soulhiler/Dengojui-Ardu/README.md

# Деньгожуй — XIAO ESP32-S3 Sense

Отдельный проект: прошивка камеры/телеметрии, привод TB6612FNG с платы, приложение **Android** (видео / мик / джойстик), скрипты на ПК (прокси, прошивка, OTA).

Воркспейс Cursor «It trane exp»; этот репозиторий — **`denzhogzhuy-ardu`**, не смешивается с веб‑тренажёром [IT](https://github.com/soulhiler/IT).

## Состав

| Путь | Назначение |
|---|---|
| `arduino_motor_test/` | **UNO + TB6612 по USB:** прошивка, веб‑джойстик, Serial — см. **`docs/arduino-motor-uno.md`** |
| `xiao_cam_stream/` | Основной скетч: Wi‑Fi, MJPEG, `/telemetry`, `/control`, `/drive`, PDM TCP :81, TB6612 (см. `drive_config.h`) |
| `xiao_cam_stream/xiao_drive.h`, `drive_config.h` | Моторы + энкодеры; TB6612 или sign‑magnitude |
| `xiao_ble_mic_test/` | Тест BLE и PDM‑микрофона |
| `xiao_cam_viewer.html` | Подсказка по просмотру потока |
| `android/XiaoRobot/` | Android: камера (`/stream`), мик (TCP `:81`), джойстик → `/drive` |
| `brain/` | ИИ‑«мозг» (Python): perceive→decide→act поверх HTTP‑контракта; `docs/brain-api.md`, 9 юнит‑тестов |
| `.github/workflows/build.yml` | CI: тесты `brain/`, сборка прошивки (`arduino-cli` + VL53L7CX), APK |
| `docs/dev-log.md` | Журнал разработки по фазам + отчёты об инцидентах |
| `docs/onboarding.md` | Инструкция новичку «с нуля» |
| `docs/security-history-cleanup.md` | Runbook чистки утёкшего Wi‑Fi пароля из git‑истории |
| `docs/cursor-chat-archives/` | Архив переписок Cursor (`.jsonl` + `.zip`) |
| `docs/hardware/wiring-xiao-motor-tof.md` | **Схема:** XIAO + TB6612 + VL53L7CX (пины, питание, GND, LPn) |
| `docs/hardware/` | **Анализ железа:** распайка, сенсоры/моторы, платы MCU/SBC, ориентация и модель пространства ([индекс](docs/hardware/README.md)) |
| `docs/incident-wifi-pc-router-2026-06-05.md` | Отчёт: сбой Wi‑Fi ПК / роутер Duangdeehouse2 / отладка XIAO (июнь 2026) |
| `tools/fix_pc_wifi_dihouse.ps1` | Восстановление профилей Duangdeehouse2 на ПК (запуск от администратора) |
| `tools/xiao_cam_proxy.py` | Прокси с платы на `localhost` (Cursor/браузер) |
| `tools/xiao_serial_telemetry.py` | Телеметрия: Serial / HTTP / BLE |
| `tools/xiao_flash_and_telemetry.ps1` | Прошивка по USB + авто‑порт USB‑JTAG + повторы upload |
| `tools/start_xiao_cam_proxy.ps1` | Фоновый прокси 8898 + опц. `/control` |
| `tools/bootstrap_arduino_cli.ps1`, `install_esp32_core.ps1` | `arduino-cli` и ядро `esp32:esp32` |
| `tools/upload_xiao_retry.ps1` | Повторная заливка при занятом COM |
| `tools/uno_motor_web.py`, `start_uno_motor_panel.ps1` | Веб‑панель джойстика для UNO (http://127.0.0.1:8765/) |
| `tools/uno_motor_serial.py` | Serial CLI для UNO+TB6612 |
| `docs/arduino-motor-uno.md` | Документация раздела UNO + моторы |
| `tools/build_apk.bat` в `android/XiaoRobot/` | См. `android/XiaoRobot/README.md` (JDK 17 / JBR) |
| `tools/xiao_wifi_ota.ps1` | OTA по Wi‑Fi |

Скопируйте `xiao_cam_stream/secrets.h.example` → `xiao_cam_stream/secrets.h` (файл в `.gitignore`).

## ⚠️ Безопасность питания (читать ПЕРЕД первой пайкой)

**Одну плату XIAO ESP32-S3 уже сожгли петлёй земли** (USB к ПК + батарея 7.4 В одновременно через общий минус → пробой ESD-защиты USB D+/D− → смерть USB-PHY). Полный разбор: [`docs/dev-log.md`](docs/dev-log.md). Чтобы не повторилось:

1. **НИКОГДА не подключай USB к ПК и батарею 7.4 В одновременно.** Прошиваешь по USB — отсоедини батарею. Тестируешь от батареи — отсоедини USB. Нужны оба — ставь USB-isolator (ADuM3160). Если USB-CDC уже мёртв, а Wi-Fi жив — шей по HTTP-OTA (`POST /update`, `tools/xiao_http_ota.py`) или ArduinoOTA `:3232`.
2. **ВСЕГДА измеряй выход DC-DC Buck мультиметром ДО подключения к XIAO 5V** — цель 5.0 В ± 0.1 В без нагрузки. Buck с AliExpress часто приходит выкрученным на 12+ В.
3. **Цвет провода = напряжение:** BAT+ (7.4 В) красный/жёлтый толстый; 5 В оранжевый тонкий; 3V3 оранжевый; GND **только чёрный**.
4. **Желательная защита** (схема цепи в [`docs/hardware/build_wiring.py`](docs/hardware/build_wiring.py)): BMS на батарее, PPTC-предохранитель + AO3401 (обратная полярность) на BAT+, Schottky SS14 на 5V, TVS USBLC6-2SC6 на USB D+/D−, осмотр пайки под лупой.

## Arduino UNO + TB6612 (USB, тест моторов)

Без XIAO/Wi‑Fi: Uno, драйвер TB6612, джойстик в браузере.

```powershell
.\tools\start_uno_motor_panel.ps1 COM3
```

→ http://127.0.0.1:8765/ · прошивка и провода: **`docs/arduino-motor-uno.md`**, каталог **`arduino_motor_test/`**.

## Прошивка XIAO

- FQBN: `esp32:esp32:XIAO_ESP32S3:PSRAM=opi`
- Версия: поля **`fw_version`** / **`fw_build`** в `GET /telemetry`
- Привод: `GET /drive?l=-255..255&r=...`, `GET /drive?stop=1`, `GET /control?...&drive=0|1`

## Android

См. **`android/XiaoRobot/README.md`**. Телефон и XIAO в одной Wi‑Fi.

## Быстрый старт Wi‑Fi

1. Заполните `secrets.h`.
2. Соберите и прошейте `xiao_cam_stream`.

Portable **`tools/arduino-cli/`** в `.gitignore`; можно запустить `tools/bootstrap_arduino_cli.ps1`.

## Телеметрия по USB

```bash
py -3 tools/xiao_serial_telemetry.py --port COM5 --http 8897
```

http://127.0.0.1:8897/

## Прокси к камере по LAN

```bash
py -3 tools/xiao_cam_proxy.py <IP_платы>
```

http://127.0.0.1:8898/ — первая строка `camera_ip.txt` = IP платы.

## Архив переписки Cursor

**`docs/cursor-chat-archives/README.md`** — формат JSONL, имена файлов и ZIP.

## Публикация на GitHub

Имя репозитория, например **`denzhogzhuy-ardu`**.

Веб‑тренажёр — отдельно: https://github.com/soulhiler/IT
