soulhiler/Dengojui-Ardu/docs/hardware/README.md

# Анализ железа

Раздел по железу проекта «Деньгожуй» (XIAO ESP32-S3 Sense): распайка, выбор
сенсоров/моторов, разбор плат-кандидатов, методы ориентации и построения модели
пространства. Часть документов — обзорные исследования (датированы, выбор позже
уточнялся в практике), часть — канон, синхронизированный с прошивкой.

Шаблон оценки новой платы — [`TEMPLATE.md`](TEMPLATE.md).

## Распайка и пины

- [**Распайка XIAO + TB6612 + VL53L7CX (+ MPU6050)**](wiring-xiao-motor-tof.md) — **канон**,
  синхронизирован с `drive_config.h`: пины моторов, I²C-шина D9/D10 (ToF + IMU), LPn, питание,
  чеклист перед включением.
- [**Схема подключения MPU6050 (GY-521)**](wiring-xiao-mpu6050-gy521.svg) — нарисованная схема
  IMU курса на общей I²C-шине (`.pdf`/`.png`/`.svg`, генератор `build_mpu6050_wiring.py`).
- [**Разводка и пины: анализ дефицита**](pinout-wiring-2026.md) — карта всех 11 пэдов XIAO, что
  занято приводом/ToF/IMU, где упрёшься при расширении, пути A (расширители) / B (гибрид).
- `build_wiring.py` — генератор схемы привода (schemdraw).

## Сенсоры и ориентация

- [**ToF VL53L7CX — лучшие практики**](vl53l7cx-best-practices.md) — конфиг, интерпретация
  `target_status`, фильтры качества, проекция зон в 3D + аудит нашего `xiao_tof.h`.
- [**Ориентация и картирование — решения**](orientation-and-mapping-decisions.md) — курс (IMU
  MPU6050/BNO085, без магнитометра), occupancy grid, когда реально нужен LiDAR. Decision-oriented.
- [**Сенсоры для робота (2026)**](sensors-2026.md) — обзорный каталог датчиков по категориям с
  привязкой к этапам автономности. _Обзор июнь-2026; конкретный выбор позже уточнён практикой
  (VL53L7CX вместо VL53L0X, MPU6050 как курс) — см. два документа выше._
- [**Моторы с энкодерами**](motors-2026.md) — выбор мотор-редукторов с AB-энкодерами (TT Encoder
  1:90, 4680 PPR) под `drive_config.h`, сколько брать на 4WD, токи, второй TB6612.

## Модель пространства и позиционирование

- [**Камера + ToF → модель пространства**](camera-tof-spatial-model.md) — конвейер построения и
  накопления 3D-модели помещения (XIAO — источник, сервер — счёт).
- [**Позиционирование по Wi-Fi**](wifi-localization-method.md) — RSSI/FTM/CSI: что реально даёт
  ESP32-S3, метод само-строящегося RSSI-отпечатка как якоря позиции.
- [**Оптимизация позиционирования и карты**](positioning-optimization.md) — разбор автоскана:
  ToF 8×8 + sharpener, релокализация курса (likelihood-field), ZUPT-bias IMU, что осталось.

## Платы: MCU vs SBC

- [**Платы для робота: MCU и SBC (2026)**](research-boards-2026.md) — сравнительный обзор двух
  классов плат, бенчмарки AI/зрения, ROS, камера/видео, питание, рекомендация гибрида MCU + SBC.
  _Обзор июнь-2026._
- [**Кандидат 1: бюджетный Linux-компаньон**](candidate-1-budget-compute.md) — разбор тира
  Pi Zero 2 W / Luckfox Pico Ultra W / Milk-V Duo: что умеют, как встроить к ESP32, грабли.
- [**Линейка Orange Pi (2026)**](orange-pi-lineup-2026.md) — детальный разбор Orange Pi как «мозга»
  Пути B (углубляет research-boards/candidate-1).
- [**Ландшафт лидаров (2026)**](lidar-landscape-2026.md) — 2D/3D-LiDAR, лестница апгрейда над
  forward-ToF, когда оправдан.
- [**Схема гибрида (Путь B)**](wiring-path-b.md) — конкретная разводка XIAO + Pi + сенсоры:
  пины, питание, I²C-адреса, линк ESP32↔Pi. Картинка: [diagrams/pinout-path-b.svg](diagrams/pinout-path-b.svg).

## Рассмотренные платы

| Плата | Класс | Вердикт | Разбор |
|---|---|---|---|
| Wireless-Tag ESP32P4C61-TINY | ESP32-P4 + ESP32-C61 (краудфандинг) | Избыточно/преждевременно — остаться на S3 | [esp32p4c61-tiny.md](esp32p4c61-tiny.md) |

## Текущее железо проекта

XIAO ESP32-S3 Sense — single-chip Arduino-решение: камера OV2640 (DVP, `esp_camera`,
MJPEG), PDM-микрофон, Wi-Fi 4 + BLE 5.0, microSD, зарядка от 3.7 В. На борту сейчас —
мультизонный ToF VL53L7CX и IMU MPU6050 (курс) на общей I²C-шине. Закрывает текущие
задачи робота; зрение/SLAM — перспектива Пути B (SBC). Подробности — в корневом `README.md`.
