soulhiler/Dengojui-Ardu/docs/hardware/power-decoupling.md

# Развязка питания: чтобы моторы не роняли плату/IMU/WiFi

**Проблема (наблюдалась в сессии 2026-06):** при бросках тока моторов плата
проседает — отваливается WiFi, дёргается IMU (MPU6050 → `imu_ok=0`), команды
`/drive` не доходят, watchdog глушит моторы. Это **петля земли + просадка общего
питания**: импульсный ток моторов (амперы) течёт по общим тонким проводам и
«земле» → просадка напряжения и помеха, которую видят чувствительные узлы (ADC
IMU, радио WiFi, MCU). Тот же корень, что в инциденте со «смертью платы» от
USB+батарея.

Лечится тремя вещами: **(1) bulk-конденсаторы** гасят броски у источника,
**(2) развязка-конденсаторы** держат чистым питание чувствительных узлов,
**(3) ЗВЕЗДА по земле** — ток моторов не течёт через землю логики/сенсоров.

---

## Топология (главное — звезда по земле)

```
Батарея(+) ─┬─────────────► TB6612 VM   (моторное питание, толстый провод)
            │
            └─► Buck ──► 5V/3V3 ──► XIAO ──► 3V3 ──► MPU6050, VL53L7CX

Батарея(−) ●  ← ЕДИНАЯ ТОЧКА ЗЕМЛИ (звезда):
            ├── земля моторов / TB6612 GND   (толстый провод, отдельно!)
            ├── земля XIAO
            └── земля сенсоров
   ВСЕ «земли» сходятся ТОЛЬКО здесь, не последовательно через XIAO.
```

**Почему звезда:** если земля моторов идёт «транзитом» через землю XIAO/сенсоров,
импульсный ток моторов создаёт на этом проводе падение напряжения (ground bounce) —
для IMU/радио это шум/просадка. Звезда уводит обратный ток моторов прямо в батарею,
мимо чувствительной земли.

---

## Конденсаторы — что и куда (по приоритету)

| # | Куда | Номинал | Тип | Зачем |
|---|---|---|-----|---|
| 1 | **TB6612 VM ↔ GND**, у самого драйвера | **1000 мкФ** (≥16 В) | электролит low-ESR | Главный bulk: гасит броски тока моторов у источника |
| 2 | **Рейл логики** (выход Buck / 5V XIAO) ↔ GND | **470 мкФ** (≥10 В) + **0.1 мкФ** | электролит + керамика | Держит питание MCU/WiFi при просадке |
| 3 | **MPU6050 VCC ↔ GND**, у модуля | **10 мкФ** + **0.1 мкФ** | керамика | Чистое питание IMU — убирает дёрганье `imu_ok` |
| 4 | TB6612 VCC(лог. 3.3В) ↔ GND | **0.1 мкФ** | керамика | Развязка логики драйвера |
| 5 | На клеммах каждого мотора | **0.1 мкФ** (×1–3) | керамика | Гасит щёточный шум/EMI мотора |

Электролиты — соблюдай **полярность** (минус-полоса к GND). Керамику ставить
**как можно ближе** к выводам узла (короткие ножки = меньше индуктивность).

---

## Провода и батарея

- **Толстые провода** на моторное питание (VM) и его землю — там амперы. Тонкие
  провода = просадка под нагрузкой (часть нашей проблемы).
- **Моторное VM — напрямую от батареи**, НЕ через buck/регулятор логики (моторы
  терпят просадку напряжения, логика — нет; и так buck не перегружается броском).
- **Батарея с запасом по току:** 2S LiPo, ёмкость ≥1000 мА·ч, разряд **≥10C**.
  Слабая/подсевшая батарея проседает под броском → brownout (что и видели — за
  сессию активной езды батарея «садилась» и плата отваливалась под мотором).
- Идеал (если возможно): **отдельная батарея на моторы** и на логику, земли — в
  одну звезду. Полностью разрывает связь «мотор → логика».

---

## Порядок внедрения (от простого к полному)

1. **Звезда по земле** (бесплатно, главный эффект): свести все GND в одну точку у
   батареи, моторную землю — отдельным толстым проводом.
2. **Cap #1 (1000 мкФ на VM)** — самый большой выигрыш от одного конденсатора.
3. **Cap #3 (10µF+0.1µF на MPU6050)** — стабилизирует IMU для heading-hold.
4. **Cap #2 (470µF+0.1µF на рейле логики)** — стабилизирует WiFi/MCU.
5. Caps #4, #5 — добивка по EMI.

После #1–#3 ожидаем: WiFi/IMU держатся под мотором → надёжный heading-hold →
контролируемые проезды → чистые замкнутые петли (B.3) и большие карты комнат.

## Проверка результата
Тест из сессии: `tools/loop_slam.py` (или импульсный спин) — раньше под мотором
шло **0–1 чтение телеметрии**; после развязки должно идти стабильно, `imu_ok`
держаться 1, `wifi_rssi` не проваливаться. ⚠ И НИКОГДА USB+батарея одновременно
(петля земли — отдельный известный инцидент, см. docs/security/power).
