soulhiler/Dengojui-Ardu/docs/hardware/motors-2026.md

# Моторы с энкодерами для «Деньгожуй» (2026)

> Выбор мотор-редукторов с квадратурными энкодерами под текущую прошивку (`drive_config.h`
> рассчитан на AB-энкодеры `DRIVE_ENC_*_A/B`, привод TB6612, дифференциальный 4WD/skid-steer).
> Итог: брать **TT Motor с AB-энкодером (чёрный, 1:90 / 175 об/мин)**, 2 шт. с энкодером на 4WD.

## Зачем именно энкодерные

Прошивка считает **квадратуру A/B** → скорость **и направление**. Поэтому:
- ❌ обычный мотор + щелевой ИК-диск (LM393) = один канал, без направления — не подходит.
- ✅ нужен мотор с **холловским AB-энкодером** (6 проводов: M+, M−, VCC, GND, A, B).

Показанные в магазине обычные TT/JB (JB207/JB209, жёлтый MT048, чёрный 1:48) — **без энкодеров**.

## Сравнение двух энкодерных вариантов

| | Вариант 1 (синий, метал 110rpm) | **Вариант 2 (чёрный TT Encoder)** ✅ |
|---|---|---|
| Энкодер AB | да, **PPR не указан** (обычно низкий) | да, **2 496 PPR (1:45) / 4 680 PPR (1:90)** на оборот колеса |
| Разъём | голые 6 проводов | **JST PH2.0 6-pin + кабель** (plug-and-play) |
| Шестерни | полный металл | полуметалл (металл+пластик) |
| Напряжение мотора | 6–12 В | **3–12 В** |
| Питание Холла | 3.3–5 В | 3.3–5 В |
| Вал | двухвальный (แกนคู่) | одновальный |
| Документация PPR | нет | есть (Yahboom encoder) |
| Цена | ฿208 | ฿279 |

**Выбор: Вариант 2 (чёрный), вариация 1:90 / 175 об/мин / 4 680 PPR** — высокое и документированное
разрешение энкодера (точная одометрия под будущий SLAM) + готовый разъём. 1:45/350 об/мин — только
если нужна скорость в ущерб моменту/точности.

## Спецификация выбранного (чёрный TT Encoder, 1:90)

| Параметр | Значение |
|---|---|
| Передаточное / скорость | 1:90 / 175 об/мин @6 В |
| Момент | ~2.4 kgf·cm |
| Напряжение мотора | 3–12 В (на 7.4 В 2S работает напрямую) |
| Ток | без нагрузки ≤200 мА, **стопор ~1.2 А** |
| Энкодер | магнитный Холл, AB-квадратура, square wave |
| Питание энкодера | 3.3–5 В (→ ESP32 напрямую) |
| Разрешение | **4 680 PPR** на оборот выходного вала |
| Разъём | JST PH2.0 6-pin (кабель в комплекте) |

## Совместимость и распиновка (под `drive_config.h`, без правок прошивки)

- **3–12 В мотор** → VM TB6612 = аккумулятор 7.4 В (отдельный buck на моторы не нужен).
- **Энкодер 3.3–5 В** → прямо в ESP32 (без преобразователя уровней).
- **AB-квадратура** → совпадает с `DRIVE_ENC_*_A/B`.

```
Encoder VCC → 3.3 В (ESP32 3V3)        Encoder GND → GND (общая)
Phase A (жёлтый) → D6/GPIO43 (лев.) , D8/GPIO7  (прав.)
Phase B (синий)  → D7/GPIO44 (лев.) , D9/GPIO8  (прав.)
Motor + (красный) / Motor − (чёрный) → TB6612 AO1/AO2 (лев.) , BO1/BO2 (прав.)
```
Колесо крутится «не туда» → поменять M+/M− (направление) или A/B (знак счёта).

## Сколько брать на 4 мотора (4WD)

Привод **дифференциальный (skid-steer)**: оба колеса борта вращаются синхронно, поэтому одометрии
хватает **одного энкодера на сторону** → **2 энкодерных мотора (1 левый + 1 правый)**, остальные 2 —
обычные. 4 энкодера нужны только при независимом управлении каждым колесом (меканум/полный 4WD), чего
в нашей прошивке нет.

⚠️ **Все 4 мотора на бортах должны быть одинаковые по об/мин** — два мотора одной стороны работают
параллельно на одном канале; разные модели «дерутся» (один тянет, другой тормозит). Идеально — все 4
одной модели (TT 1:90), из них 2 с энкодером + 2 без.

## ⚠️ Ток и драйвер при 4 моторах

2 мотора на канал = ток складывается. TT-мотор стопор ~1.2 А ×2 = ~2.4 А, а **TB6612 держит ~1.2 А
непрерывно на канал** (3.2 А пик) → один TB6612 на 4 мотора **на пределе**.

**Решение без новых пинов:** поставить **второй TB6612**, а его 6 логических входов завести
**параллельно** первому (те же D0–D5). Тогда каждый драйвер крутит по 2 мотора (один на сторону),
ток делится между драйверами, а **GPIO не добавляется** (важно — на XIAO свободных пинов нет, см.
[pinout-wiring-2026.md](pinout-wiring-2026.md)). Альтернатива — более мощный драйвер (напр. сдвоенный).

## Отдельные энкодеры на TT-мотор (ретрофит к имеющимся)

Если не менять текущие 4 мотора, а **докрутить энкодер**. Главное: прошивка считает квадратуру A/B
(направление + скорость), а большинство «отдельных» энкодеров — одноканальные (только скорость).

| Решение | Тип | Канал | Разрешение | Куда ставится | Цена 2026 | Под нашу прошивку |
|---|---|---|---|---|---|---|
| **FC-03 / LM393 + щелевой диск** | оптика | **1 (скорость)** | низкое: 20/об на колесе | диск на валу + модуль на шасси | ~$1–2 | ⚠️ нет направления → правка кода |
| 2× FC-03 со сдвигом 90° | оптика | 2 (квадратура) | низкое | сложно выставить | ~$3 | теоретически да, возни много |
| **AS5600 магнитный** | холл, абс. угол | угол/направление | **высокое (4096/об)** | магнит на торце вала + плата соосно | ~$3–6 | ✅ но I²C-адрес фикс. 0x36 → на 2 колеса нужен TCA9548A/PWM |
| Hall AB кольцо | холл | 2 (квадратура) | высокое | кольцо на **задний вал** | ~$3–5 (найти сложно) | ✅ но это по сути и есть «энкодер-мотор» |

**Что важно:**
- **Нужен задний (двухвальный) вал** — AS5600/Hall-кольцо/диск на быстром валу ставятся на задний
  вал. Одновальный мотор → только внешний диск на колесе (один канал, грубо).
- **Разрешение зависит от места:** щелевой диск на колесе = 20/об; на заднем (быстром) валу =
  20 × передаточное (×90 ≈ 1800/об колеса). У интегрированного энкодера — тысячи/об.
- **Одноканальный = нет направления:** FC-03 даёт только скорость → в прошивке брать направление из
  знака команды (`gDrive.cmd`); не определит проскальзывание/толчок назад.
- **AS5600:** лучший «отдельный» по точности и с направлением, но фикс. адрес 0x36 (мультиплексор/PWM
  на 2 колеса) и соосный монтаж магнита; на XIAO ещё и дефицит пинов (см.
  [pinout-wiring-2026.md](pinout-wiring-2026.md)).
- **EMI:** щётки наводят помехи на оптику → 100 нФ на питание датчика, короткие/экранированные провода.

**Плюс ретрофита:** все 4 мотора остаются одной модели → нет проблемы «моторы на борту дерутся».

**Вердикт по ретрофиту:**
- Двухвальные моторы → AS5600 на задний вал (направление + 4096/об) или щелевой диск (скорость).
- Одновальные → проще купить 2 энкодер-мотора, чем колхозить.
- Истинная квадратура ретрофитом по цене+возне ≈ новый энкодер-мотор ($6–8), но механика хуже.

## Открытые вопросы (уточнить перед покупкой)

- **Модель/обороты текущих 4 моторов** — чтобы решить: докупить 2 энкодерных совпадающих или менять
  весь комплект на одинаковые.
- **Одно- или двухвальные** текущие моторы — от этого зависит, реален ли ретрофит энкодера.
- **Точный PPR/число полюсов** энкодера — для пересчёта тиков на оборот колеса в одометрии.
- Нужен ли **второй TB6612** (по току) — см. выше.

## Источники

- [DFRobot FIT0450 — TT с энкодером](https://wiki.dfrobot.com/fit0450/),
  [Yahboom TT Encoder motor (docs)](http://www.yahboom.net/study/Encoder-TT-motor),
  [Adafruit N20 magnetic encoder (альтернатива)](https://www.adafruit.com/product/4640),
  [квадратурный энкодер + Arduino](https://zbotic.in/motor-encoder-interfacing-quadrature-encoder-with-arduino/)
- Ретрофит-энкодеры — [FC-03/LM393 IR speed sensor](https://www.teachmemicro.com/lm393-ir-module-motor-speed-sensor/),
  [оптика vs магнитный энкодер](https://zbotic.in/motor-speed-sensor-optical-vs-magnetic-encoder-comparison/),
  [AS5600 (Seeed wiki)](https://wiki.seeedstudio.com/Grove-12-bit-Magnetic-Rotary-Position-Sensor-AS5600/)
- TB6612FNG — [Toshiba datasheet](https://toshiba.semicon-storage.com/info/TB6612FNG_datasheet_en_20141001.pdf)
  (1.2 А/канал непрерывно, 3.2 А пик)
