soulhiler/Dengojui-Ardu/docs/hardware/lidar-landscape-2026.md

# Ландшафт лидаров 2026: контекст и лестница апгрейда

> Конспект внешнего обзора (июнь 2026) — что полезно нашему проекту. Наша
> рабочая рекомендация по картам остаётся в `orientation-and-mapping-decisions.md`
> (2D LD06/LD19 ~$70 + 4-ГБ SBC). Этот файл — **тир выше** и индустриальный
> контекст: куда расти, если 2D-среза не хватит.
>
> ⚠ Цены — розничные ориентиры на июнь 2026 с реселлеров, быстро меняются;
> перепроверять перед покупкой. Источник — обзор-сводка, не первичные даташиты.

## Почему это важно знать

Наша SLAM-ветка стартует с дешёвого **2D-лидара** (плоский срез, LD06/LD19).
Его потолок — одна горизонтальная плоскость: видит стены на своей высоте, не
видит низкие/высокие препятствия и геометрию объёма. Когда упрёмся в это —
следующая ступень — **3D-лидар** (облако точек). Ниже — где сидят ступени.

## Лестница моделей (розница, не автомобильные OEM)

| Модель | Цена~ | Тип | Покрытие / дальность | Кому |
|---|---|-----|---|---|
| **LD19 / LD06 / RPLIDAR A1** | **~$70–200** | 2D механика | плоский срез, ~12 м | **наш вход** (2D SLAM) |
| **Unitree 4D L2** | ~$395 | 3D вращающийся | 360°, ~30 м | **дешёвый вход в 3D-облако** |
| **Livox Mid-360** | от ~$899 | гибрид solid-state | **360°×59°, 100 м (40 м @10%)**, мин. 10 см, IP67 | **стандарт мобильной робототехники** |
| RoboSense Airy | от ~$1099 | solid-state | 96 лучей, 360° | плотнее Mid-360 |
| Livox Mid-70 / Avia | ~$1.3k / ~$2.1k | гибрид solid-state | узкий FOV, до 450 м (Avia) | дальность, дроны |
| Ouster OS1 | неск. тыс. | цифровой механич. | 64/128 кан., 90 м @10% | западная поддержка, маппинг |
| Emesent Hovermap STX | десятки тыс. | турнкей-SLAM | 300 м, >1 млн точек/с | enterprise, пещеры под ключ |

**Ключевые ступени для нас:**
- **2D → 3D дёшево:** Unitree L2 (~$395) — учебный вход в облако точек; вертикальный обзор узкий, дальность скромная, но понятно «чего не хватает».
- **Чемпион баланса:** **Livox Mid-360** (~$899) — де-факто стандарт; под него заточена open-source SLAM-экосистема (**FAST-LIO / Point-LIO работают из коробки**). Реселлеры прямо позиционируют как замену Velodyne VLP-16 / Ouster OS1-16: новее, дешевле, вдвое шире вертикаль. Вращается только маленькое зеркало внутри.

> Для нашего класса робота Mid-360 — избыточен (цена ≈ всего остального робота
> ×10 и питание/вес другого порядка). Это «когда вырастем в серьёзный маппинг»,
> а не сейчас. Сейчас потолок здравого смысла — 2D LD06/LD19.

## Технологический ликбез (общее)

- **ToF** (time-of-flight): импульс → время возврата → дистанция. Дёшево, доминирует
  (наш LD06/LD19 и VL53L7CX — оба ToF). Минусы: уязвим к солнцу/чужим лидарам, не
  видит скорость.
- **FMCW** (4D): непрерывный луч с качающейся частотой; на возврате — частота биений
  → сразу дистанция **и доплеровская скорость** каждой точки. Когерентное
  детектирование → не слепнет от солнца и соседних лидаров. Расплата — дорогой
  лазер/фотоника. Растёт быстро, но дорого; для хобби пока не вход.
- **«Solid-state» — грязный термин:** большинство «solid-state» на рынке —
  **полу-твердотельные** (неподвижный корпус, но внутри MEMS-зеркало/призма
  крутятся). True solid-state (flash, OPA) пока упирается в дальность/цену.

## Расклад индустрии (зачем нам — доступность и цены)

- **Цены рухнули, рынок в Китае:** RoboSense/Hesai/Huawei/Seyond держат >99% авто-рынка;
  Hesai режет прайс ~вдвое, RoboSense вывел серию MX дешевле $200. Запад буксует
  (Velodyne+Ouster слились в 2023, Quanergy банкрот). Для нас = дешёвые модули
  доступны и дешевеют.
- **Лидар пивотит из машин в роботов:** часть автопрома (Tesla) ушла в чистое
  зрение, производители агрессивно идут в робототехнику (Hesai XT в роботах Unitree,
  у RoboSense робо-поставки ×27 за год). Восприятие для роботов может стать
  категорией крупнее авто-лидара → больше дешёвого железа под наши задачи в ближайшие годы.

## Что это меняет в наших решениях

Ничего в ближней перспективе: для нашего робота остаётся **2D LD06/LD19 (~$70) +
4-ГБ SBC + slam_toolbox** (см. `orientation-and-mapping-decisions.md`). Этот документ —
карта ступеней над нами: если 2D-срез окажется мал → **Unitree L2 (~$395) для 3D**,
а «взрослый» маппинг (FAST-LIO) — это уже **Livox Mid-360 (~$899)**, другой класс
бюджета/питания. FMCW/Mid-70/Ouster/Hovermap — вне нашего тира, держим как контекст.

---

*Источник: внешний обзор-сводка (рыночные отчёты Mordor/Polaris/SNS/Straits,
Yicai/SCMP, страницы Livox/Ouster/Emesent и реселлеров, eBay по б/у). Цифры и цены —
на дату документа, требуют перепроверки.*
