soulhiler/Dengojui-Ardu/docs/hardware/orange-pi-lineup-2026.md

# Linux-компаньон: вся линейка Orange Pi (обзор 2026)

> Контекст: к роботу на **XIAO ESP32-S3** рассматриваем маленький Linux-компьютер
> для зрения/CV — ESP32 остаётся «спинным мозгом» (моторы, ToF, мик, realtime),
> Linux берёт камеру/детекцию/сеть. Этот файл — разбор всей линейки **Orange Pi**
> как одного из кандидатов. Сравнение с Raspberry Pi и другими — в
> ветке исследования `docs/hardware/research-boards-2026.md` (Путь B).

## Про бренд

Orange Pi (Shenzhen Xunlong) — большое семейство одноплатников на чипах
**Allwinner** и **Rockchip**. Почерк: характеристики/цена лучше Raspberry Pi,
расплата — **софт**. Вместо вылизанного Raspberry Pi OS здесь Armbian /
Orange Pi OS: камеру, драйверы, ISP часто приходится доводить руками, комьюнити
меньше. Для проекта это главный риск (камера/CV — вся суть компаньона).

## 1. Zero-серия — маленькие, дешёвые (наша зона)

| Плата | SoC | RAM | Сеть | Размер | Для робота |
|---|-----|-----|---|---|---|
| Zero / Zero LTS | H2+/H3, 4×A7 | 256–512 МБ | — | мини | ❌ старое |
| **Zero 2** | H616, 4×A53 1.5 ГГц | 512 МБ / 1 ГБ | Gigabit Eth | 53×60 мм | ⚠ крупнее, Ethernet лишний |
| **Zero 2W** | H618, 4×A53 1.5 ГГц | 1 / 1.5 / 2 / **4 ГБ** LPDDR4 | Wi-Fi 5 + BT 5 | **30×65 мм** | ✅ **лучший фит** |
| **Zero 3** | H618, 4×A53 | 1–4 ГБ | Gigabit Eth | 50×55 мм | ⚠ как 2W, но крупнее + Ethernet |

«W» = компактный Pi-Zero-формат без Ethernet. Без W — крупнее, с Ethernet
(мини-сервер, не мобильный робот).

## 2. Мейнстрим — формат Pi 3/4

| Плата | SoC | RAM | Фишка |
|---|-----|-----|---|
| Orange Pi PC / One / Lite | H3 | 0.5–1 ГБ | старые, дёшево |
| Orange Pi 3 LTS | H6, 4×A53 | 2 ГБ + 8 ГБ eMMC | Gigabit, eMMC на борту |
| Orange Pi 4 LTS | RK3399, 2×A72+4×A53 | 4 ГБ | мощнее, прожорлив |
| **Orange Pi 3B** | RK3566, 4×A55 1.8 ГГц | 2 / 4 / 8 ГБ | **NPU 0.8 TOPS**, M.2 NVMe |

## 3. Флагманы — серьёзный AI (RK3588)

| Плата | SoC | RAM | NPU |
|---|-----|-----|-----|
| Orange Pi 5 / 5B | RK3588S, 4×A76+4×A55 | до 16/32 ГБ | **6 TOPS** |
| Orange Pi 5 Plus / 5 Max | RK3588 (полный) | до 32 ГБ | 6 TOPS, 2.5GbE, M.2 |
| Orange Pi 5 Pro / Ultra | RK3588(S) | разные | 6 TOPS |
| Orange Pi CM5 | RK3588S (модуль) | — | 6 TOPS |

«Настоящий мини-ПК»: YOLO в реальном времени, несколько камер, 8K. Но большой,
греется, ест 5–10+ Вт, нужно отдельное питание — для маленького робота избыточно.

## 4. Специальные

- **Orange Pi AI Pro** — Huawei Ascend, **8 или 20 TOPS**, 8–24 ГБ; под edge-инференс, крупный.
- **Orange Pi RV / RV2** — RISC-V (софт ещё сырее).
- **Orange Pi 800** — плата в клавиатуре (как Pi 400).
- **Orange Pi Neo** — игровая «портативка».
- **CM4 / CM5** — compute-модули (RK3566 / RK3588S) под свою плату-носитель.

## Вывод под наш робот

- **Лёгкий компаньон по зрению к XIAO** → **Zero 2W на 4 ГБ** — единственный из
  Orange, что подходит по размеру/весу/питанию; 4 ГБ закрывают узкое место по RAM.
- **Хочешь NPU компактно** → **Orange Pi 3B** (0.8 TOPS, M.2), но это размер Pi 4.
- **Серьёзный AI, размер не важен** → **Orange Pi 5** (6 TOPS), другой класс робота
  с нормальным питанием.

Альтернатива без софт-боли — **Raspberry Pi Zero 2 W** (512 МБ, но «всё работает»):
наша записка `candidate-1-budget-compute.md` (ветка исследования) выбрала именно его
за экосистему/простоту. Решение Orange vs RPi = «больше RAM/дешевле, но возня» против
«слабее железо, но без боли с камерой».
