soulhiler/Dengojui-Ardu/docs/hardware/diagrams/pinout-path-b.png

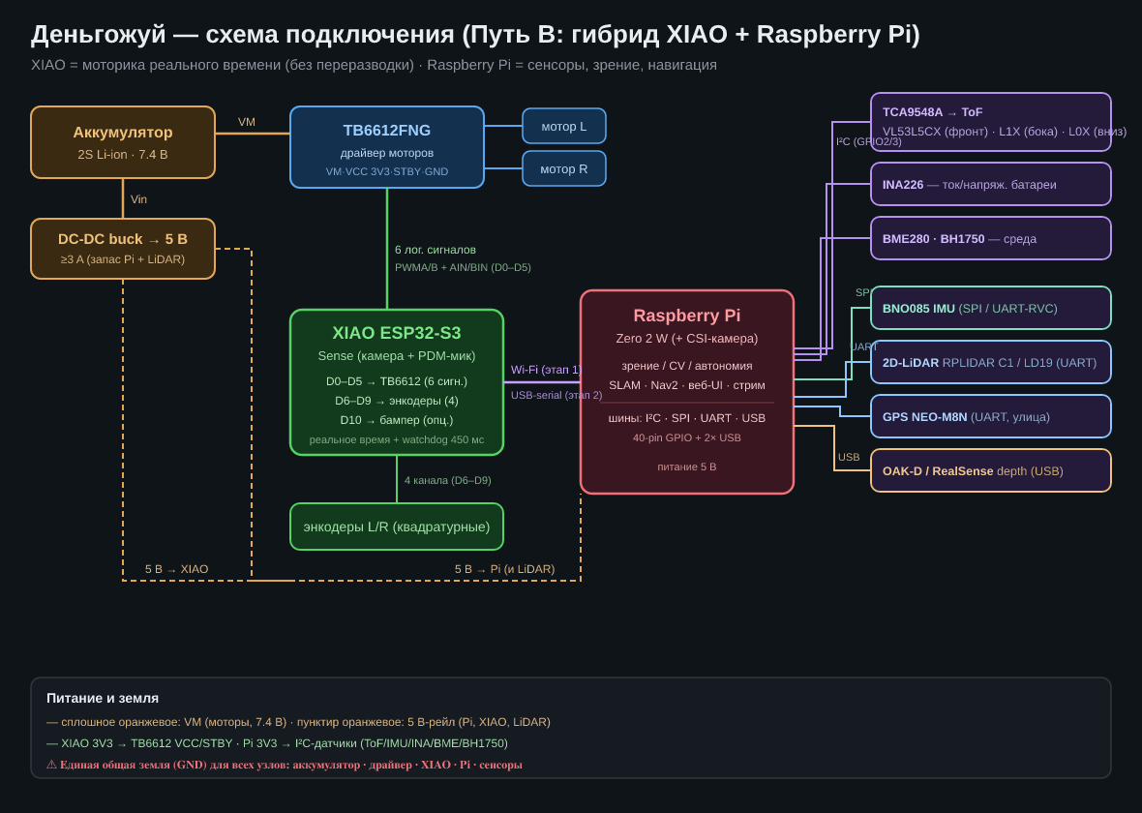
docs/hardware/diagrams/pinout-path-b.png
