soulhiler/Dengojui-Ardu/docs/hardware/wiring-xiao-motor-tof.md

# Распайка: XIAO ESP32-S3 + TB6612 + VL53L7CX

Пины из **`xiao_cam_stream/drive_config.h`** (прошивка build 16+, ToF — **VL53L7CX**, мультизонный 4×4/8×8).

> Работает и **с камерой Sense**, и без: все сигналы ниже идут только на внешние пины D0–D10. Внутренние линии камеры (GPIO 10–18, 38–48), мик (41–42) и LED (21) не трогать.

---

## Общая схема (блоки)

```mermaid
flowchart LR
  subgraph power["Питание"]
    USB["USB 5V → XIAO"]
    BAT["Батарея 6–12 V → VM"]
    GND["Общая GND"]
  end

  subgraph xiao["XIAO ESP32-S3"]
    MCU["Логика 3.3 V"]
  end

  subgraph drv["TB6612FNG"]
    STBY["STBY"]
    VM["VM"]
    VCC["VCC 3.3 V"]
  end

  subgraph mot["Моторы DC"]
    ML["Левый"]
    MR["Правый"]
  end

  subgraph tof["VL53L7CX"]
    I2C["I2C + LPn"]
  end

  USB --> MCU
  MCU --> VCC
  MCU --> STBY
  BAT --> VM
  GND --- MCU
  GND --- drv
  GND --- BAT
  VM --> ML
  VM --> MR
  drv --> ML
  drv --> MR
  MCU -->|"PWM + DIR"| drv
  MCU -->|"SDA/SCL"| I2C
```

---

## Питание и земля

```
                    ┌─────────────────┐
   USB 5V ──────────│ 5V   XIAO   GND │──────────┐
                    │ 3V3          │          │
                    └───────┬──────┘          │
                            │                 │
                     3.3 V ─┼─ VCC TB6612    │
                     3.3 V ─┼─ STBY (или    │
                            │   перемычка)  │
                            │                 │
   Батарея 6–12 V ── VM ───┤ TB6612          │
   (только моторы!)         │                 │
                            └──── GND общая ◄┘
                                   │
                            VL53L7CX GND
```

| Точка | Куда | Примечание |
|---|---|---|
| **GND** | XIAO GND = GND TB6612 = GND VL53L7CX = «−» батареи VM | **Обязательно общая земля** |
| **3V3** XIAO | TB6612 **VCC** (логика), VL53L7CX **VIN** + **LPn** | Только 3.3 V: при питании 5 V подтяжки SDA/SCL уйдут на 5 V — пины ESP32 не 5V-tolerant |
| **5V** XIAO | Не кормить TB6612 VM | 5V — только USB/плата |
| **VM** TB6612 | Батарея 6–12 V (или отдельный БП моторов) | Силовое питание моторов |
| **USB + батарея одновременно** | Избегать | Риск просадки/контуров; одна XIAO уже сгорала при плохой разводке GND |

`DRIVE_STBY_PIN = -1` → **STBY закоротить на 3.3 V** (драйвер всегда включён).

---

## TB6612 ↔ XIAO (моторы)

```mermaid
flowchart TB
  subgraph XIAO["XIAO (подпись на плате)"]
    D0["D0  GPIO1"]
    D1["D1  GPIO2"]
    D2["D2  GPIO3"]
    D3["D3  GPIO4"]
    D4["D4  GPIO5"]
    D5["D5  GPIO6"]
    D8["D8  GPIO7"]
    D6["D6  GPIO43"]
    D7["D7  GPIO44"]
  end

  subgraph TB["TB6612FNG"]
    PWMA["PWMA"]
    AIN1["AIN1"]
    AIN2["AIN2"]
    PWMB["PWMB"]
    BIN1["BIN1"]
    BIN2["BIN2"]
  end

  D5 --> PWMA
  D0 --> AIN1
  D1 --> AIN2
  D4 --> PWMB
  D2 --> BIN1
  D3 --> BIN2

  PWMA --> MA["Мотор A (левый)"]
  AIN1 --> MA
  AIN2 --> MA
  PWMB --> MB["Мотор B (правый)"]
  BIN1 --> MB
  BIN2 --> MB
```

| TB6612 | XIAO (шелк) | GPIO | Роль |
|---|---|---|---|
| **PWMA** | **D5** | 6 | ШИМ левый |
| **AIN1** | **D0** | 1 | Левый, направление |
| **AIN2** | **D1** | 2 | Левый, направление |
| **PWMB** | **D4** | 5 | ШИМ правый |
| **BIN1** | **D2** | 3 | Правый, направление |
| **BIN2** | **D3** | 4 | Правый, направление |
| **STBY** | **3.3 V** | — | HIGH = драйвер активен |
| **VCC** | **3.3 V** | — | Логика |
| **GND** | **GND** | — | |
| **VM** | **6–12 V** | — | Питание моторов |
| **AO1, AO2** | Левый мотор | | |
| **BO1, BO2** | Правый мотор | | |

Полярность моторов: если едет «назад» — поменять местами провода **AO1↔AO2** или **BO1↔BO2**.

---

## MPU6050 (GY-521) ↔ XIAO — IMU курса (на той же I2C-шине)

MPU6050 садится на **ту же** шину I2C, что и ToF — лишних пинов нет.
Адреса не конфликтуют: **MPU6050 = 0x68**, VL53L7CX = 0x29.

Нарисованная схема (стиль KiCad, MPU6050 + ToF на общей шине):
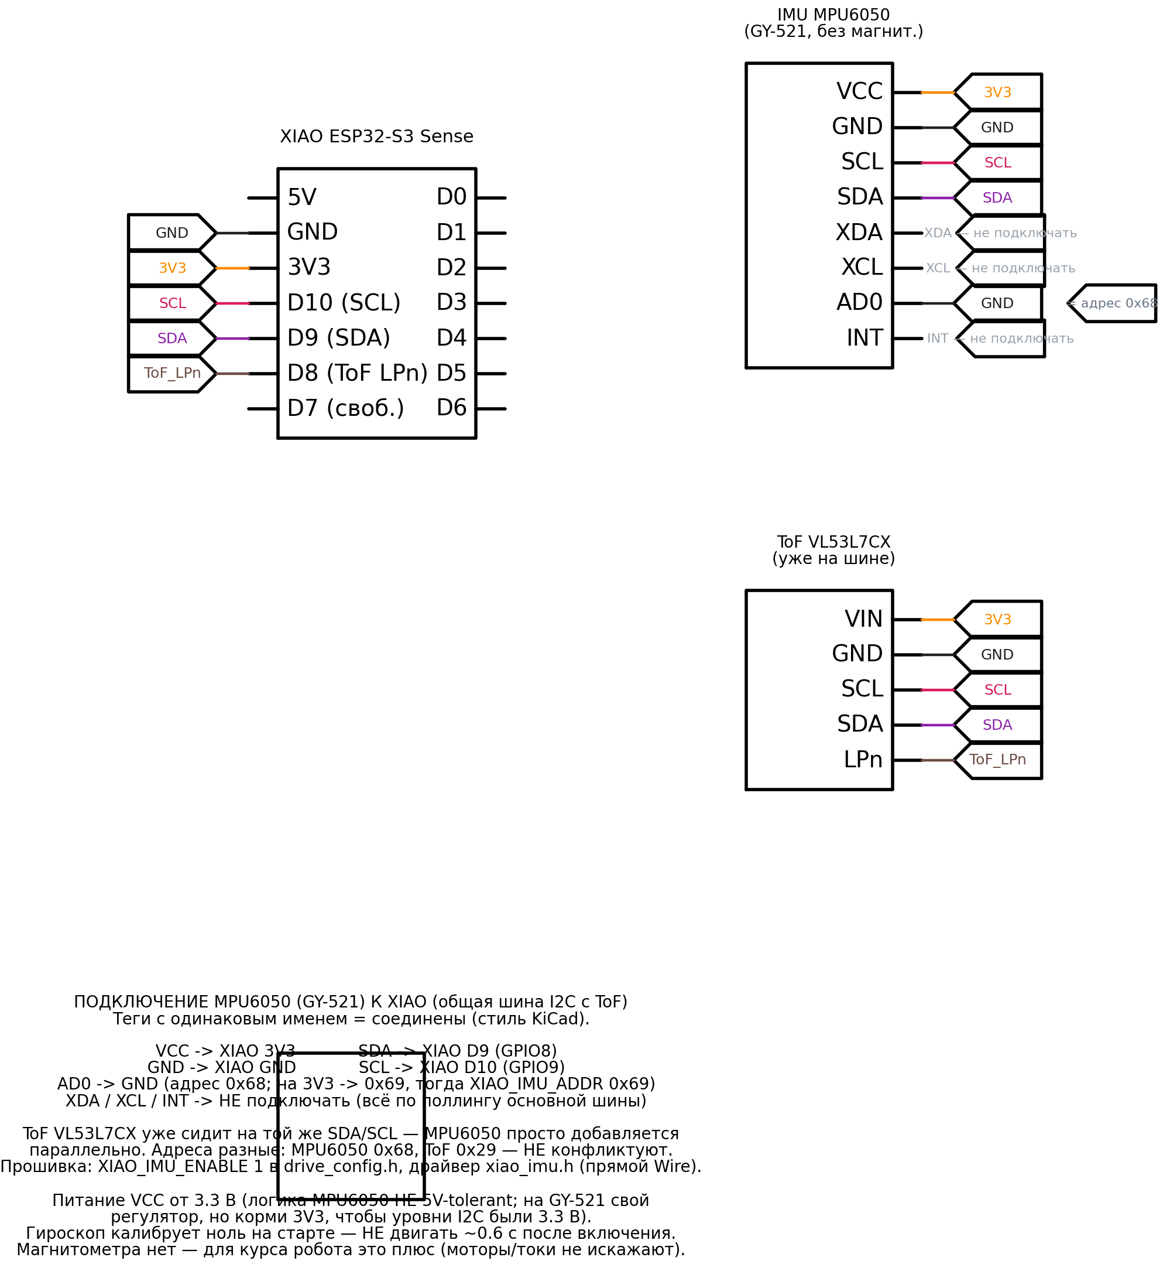
[picture p2: docs/hardware/wiring-xiao-mpu6050-gy521.png]
Схема MPU6050 ↔ XIAO

(исходник генератора — [`build_mpu6050_wiring.py`](build_mpu6050_wiring.py); PDF/SVG рядом)

| MPU6050 | XIAO | Примечание |
|---|---|---|
| **VCC** | **3V3** | логика 3.3 В (на GY-521 свой регулятор, но корми 3V3) |
| **GND** | **GND** | общая земля |
| **SDA** | **D9 / GPIO8** | та же линия, что SDA ToF |
| **SCL** | **D10 / GPIO9** | та же линия, что SCL ToF |
| INT | — | не подключать (поллинг) |
| AD0 | GND/не подключать | адрес 0x68 (AD0=1 → 0x69, тогда `XIAO_IMU_ADDR 0x69`) |

Прошивка: `XIAO_IMU_ENABLE 1` в `drive_config.h`; драйвер `xiao_imu.h` (прямой Wire).
Даёт курс `imu_yaw` в `/telemetry` (калибровка нуля гиро на старте — не двигать ~0.6 с).
⚠ Если на обоих брейкаутах (ToF и GY-521) свои подтяжки SDA/SCL — на 400 кГц обычно
ок; при сбоях I2C снять перемычку подтяжки с одного модуля.

---

## VL53L7CX ↔ XIAO (мультизонный ToF 4×4/8×8)

Подписи на модуле (сверху вниз): **VIN · GND · SCL · SDA · INT · LPn**.

```mermaid
flowchart LR
  subgraph X["XIAO"]
    D9["D9  GPIO8  SDA"]
    D10["D10 GPIO9  SCL"]
    V33["3V3"]
    G["GND"]
  end

  subgraph V["VL53L7CX"]
    VIN["VIN"]
    GND["GND"]
    SCL["SCL"]
    SDA["SDA"]
    INT["INT"]
    LPN["LPn"]
  end

  V33 --- VIN
  G --- GND
  D10 --- SCL
  D9 --- SDA
  V33 --- LPN
```

| VL53L7CX | XIAO | GPIO | Примечание |
|---|---|---|---|
| **VIN** | **3V3** | — | Не 5 V (см. питание выше) |
| **GND** | **GND** | — | |
| **SCL** | **D10** | **9** | |
| **SDA** | **D9** | **8** | |
| **LPn** | **3V3** | — | **Обязательно HIGH**, иначе сенсор молчит на I2C. Либо на GPIO → `XIAO_TOF_LPN_PIN` |
| INT | — | — | Не подключать (прошивка опрашивает по таймеру) |

Старт занимает ~2–3 с: при инициализации в сенсор по I2C грузится ~84 КБ
прошивки ST — это нормально (в Serial будет `tof: VL53L7CX OK`).
Дальность до ~3.5 м, поле зрения 60°; прошивка отдаёт минимум по центральной
полосе зон как `tof_mm` (совместимо со старым VL53L0X) и полную сетку в `GET /tof`.

### Запрещено

| Пины | Почему |
|---|---|
| **GPIO19, GPIO20** (D7/D8 на некоторых шелкографиях — **проверьте свою плату**) | Линии **USB D− / D+** → после `Wire.begin` **пропадает COM** |
| **GPIO39, GPIO40** | Шина **камеры** (SCCB) на Sense |
| **GPIO8 для энкодера R_B** | Занят под **SDA ToF** (`DRIVE_ENC_R_B = 0`) |
| **5 V на VIN/LPn ToF** | Подтяжки модуля уйдут на 5 V — пины ESP32-S3 не 5V-tolerant |

На модуле XIAO **D9 = GPIO8**, **D10 = GPIO9** — подключайте ToF именно туда, **не** к «крайним» USB-пинам 19/20.

---

## Энкодеры (опционально)

| Сигнал | XIAO | GPIO | Статус |
|---|---|---|---|
| Левый A | **D6** | 43 | Включён |
| Левый B | **D7** | 44 | Включён |
| Правый A | **D8** | 7 | Включён |
| Правый B | — | 8 | **Отключён** (конфликт с SDA ToF) |

Энкодер: **3.3 V**, GND, каналы A/B → соответствующие GPIO (внутренняя подтяжка или внешние 10 kΩ к 3.3 V — по вашему модулю).

---

## Вид сверху (логические связи)

```
                    [ VL53L7CX ]
                VIN GND SCL SDA LPn(3V3)
                      │  │   │   │
                      └──┼───┼───┼──────────────┐
                         │   │   │              │
    [ Батарея 6-12V ]────┼───┼───┼── VM          │
           │             │   │   │              │
           └─ GND ────────┴───┴───┴── GND ───────┤
                                                 │
              ┌──────────────────────────────────┴──┐
              │         XIAO ESP32-S3               │
              │  D0-D5 ──────────────► TB6612      │
              │  D9,D10 ─────────────► ToF I2C     │
              │  D6,D7,D8 ───────────► энкодеры    │
              │  USB (прошивка / Serial)           │
              └────────────────────────────────────┘
                         │
              ┌──────────┴──────────┐
              │      TB6612FNG       │
              │  AO1 AO2    BO1 BO2  │
              └───┬───┬──────┬───┬───┘
                  │   │      │   │
               [Левый] [Правый мотор]
```

---

## Чеклист перед включением

1. **GND общая** у XIAO, TB6612, VL53L7CX и источника VM.
2. ToF на **D9/D10 (GPIO8/9)**, не на 19/20; **LPn → 3.3 V**.
3. **VM** не подключать к 5V XIAO.
4. STBY TB6612 = **HIGH** (3.3 V).
5. Первый запуск моторов — **низкая скорость** в `/drive` или джойстике.
6. Прошивка: `XIAO_TOF_ENABLE 1`, `XIAO_DRIVE_ENABLE 1` в `drive_config.h`; библиотека **«STM32duino VL53L7CX»** (`arduino-cli lib install "STM32duino VL53L7CX"`).

---

## Связанные файлы

- `xiao_cam_stream/drive_config.h` — все `#define` пинов
- `xiao_cam_stream/xiao_tof.h` — `#error` при GPIO19/20
- `docs/incident-wifi-pc-router-2026-06-05.md` — инцидент USB/GPIO20
