soulhiler/Dengojui-Ardu/docs/dev-log.md

# Журнал разработки «Деньгожуй»

Краткий лог по фазам роадмапа. Обновляется на каждом рубеже фазы
(commit + push фиче-ветки). Записи —
новые сверху. Инцидент безопасности — `docs/security-history-cleanup.md`.

---

## 2026-06-27 — Фикс авто-видео: по адресу клиента, не по STA (fw 1.5.7, ждёт заливки)

Баг 1.5.6: лёгкий профиль включался по условию `gApOnly || STA не подключён`. Но если робот на
батарее **в зоне дома** — он в apsta (STA подключён!), а телефон на его точке → условие ложно →
камера остаётся в тяжёлом SVGA → по узкой точке **видео не грузится и лагает** (симптом юзера).

Фикс: в `streamTcpTask` решаем по **IP клиента стрима** — `c.remoteIP()` в подсети точки
(`192.168.4.x` = `WiFi.softAPIP()` /24) → QVGA; иначе SVGA. Теперь телефон на точке всегда
получает лёгкий кадр, независимо от STA. Скомпилировано (EXIT=0); ждёт заливки (робот на батарее).

---

## 2026-06-27 — Авто-лёгкое видео на SoftAP (fw 1.5.6, проверено на железе)

Симптом: в прямом режиме тормозит **и приложение, и веб-страница робота**. Значит узкое место —
видео по слабой точке робота, а его веб-страница отдаёт камеру в дефолте (по телеметрии
framesize 11 ≈ HD) — для SoftAP тяжело. Правки приложения (keep-alive/телеметрия) веб не лечат.

Фикс в прошивке: `xiaoCamApplyProfile(lite)` + авто-переключение в `streamTcpTask` — если робот
доступен только через свою точку (`gApOnly || WiFi.status()!=WL_CONNECTED`), камера сама уходит
в **QVGA q15**; на домашнем WiFi — SVGA q12. Так и веб, и приложение получают лёгкий поток без
настроек.

**Проверено на железе** (залито по USB COM7, fw 1.5.6 загрузилась). Замеры потока (порт :82,
домашний WiFi −51 dBm; шумят ±, но тренд чёткий — решает РАЗМЕР кадра):

| Профиль | Кадр | FPS | Полоса |
|---|---|---|---|
| HD/SVGA (fsize 11) | ~32 КБ | 3.7–9 fps | 122–283 КБ/с |
| VGA (fsize 10) | ~23 КБ | ~9 fps | 201 КБ/с |
| **QVGA (fsize 6, на точке)** | **~8 КБ** | **9–13 fps** | **70–109 КБ/с** |

Узкая точка робота не тянет 283 КБ/с → большие кадры дают «слайд-шоу»; QVGA (70 КБ/с) проходит
→ плавно. `/drive`=14/27/41 мс (keep-alive). **WiFi оказался исправен** (connected, −51 dBm,
стабильно 13/13) — «поломка» была раньше, когда робот на батарее/далеко от роутера (роуминг).
Лагало именно видео из-за больших кадров. fw 1.5.6 на роботе (по USB).

---

## 2026-06-27 — Лёгкий видеопоток для прямого режима (fw 1.5.5, app v14)

Видео (MJPEG) — оставшаяся тяжёлая полоса на AP. `/control?vsize=qvga|vga|svga|hd` (+`vq=8..30`)
меняет разрешение/качество камеры на лету (`set_framesize`/`set_quality` под мьютексом камеры,
не пересекаясь со стримом/capture). Приложение: на прямом подключении («AP») запрашивает
**qvga** (лёгкий кадр), по дому — svga. Поток уже троттлится ~15 fps (60 мс) — теперь и кадр
мельче → меньше полосы → плавнее на узком AP.

Прошито **по WiFi (OTA)** через `tools/xiao_http_ota.py` (1.5.4→1.5.5, без USB). Проверка:
`vsize=qvga` → cam_framesize становится меньше, `svga` → больше (маппинг enum сенсора смещён —
отчёт 6/11 вместо 5/9, но направление верное). app versionCode→14.

---

## 2026-06-27 — Оптимизация режима телефон↔робот (лаг управления)

Замер задержек HTTP к плате (по WiFi): **`/drive` ≈ 18/37/134 мс** (min/avg/max — скачки
из-за нового TCP на каждую команду), keep-alive — ровно **21/31/36 мс**; **`/telemetry`
≈ 124/148/244 мс** (тяжёлый ответ ~6 КБ). Сервер на плате **однопоточный** → пока 150 мс
отдаёт телеметрию, `/drive` стоит в очереди → рывки джойстика.

**Фиксы (app v13, без прошивки):**
- `DriveClient` — **keep-alive**: дочитываем тело и НЕ `disconnect()` → TCP переиспользуется
  (ровные ~31 мс вместо рывков до 134; на битом соединении — disconnect).
- `TelemetryPoller` — **не опрашивает во время езды** (`busy` = джойстик активен): тяжёлая
  `/telemetry` больше не блокирует `/drive`. В простое опрос как раньше (2 с).

`/telemetry` 150 мс — это отправка 6 КБ (поля не режем, нужны дашборду; `j.reserve` уже есть).
Видео (MJPEG) — отдельная тяжёлая полоса; если после этого лагает именно видео — следующим
лёгкий профиль потока (меньше разрешение/fps) для прямого режима.

---

## 2026-06-26 — Прошивка по Wi-Fi (HTTP-OTA) проверена в деле

Оказалось, OTA **уже был включён** в `secrets.h` (`XIAO_OTA_ENABLE 1` + пароль) — я ранее
ошибочно сказал «выключен». Прошивка поднимает `POST /update?pwd=…&size=N` (xiao_http_ota.h)
и ArduinoOTA :3232. **Демонстрация на железе:** робот обновлён **1.5.3 → 1.5.4 полностью
по воздуху** (build 30, свежий uptime), USB не трогали.

`arduino-cli upload --upload-field` в нашей версии CLI **не поддерживается** — поэтому
рабочий путь HTTP-OTA. Доведён `tools/xiao_http_ota.py` до одной команды: авто-сборка
(`--output-dir build_out`), авто-поиск робота в подсети, пароль из `secrets.h`, POST .bin,
проверка `fw_version` после рестарта. Робот должен быть на домашнем Wi-Fi (не в AP-only).
Дальнейшие прошивки — `python tools/xiao_http_ota.py` (без USB).

---

## 2026-06-26 — Самообновление приложения по сети (из GitHub-релиза)

Раньше «Обновить» тянул APK только с ПК-дашборда (надо вручную класть файл в `dist/`).
Репозиторий публичный, CI кладёт APK в релиз `apk-latest` (`xiao-robot-vN-debug.apk`,
скачивается без токена). Поэтому `AppUpdater.checkGithubAndInstall`: читает релиз через
GitHub API, парсит версию из имени ассета (`v(\d+)`), сравнивает с установленным
versionCode, качает и отдаёт системному установщику (FileProvider). UA + следование
редиректам (github.com→objects.githubusercontent.com).

Кнопка **«Обновить»** теперь обновляет из GitHub (по сети, без ПК); долгое нажатие —
запасной путь с ПК-дашборда (LAN). Авто-проверка после подключения — тихо из GitHub.
Нужен интернет (на SoftAP без инета молча не сработает — обновляться при наличии сети).
Версия приложения → v11. Бутстрап: v11 поставить разок вручную, дальше «Обновить» сам.

---

## 2026-06-24 — Прямое подключение тормозит: режим «только точка» (AP-only)

Прямой коннект к SoftAP лагал (особенно видео). Причина: ESP32 — **одно радио**, в AP+STA
оно делит эфир между своей точкой (телефон) и домашним WiFi → ~вдвое меньше полосы +
задержка. (Без видео шустрее, но остаточный лаг есть — это и есть дележ радио.)

**Фикс (fw 1.5.3):** `/control?apmode=1` — «только точка»: `WiFi.disconnect()` отпускает STA
(WiFi/точку НЕ выключаем → телефон не отваливается), флаг `gApOnly` не даёт `wifiMaintainSta`
тащить STA обратно. Всё радио — SoftAP. `apmode=0` возвращает AP+STA (домашний WiFi подхватит
автоповтор). Поле `ap_only` в ответе `/control`. Приложение: кнопка **«AP»** теперь шлёт
`apmode=1` (прямое = быстро), обычное подключение — `apmode=0`.

Если после этого видео всё ещё тяжёлое — следующий шаг: лёгкий профиль потока (меньше
разрешение/fps) для прямого режима. Прошивку зашить по USB; APK — из CI (apk-latest).

---

## 2026-06-24 — Звук моторов: тон через аппаратный LEDC (а не бит-бэнг)

«Поют → крутятся». Разбор: тон (`/beep`,`/melody`) и в порту с Arduino, и в первой
правке делался **программным бит-бэнгом PWM-пина в `loop()`**. На голой Arduino цикл
крошечный — работало. На XIAO цикл медленный (камера/WiFi/ToF) — не успевает дёргать
пин на звуковых частотах → чистого тона нет, только постоянная составляющая → мотор
**крутится**. Первая «двунаправленная» правка (PR #64) не помогла (тот же бит-бэнг) и
вдобавок `pinMode/digitalWrite` по PWM-пину **отрывал LEDC** → пропадал звук привода на
джойстике (регрессия).

**Фикс (fw 1.5.2):** тон генерит **аппаратный LEDC** — `analogWriteFrequency(pwmPin,
нота)` + малая `analogWrite`-скважность (`xiaoAudioDuty`, ≈6..40 % из gain). Чисто, без
зависимости от скорости `loop()`; малая скважность держит мотор ниже порога страгивания
→ поёт на месте. PWM-пин **никогда** не трогаем `pinMode/digitalWrite`; после ноты/стопа
возвращаем рабочую частоту `DRIVE_PWM_FREQ_HZ` (20 кГц) — привод/джойстик целы. Удалён
весь программный wave-tick; `xiaoAudioTick` теперь только расписание нот. Компилируется,
прошито по USB. **Проверено на железе (на батарее): моторы поют, стоя на месте** — звук
работает, регрессия звука привода устранена.

---

## 2026-06-24 — Звук моторов: знакопеременный ток (поют, а не крутятся), fw 1.5.1

Симптом: моторы на звуке (`/beep`, `/melody`) не «пели», а вращались даже на минимальной
громкости. Причина — `xiao_motor_audio.h` гнал **однонаправленный** PWM-тон (`IN1=H, IN2=L`
фикс + скважность gAudioPct% в одну сторону) → постоянная составляющая → чистый крутящий
момент → мотор едет.

Фикс: **знакопеременный (4-квадрантный) драйв** — за период тона 4 фазы: вперёд-драйв →
тормоз → назад-драйв → тормоз (симметрично, длительность драйва = gAudioPct% полупериода).
Среднее по току ≈ 0 → мотор вибрирует на частоте тона, но **НЕ вращается**; громкость = доля
драйва (gAudioPct). Компилируется (build 27). На железе проверяет пользователь — звук нужен
**с батареей** (VM моторов), USB при этом отключён (правило USB+батарея).

Старт работ по связи (план в обсуждении: цель 1 — прямая робот↔телефон, цель 2 —
удалённо через интернет). Сделаны фундамент и цель 1 (прошивка `xiao_net.h`, fw 1.5.0):

**Шаг 1 — токен-авторизация API:** эндпоинты управления `/drive /control /scan360 /beep
/melody` теперь требуют токен `XIAO_API_TOKEN` (из `secrets.h`) — как `?token=…` или
заголовок `X-Auth-Token`. Пусто → авторизация выкл (LAN/dev). **Обязательно задать перед
выходом в интернет.** Сравнение почти-постоянного времени. Чтение-эндпоинты пока открыты.

**Цель 1 — прямая связь без роутера (SoftAP):** режим `WIFI_AP_STA` — робот одновременно
держит свою точку доступа **`XIAO-Robot` @ 192.168.4.1** (телефон коннектится напрямую,
без роутера, в поле) и заходит в домашний Wi-Fi. HTTP-сервер теперь поднимается **всегда**
(на AP и/или STA) — раньше при отсутствии домашней сети уходил в ранний return (только BLE).

**Онбординг Wi-Fi:** страница `http://192.168.4.1/wifi` — ввод SSID/пароля домашней сети →
сохранение в NVS (`Preferences`) → перезагрузка и подключение. Больше не нужно хардкодить
сеть в `secrets.h`. Сохранённые креды в приоритете над дефолтными.

**Прошито и проверено на железе** (fw 1.5.0 build 26, по USB, батарея отключена):
- STA не сломался — робот на домашнем WiFi (`192.168.1.112`, rssi −51), `/telemetry` ок.
- **`wifi_mode = apsta`** в телеметрии — режим AP+STA активен, SoftAP поднят (был `sta`).
- `/wifi` онбординг отдаёт форму (659 б), `/drive?stop=1` → `{"ok":1}` (токен пуст → auth off,
  обратная совместимость). 401-путь проверим при включении токена.

(netsh на ПК не показал SSID `XIAO-Robot` — кэш скана Windows, не отказ точки; финальное
подтверждение AP — телефоном на `192.168.4.1`.)

**Приложение (`android/XiaoRobot`) — подключение к SoftAP из приложения:**
- Кнопка **«AP»** в строке подключения → прямой коннект к `192.168.4.1` (телефон в сети
  `XIAO-Robot`), без ввода IP и без браузера.
- Долгое нажатие на «Подключить» → диалог **токена API** (сохраняется в prefs).
- `DriveClient` шлёт токен заголовком `X-Auth-Token` на эндпоинты управления (пусто = не
  шлёт). Готово к включению авторизации (цель 2).
- **Фикс маршрутизации Android (`WifiBinder`):** при подключении приложение привязывает
  трафик к Wi-Fi (`bindProcessToNetwork`). Иначе при «Wi-Fi без интернета» (SoftAP робота)
  Android уводил запросы в мобильные данные → `failed to connect 192.168.4.1 from /10.x.x.x`.
  Проверено на телефоне: с выключенными моб. данными SoftAP работал (видео/телеметрия/
  управление) — привязка убирает необходимость их выключать.
- APK собирается автоматически в **GitHub Actions** (`build.yml`, job `android`, JDK 17
  temurin) и публикуется в rolling-release **`apk-latest`**. Прогон на merge PR #61 —
  `android ✅`; свежий `xiao-robot-v9-debug.apk` (6 МБ). На телефоне кнопка «Обновить»
  тянет его (или скачать из релиза). (Локально на ПК только Java 8 — поэтому не там.)

Дальше — цель 2 (облачный relay, фаза A).

---

## 2026-06-22 — Разбор карты на слои: контур / объекты-мебель / динамика

Цель: карта должна давать (1) контур помещения, (2) объекты внутри (включая мебель),
(3) различать движущиеся. Анализ накопленной карты (`loop_slam_world.json.gz`, 10294
вокселя) показал: ~80% вокселей — тонкий слой на высоте камеры (карта пока 2.5D-срез),
плюс хвост выбросов глубины до ±45 м; поле `n` (наблюдений) от 1 до 915 — есть плотное
статичное ядро и облако «1–2 раза».

**Этап 0 — фундамент модели (`world_model`, PR #52):** добавлен **карвинг свободного
пространства** `integrate_ray(origin, point)` — луч ослабляет проходимые ячейки
(miss++, logodds−=L_MISS<L_HIT) и усиливает попадание. Уехавший объект «забывается»
(сквозь его место виден дальний фон), стены/мебель выживают. Воксель расширен полем
`miss`: пара hits/miss + last_t = временна́я подпись для детекта движения. Гейт выбросов
MAX_RANGE_M + `prune_isolated()` денойз. selftest: объект виден→забыт, стена жива.

**Этап 1 — контур помещения (`scene_analysis.py`):** чистка (гейт+денойз) → проекция
на пол с агрегацией (logodds/hits/miss/цвет/высота) → `room_contour` радиальным обходом
(самая дальняя занятая ячейка в секторе = стена; мебель-окклюзия учтена; пропуски
интерполируются, профиль сглаживается медианой). На реальной карте: 10294→9127 вокселей
(выброшено 1165 дальних), контур **3.5×3.3 м, периметр 15.8 м, покрытие 98%**. selftest
на синтетике (кольцо стен + мебель внутри): span 2.04×2.04 м, контур не липнет к мебели.

**Оптимизация поиска стен (робот не доезжает до стен — снимаем по дальней глубине):**
радиус стены в секторе = **перцентиль (88%) радиусов**, а не абсолютный максимум —
отбрасывает 1–2 дальних выброса глубины, но сохраняет РАЗРЕЖЁННЫЕ дальние стены (плотный
density-фильтр их убивал: покрытие падало 88%→29%). Плюс **спрямление стен RDP** (`room_walls`)
— зубчатый силуэт → прямые сегменты-стены (комната из прямых стен). На большом обходе:
контур стал чище (3.4→3.0 м, убраны выбросы), стены — спрямлённые сегменты.

**Этап 2 — объекты/мебель (`object_clusters`):** внутренние ячейки (не у стены, по
радиусу к контуру) → связные компоненты → объекты со статистикой (центр, габарит,
площадь следа, высота, цвет, hits/miss, класс мебель/мелкий). selftest: кольцо стен +
блок мебели → 1 объект «мебель», не спутан со стеной. На реальной 2.5D-карте объекты
слипаются в один ближний blob (нет плоскости пола, малая зона) — метод верный, но
нужен объезд с 3D-покрытием.

**Этап 3 — статика vs динамика (`diff_maps`, `label_dynamics`):** (a) одно-карточно по
miss-подписи (`dyn_ratio`=miss/(hits+miss) — заработает на новых проездах с карвингом);
(b) надёжный **дифф двух проходов** (релокализованных): занято в A, пусто в B → объект
УШЁЛ; пусто в A, занято в B → ПРИШЁЛ; занято в обоих → статика (стены/мебель). Кластеры
изменившихся ячеек = движущиеся объекты. selftest: стена стабильна, объект (0.5,0)→
(−0.5,0) даёт «ушёл» и «пришёл». CLI: `scene_analysis.py A.gz B.gz` — дифф проходов.

Каркас всех трёх этапов готов и протестирован. Качество на реальных данных упирается
в съёмку: нужен **объезд периметра** (контур) и **3D-покрытие вокруг мебели** (объекты),
а для динамики — **повторные проезды** одной зоны (дифф) либо живой карвинг луча.

**Карвинг вживлён в живые драйверы** (`loop_slam`, `vo_drive`, `dense_fuse`, `spin_scan`):
точки льются через `integrate_frame_rays(origin, pts)` (origin = позиция камеры из позы),
так что следующий же проезд накопит `miss`-подпись → одно-карточная динамика
(`label_dynamics`) и чистка свободного пространства/стен на ходу. Проверено драйвер-
паттерном: частично выкарвленный объект `dyn_ratio=0.57` → «двигался», стена `miss=0`
статична. В `loop_slam` есть `--nocarve` для отката к старому поведению.

**Проверено на железе (проезд с карвингом):** карта `loop_slam_world.json.gz` — `miss>0`
у **43–51%** вокселей (был 0), стена статична (`miss`-ratio объектов 3–6% < порога) —
ложных «движений» на статичной сцене нет. Пайплайн замкнут end-to-end: проезд с
карвингом → карта с `miss` → контур/объекты/динамика.

**Робастность к потере VO (для больших обходов):** `loop_slam` при потере VO больше не
прерывает проезд, а **счисляет шаг по IMU** (поворот из IMU + средний шаг `est_step` в
направлении движения); такие рёбра в графе поз идут с пониженным весом (info×0.3), чтобы
замыкание петли их выправило. Так большой обход не рвётся на бедных текстурой стенах.

---

## 2026-06-22 — Развязка питания: снимаем главный блокер (просадки под мотором)

Живые проезды упирались не в алгоритмы, а в **железо питания**: броски тока моторов
роняют WiFi/IMU/MCU (петля земли + просадка общего питания), команды `/drive` не
доходят, watchdog глушит моторы — чистую замкнутую петлю (B.3) на дальнем rssi так
не снять. Подготовлен документ-схема развязки `docs/hardware/power-decoupling.md`:
- **звезда по земле** — все GND сходятся в одну точку у минуса батареи, моторная
  земля отдельным толстым проводом (главный, бесплатный эффект);
- **bulk/декаплинг-конденсаторы** по приоритету: 1000 мкФ на `TB6612 VM`,
  470 мкФ + 0.1 мкФ на рейле логики, 10 мкФ + 0.1 мкФ у MPU6050, 0.1 мкФ на VCC
  драйвера и клеммах моторов;
- **толстые провода** на VM и его землю, моторное VM **напрямую от батареи**
  (не через buck логики), батарея 2S ≥1000 мА·ч ≥10C.

Порядок внедрения и тест проверки (`loop_slam.py`: `imu_ok` держится 1, `wifi_rssi`
не проваливается под мотором). ⚠ Напоминание: НИКОГДА USB+батарея одновременно.

**Проверено на железе (электролиты впаяны):** под нагрузкой моторов (вращение на
месте) телеметрия ответила **14/14**, `imu_ok=1` без единого сбоя, `wifi_rssi`
−50…−61 без обвала (в покое 6/6). До развязки под мотором проходило **0–1 чтение**
и WiFi/IMU отваливались — **главный блокер живых проездов закрыт.**

**Живые тесты после развязки (всё без единого выпадения платы — раньше невозможно):**
1. **Поворот на месте** (`heading_drive --turn 90`): 86°→174° (цель 176°), ошибка
   ~2°, замкнутый контур курса не рвётся под током.
2. **Проезд + удержание курса**: курс держался ~3° на ходу, корректный ToF-стоп
   (383 мм).
3. **loop-SLAM туда-обратно** (`loop_slam --fwd 3`): полный пайплайн отработал —
   7 кадров, плотная глубина + VO, **замыкание поймано уверенно** (0↔6: 311
   инлайеров, 0↔5: 340, 0↔4: 329), граф оптимизирован, карта сохранена (972
   вокселя / 853 уверенных). Попутно фикс: `loop_slam.py` принудительно пишет
   stdout в utf-8 (Windows-консоль cp1251 падала на `→` уже ПОСЛЕ оптимизации).

Первый прогон (`--fwd 3`) замкнулся **слабо** (возврат 0.28→0.27 м): причина не
питание, а управление — `loop_slam` ехал плечами простыми импульсами без heading-hold,
за прогон курс уплыл до −22°, обратное плечо не повторило путь.

**Heading-hold встроен в loop_slam** — оба плеча держат стартовый курс по IMU
(P-регулятор, дифпривод `l=fwd+s, r=fwd−s`, `ω∝−2s` ⇒ один знак CAL и «туда», и
«обратно»). Прогон `--fwd 5`: **11 кадров, возврат в старт 0.28→0.02 м** (раньше
0.28), курс гулял ±12° вместо ухода на −22°, замыкание 0↔10: **372 инлайера**, карта
**4537 вокселей / 1491 уверенный** (раньше 972/853). Петля **физически замкнулась** —
оптимизатору распределять уже нечего (дрейф 2 см), поэтому вердикт скрипта научили
различать «уже сошлась» (heading-hold удержал) и «слабо» (замыкание противоречит
одометрии), чтобы метка не врала. Чем точнее heading-hold, тем меньше нужна коррекция
петли — для наглядного сброса дрейфа нужен длинный проезд с накоплением VO-ошибки.

**Контурный проезд (`--sides 4`) — наглядный сброс дрейфа.** Робот едет квадрат:
сторона (heading-hold) → поворот на месте на 90° → следующая сторона; после 4 сторон
он у старта курсом в исходную сторону (сильное замыкание). На повороте VO не гоняем —
сдвига нет, относительная поза = чистый поворот из IMU (`t=0`), иначе ORB не сматчит
90°-скачок. По периметру копится VO-дрейф. Прогон на железе (17 кадров): одометрия
уплыла на **0.41 м**, замыкание 0↔16: **202 инлайера**, оптимизация **ошибка
15.62→0.376** (×40), **возврат в старт 0.41→0.12 м** → вердикт **«ЗАМКНУТА — дрейф
распределён»**, карта **10294 вокселя / 3942 уверенных**. Полный цикл B.3 на железе:
проезд → накопление дрейфа → детект возврата → глобально согласованная карта. Остаток
0.12 м (не 0): держат 3 ребра-замыкания, VO-трансляция грубовата (дешёвая камера) —
но дрейф собран в 3.4×. Следующее: больше рёбер-замыканий / точнее VO (камера получше).

---

## 2026-06-17 — Видео несёт геометрию: плотная глубина + движение (Этапы A и B)

Большой скачок: от разрежённого ToF-облака к плотной 3D-карте, которую робот
строит НА ХОДУ. Цепочка: видео → плотная метрическая глубина → 6-DOF поза → карта.
Установлены torch 2.12 (CPU) + transformers 5.12 + opencv 4.13.

### Этап A — плотная геометрия из видео (PR #35/#36)
`depth_fusion.frame_to_dense_world`: моно-сеть **Depth Anything V2** даёт относит.
глубину, 64 ToF-зоны задают МЕТРИКУ (`fit_scale_shift`), цвет из кадра →
**~8000 точек/кадр вместо 64** (×200). Драйвер `dense_fuse.py`. Грабли transformers
5.x: `use_fast=False` + `HF_HUB_OFFLINE=1` (сеть HF флапает). Карта глубины верная
(передний план ближе, мебель дальше).
**Плотная панорама** (`spin_scan.py --dense`): 732→**16552 вокселей** (×22),
248→**8621 уверенных**, ~5 м комнаты с цветами.

### Этап B — движение (visual odometry, PR #38/#39)
У нас уже есть метрическая глубина → RGB-D одометрия без моно-неоднозначности.
- **B.1 `vo.py`:** umeyama 3D-3D + RANSAC; ключевой приём — **IMU даёт КУРС, VO даёт
  только СДВИГ** (фиксируем R=IMU, оцениваем t — устойчиво). На железе 300+ инлайеров;
  проверка трансляции: VO 7 см ≈ факт 7–15 см.
- **B.2 `vo_drive.py`:** робот **едет вперёд** (ToF-стоп перед препятствием), VO+IMU
  ведут 6-DOF позу, плотная глубина вливается на ходу. Проверено: пройдено ~0.24 м
  (трансляция реально растёт — раньше turntable держал x=z=0), карта вдоль траектории.
  Траектория с шумом ~см/шаг (без замыкания петель — это B.3).

Ограничители: камера OV2640 (низкое разрешение, смаз), CPU-инференс ~2-3с/кадр,
нет cliff-защиты при езде. Следующее: B.3 замыкание петель (дрейф длинных проездов).

---

## 2026-06-16 — Уверенность зон ToF: sigma в /tof + взвешенное накопление карты (fw 1.4.2)

Рычаг позиционирования из `docs/hardware/positioning-optimization.md` (был в «что
осталось»): уверенность зоны больше не выбрасывается на плате, а доходит до сервера
и взвешивает накопление карты.

- **Прошивка 1.4.2:** `GET /tof` отдаёт массив **`sigma`** — per-zone
  `range_sigma_mm` валидной зоны (мм; −1 = нет/неизв.). Прошивка уже фильтровала
  зоны по `target_status` (5/9) и sigma-порогу (15 мм) — но сама величина sigma
  на сервер не уходила. Новый буфер `gTofSigma[]` заполняется рядом с `gTofGrid[]`.
- **Сервер:** `WorldModel.integrate_point(..., w)` масштабирует `L_HIT` весом
  наблюдения; `frame_to_world` выдаёт 5-кортеж `(x,y,z,rgb,w)`, вес из sigma
  (`conf_from_sigma`: чистая зона = 1.0, sigma15 ≈ 0.52, пол 0.3). Уверенно занятые
  воксели копятся от хорошей геометрии быстрее, шум не «дорастает» до confident →
  чище карта и устойчивее релокализация. Опц. серверный строгий отсев
  `CloudConfig.sigma_max_mm` (0 = только взвешивание).
- **Совместимость:** старая прошивка без `sigma` → нейтральный вес 1.0;
  `integrate_frame` принимает и 4-, и 5-кортежи; релокализация (`grid_to_points`)
  не затронута.
- **Проверки:** `calibrate_live.py` `--selftest`/`--simtest`/`--reloctest` зелёные;
  отдельные проверки взвешивания (монотонность веса, чистая зона > шумной по
  log-odds, серверный отсев, обратная совместимость) — OK. Прошивка — компиляция в CI.

Файлы: `xiao_cam_stream/xiao_tof.h`, `xiao_cam_stream/xiao_cam_stream.ino` (версия),
`spatial/world_model.py`, `spatial/world_service.py`, `spatial/tof_cloud.py`,
`docs/hardware/positioning-optimization.md`.

---

## 2026-06-16 — IMU MPU6050: курс на железе + калибровка позиционирования/карты

Подключён и откалиброван инерционный датчик — у системы появился реальный курс
для самоориентации модели пространства.

### IMU MPU6050 (GY-521)

- **Прошивка (PR #16, fw 1.4.0):** драйвер `xiao_imu.h` читает MPU6050 прямым
  Wire (без внешней либы — CI собирает), общая I2C-шина с ToF (0x68 vs 0x29),
  режим без магнитометра (моторы/токи искажают курс). Телеметрия
  `imu_ok/imu_yaw/pitch/roll/gz/temp_c`.
- **Развилка датчика:** параллельно делалась альтернатива на BNO085 (PR #19) —
  закрыта, т.к. физически на руках GY-521. Схему нарисовали под реальный датчик
  (PR #20): `docs/hardware/wiring-xiao-mpu6050-gy521.{pdf,png,svg}`.
- **На железе:** плата перешита main-билдом (MPU6050), `imu_ok=1`, курс растёт
  при вращении (0→78°), в покое держится; ToF/камера на общей шине целы.

### Калибровка позиционирования и карты (PR #21)

- **Знак курса:** замер `spatial/calibrate_live.py` — поворот по часовой даёт
  `imu_gz<0` и убывание `imu_yaw`, а `apply_pose` (`world_az = robot_az + yaw`)
  требует по часовой `+yaw`. Знак был инвертирован (карта «складывалась»
  зеркально при поворотах) → введён `IMU_YAW_SIGN=-1`. Проверка `--simtest`:
  неподвижный объект остаётся на `(0, 1.000)` м через весь поворот 0..90°.
- **Доработки:** `PoseEstimator.recenter()` (принять текущий курс за 0° для
  turntable-скана) + кнопка «Курс=0»/эндпоинт `/world/recenter`; `status()`
  снова отдаёт `have_imu`+`heading_deg`; индикатор позы в дашборде различает
  «курс IMU / одометрия / без позы».
- **Инструмент `spatial/calibrate_live.py`:** гоняет реальный конвейер против
  платы (поза→облако→WorldModel→диск) не трогая дашборд; режимы `--simtest`
  (знак), `--selftest` (round-trip хранения), `live`, `--track`.
- **Проверено вживую:** поза течёт из IMU, ToF-точки валидны, модель копится и
  насыщает уверенность, `save`/`load` round-trip OK.

### Релокализация курса по карте (PR #23) — карта используется для ориентации

Накопленная карта теперь де-дрейфит курс гироскопа (MPU6050 без магнитометра
уплывает). Поза ~1-DOF (turntable) → `relocalize_yaw`: перебор поправки курса δ
в окне ±25°, максимизирующий совпадение ToF-скана с картой
(`WorldModel.score_world_points`). Невязка применяется мягко (`reloc_gain=0.25`).
Fail-safe: только при различимой геометрии (`reloc_min_margin=0.35`: плоская стена
рот-неоднозначна → пропуск; угол/мебель → коррекция) и достаточной карте.
Дашборд: кнопка «Релок по карте» (`/world/relocalize`), поправка в строке позы.
Проверка `--reloctest`: внесённый дрейф ±6..12° восстановлен в пределах 1°
(margin 0.94); `--service` против платы — цикл без падений, guard не трогает позу
на бедной карте. Ограничение: это релок **курса**, не полный SLAM (позиция x/z —
нужен SBC + энкодеры).

### Автоскан на железе + оптимизация (анализ + исследование) — PR #25/#26/#27

Робот сам построил карту (`tools/spin_scan.py`: импульсный turntable, IMU ведёт
курс, релокализация по карте): 247 вокс / 45 уверенных, релок сработал (−0.8°),
IMU не виснет от моторов. Разбор сессии + исследование методов →
**`docs/hardware/positioning-optimization.md`**. Узкие места: разрежённость ToF
4×4, лаг HTTP, грубая релокализация, хрупкость IMU.

- **Сервер (PR #26):** релокализация на **likelihood-field + coarse-to-fine +
  параболический пик** (Olson CSM; Thrun likelihood field) — точность дрейфа
  **1° → 0.03°** (margin 0.98–1.00), берёт ±22°. Мягкий порог скоринга → работает
  на более разрежённой карте.
- **Прошивка 1.4.1 (PR #27, ЗАШИТА И ПРОВЕРЕНА на железе):** честный `imu_ok`
  (`imu_temp` теперь живой ~31°, не мёртвый 36.5) + **авто-реинициализация**
  MPU6050 + **ZUPT bias-tracker** (закрывает инцидент «глитч батарейки подвесил
  IMU»); ToF **sharpener 14%** + 8×8 по `/control?tofprofile=accurate` — проверено
  **res=8, 64 зоны, ~2.5× валидных точек** против 4×4 (авто-профиль 8×8 не выбирал).

Инцидент сессии: смена батарейки подвесила MPU6050 (`imu_ok=1` при нулях,
`imu_temp` замер 36.5) — лечилось ручным полным power-down; 1.4.1 само-лечит.

---

## 2026-06-14 — ToF VL53L7CX: 3D-вид + исследование + весь аудит сенсора (fw 1.3.4→1.3.6)

Большой заход по мультизонному ToF — от визуализации до закрытия всех
пунктов аудита. Каждый пункт — отдельный PR в `main`, проверен на железе.

### Исследование (PR #3, ветка sbc-research-and-tof)

4 дока в `docs/hardware/`: **`vl53l7cx-best-practices.md`** (конфиг,
интерпретация target_status, алгоритмы + **аудит нашего `xiao_tof.h`**),
`orientation-and-mapping-decisions.md` (IMU BNO085, occupancy grid, когда
нужен LiDAR), `lidar-landscape-2026.md`, `orange-pi-lineup-2026.md`.
Вывод: forward-ToF = реактивный объезд + cliff + локальная сетка, не
замена 360° LiDAR для полного SLAM.

### 3D-вид глубины (PR #4)

Лучевой радар в дашборде заменён на **живую 3D-картину матрицы**: сетка
зон (`/board/tof`) рендерится как поверхность глубины (ручная canvas-
проекция, без внешних библиотек). Цвет = дистанция, авто-вращение +
орбита мышью. `/stream` :80 → 302 на :82 (стрим в отдельной задаче).

### Аудит сенсора — закрыт целиком

- **1.3.4 (PR #5):** LPn выведен с перемычки 3.3V на **GPIO7 (D8)** —
  аппаратный сброс сенсора тоглом LPn лечит зависание I2C (SDA stuck)
  при ребуте только MCU. Это была главная причина прежних «связь
  поломалась». Плюс `target_order = CLOSEST` (для объезда ближайшая
  цель важнее яркой).
- **1.3.5 (PR #6):** фильтр зон по **range_sigma_mm** (порог 15 мм,
  тюнится) — отсекает «дрожащие» ложные близкие значения; критично, т.к.
  `tof_mm` = минимум по центру (выброс вниз = ложный стоп).
- **1.3.6 (PR #7):** **обнаружение пола/обрыва** по обучаемому эталону.
  `GET /floorcal` снимает дистанции по зонам на ровном полу; дальше зона,
  потерявшая отражение/ушедшая дальше = обрыв, ближе = бугор. В 3D-виде
  обрывы малиновые, бугры оранжевые; флаги `tof_floor_cal/cliff/bump` в
  телеметрии. Опц. авто-стоп `XIAO_TOF_CLIFF_STOP` (дефолт выкл).

### Железо

LPn физически перепаян с 3.3V на D8 (пользователь). Плата на bench:
fw 1.3.6, `tof_ok=1`, камера+ToF+привод+мик+Wi-Fi стабильны. IP
`192.168.1.104`; дашборд переведён на **чистый Wi-Fi** (`--board-ip`,
без `--port`) — больше не сбрасывает плату по USB-DTR, IP не скачет.

### Открыто на будущее

- Включить `XIAO_TOF_CLIFF_STOP` после проверки калибровки на собранном
  шасси; наклонить сенсор вниз ~15–25° для обзора пола.
- IMU BNO085 → честный курс → стек Ferrolho (3D-скан комнаты).
- Старый PR #1 (russian-greeting, раннее исследование железа) — решить:
  смержить/закрыть как устаревший.

---

## 2026-06-13 — Стабильность видео+привод: краш под нагрузкой устранён (fw 1.3.3, app v9)

Доводка связки «камера + джойстик» на телефоне до рабочего состояния.

### 1. Видео блокировало привод (fw 1.3.1)

`handleStream` гнал MJPEG в бесконечном while внутри единственного потока
WebServer — пока телефон смотрел видео, плата не обрабатывала `/drive`
вовсе (моторы «не работали с приложения, в вебе ок»). Вынес MJPEG в
отдельную FreeRTOS-задачу на **порт :82**; `/stream` на :80 теперь
**302-редирект** на :82 (приложение/браузеры следуют сами). loop()
всегда свободен — `/drive` отвечает во время видео.

### 2. Лаги и зависания приложения (app v9)

`MjpegStream.kt`: `acc = acc + buffer.copyOfRange(...)` пересоздавал весь
буфер на каждое чтение (O(n²), GC-шторм); каждый кадр постился в Main-поток
и забивал очередь UI → касания джойстика не успевали. Переписано: компакт
буфера через `System.arraycopy`, «последний кадр побеждает»
(`AtomicBoolean frameInFlight`), `readTimeout` 0→5000. В прошивке — троттл
стрима ~15 fps, чтобы видео не забивало радио под `/drive`.

### 3. КРАШ под нагрузкой стрима (fw 1.3.2 → исправлено в 1.3.3)

После вынесения стрима в задачу плата стала «зависать почти сразу» при
видео с телефона: пинговалась, но :80/:82 и USB-CDC мертвы (хард-хэнг).
Причины: (а) `esp_camera_fb_get()` не реентерабельна — задача стрима и
`/capture` звали её одновременно; (б) стек задачи 8 КБ переполнялся.
Фикс: **мьютекс камеры** (`gCamMutex`, camFbGetLocked/Return) +
**стек 16 КБ**.

**Проверено на железе (1.3.3 b19):** 30 с стресса — стрим открыт +
`/drive` каждые 120 мс (175/175 OK, 0 сбоев) + `/capture` ×3 OK. Плата
ВЫЖИЛА: uptime 46→79 с без ребута, heap стабилен, утечек нет, 283 кадра.
Задержка `/drive` при открытом видео ~74 мс.

### Состояние

Прошивка 1.3.3, приложение v9 (в release `apk-latest`, в `dist/`).
Весь стек живой и стабилен: камера + ToF VL53L7CX + привод + микрофон +
звук-через-моторы + Wi-Fi. Осталось: финальная проверка с телефона →
перевод PR #2 из драфта в `main`.

---

## 2026-06-13 — ВЕХА: весь стек робота живой одновременно (fw 1.3.1)

Первая полная проверка на железе, где **все подсистемы зелёные сразу**
(новая XIAO ESP32-S3 Sense с камерой, COM7, IP 192.168.1.101):

- **Камера** — `cam_ok=1`, `/capture` отдаёт валидный JPEG ~29 КБ.
- **ToF VL53L7CX ОЖИЛ** — `tof_ok=1, tof_valid=1`, реальные замеры
  (центр ~776–810 мм), счётчик растёт, `/tof` отдаёт сетку 4×4
  (−1 = нет цели). Датчик распаян по `wiring-xiao-motor-tof.md`
  (LPn→3.3V). Первые данные с мультизонного ToF в проекте.
- **Привод** — `drive_hw=1`, принимает команды (cmd_l/cmd_r), watchdog
  и рефлекс-safety чисты; **работает во время открытого видео** (фикс
  :82 из 1.3.1 подтверждён на железе: `/drive` отвечает при активном
  `/stream`).
- **Микрофон** — `mic_ok=1`, −27 dBFS, TCP :81 слушает.
- **Wi-Fi** — RSSI −50…−56 дБм (антенна на месте, сеть переехала на
  `192.168.1.x`).
- BLE в этой сборке не включён (`ble_hw=0`) — опционально, на работу
  робота не влияет.

Итог: камера + ToF + привод + микрофон + Wi-Fi + звук-через-моторы — всё
одновременно на одной плате. Осталось: проверить связку с телефоном (v8)
после фикса :82 и перевести PR #2 из драфта.

---

## 2026-06-12 — Обновления «само работает»: v8 + дашборд на 0.0.0.0 + mDNS «xiao-dash»

**Корень проблемы «обновление с телефона не работает»:** дашборд слушал
**только 127.0.0.1** — телефон в принципе не мог скачать APK, даже зная IP.

- Дашборд: бинд на **0.0.0.0**; печатает LAN-URL для проверки;
  **mDNS-анонс «xiao-dash»** (опционально, `pip install zeroconf`) —
  телефон находит ПК сам.
- Приложение v8: **авто-проверка обновления после подключения** — тихо
  ищет «xiao-dash», сравнивает versionCode, если на ПК новее — качает и
  открывает установщик; ПК выключен — молчит. Диалог «Обновить»: пусто =
  автопоиск ПК; вручную достаточно IP (порт :8897 сам).
- BoardDiscovery: фильтр имени сервиса (xiao-cam | xiao-dash) + порт из
  mDNS вместо хардкода.
- Цикл обновлений теперь: CI собрал → скачать xiao-robot-vN-debug.apk в
  dist/ на ПК → телефон при следующем подключении сам предложит установку.
- versionCode **8**.

---

## 2026-06-12 — Приложение v7: джойстик-оверлей на вкладке «Телеметрия»

Моторы «вообще не реагируют» — для диагностики джойстик теперь доступен
поверх телеметрии (полупрозрачный, правый нижний угол): двигаешь и
одновременно смотришь в группе «Привод», меняются ли drive_cmd_l/r,
drive_watchdog, drive_safety. Один обработчик на оба джойстика
(bindJoystick). versionCode **7**.

---

## 2026-06-12 — Приложение v6: тумблер «Привод» врал + диагноз моторов в статусе

**Симптом:** «моторы глючат / не реагируют», тумблер «Привод (моторы)»
всегда показывал ВЫКЛ.

- **Баг v4:** syncSwitches читал из /telemetry ключ `ctrl_drive`, которого
  там нет (он только в ответе /control) — optInt-дефолт 0 рисовал «выкл»,
  хотя привод в прошивке включён по умолчанию. Теперь состояние привода —
  из `drive_enabled`, и каждый тумблер трогается только если его ключ
  реально пришёл.
- В статус-строку «Робота» добавлен диагноз привода: «привод ВЫКЛ» /
  «рефлекс-стоп (бампер/УЗ)» / «watchdog: команды не доходят» — из
  drive_enabled / drive_safety / drive_watchdog.
- Прошивку не меняли: рефлекс-safety это только бампер/УЗ (оба отключены
  в drive_config), ToF на привод не влияет; во время beep/melody моторы
  не крутят намеренно (motor-audio важнее привода).
- versionCode **6**.

---

## 2026-06-12 — Имя APK с версией

`build.gradle.kts`: outputFileName = `xiao-robot-v<N>-debug.apk`
(N из `dist/app-version.txt`) — в dist/ и в release apk-latest видно,
какая сборка. CI-глоб `*.apk` не менялся.

---

## 2026-06-12 — Приложение v5: обновлялка не зависит от прилипшего адреса ПК

**Симптом:** «обновление: ошибка — failed to connect to /192.168.9.18:8897
from /192.168.1.103» — домашняя сеть переехала на 192.168.1.x, телефон и
плата уже там (mDNS нашёл плату, видео идёт), а адрес ПК в prefs остался
из старой подсети 192.168.9.x.

- Диалог «Обновить»: если сохранённый адрес ПК из другой подсети, чем
  текущая плата (last_ip), — подставляется подсеть платы (например
  «192.168.1.»), достаточно дописать хвост IP ПК; порт :8897 добавляется
  сам; в диалоге подсказка, как поднять дашборд и узнать IP (ipconfig).
- versionCode **5**.

---

## 2026-06-11 — Приложение v4: вкладки и вся телеметрия как в веб-дашборде

Запрос: перенести разделы/логику телеметрии из веба, меню вкладками,
базовый экран — камера + джойстик + базовая телеметрия.

- **Три вкладки** (BottomNavigationView, без фрагментов — переключение
  видимости): «Робот» (как раньше: камера, джойстик, статус-строка;
  в строку добавлен ToF из tof_mm), «Телеметрия», «Управление».
- **Телеметрия** — зеркало дашборда: «Сводка — 10 основных показателей»
  (CORE_TELEM_MAIN, те же русские подписи) + полные группы как groupOf():
  Система и MCU / Память / Flash и OTA / Wi-Fi / Управление / BLE / AP /
  Камера / Микрофон / Датчики / Привод / Прочее. TelemetryPoller теперь
  отдаёт весь JSON (раньше только ch/rssi/ssid).
- **Управление** — devBar и регуляторы из веба: тогглы /control
  (wifi/ble/cam/mic/drive, состояние синхронизируется из телеметрии),
  «Мощность» 40–255 (деф. 180, масштабирует джойстик вместо хардкода 220),
  «Пение (скважность)» 10–100 % (gain в /beep и /melody), кнопки
  Beep A / Мелодия 1 / Привет (id=9) / Стоп звук (id=0) — те же URL,
  что в дашборде. Кнопка «Обновить» переехала сюда. Слайдеры в prefs
  (joy_max_spd / audio_gain — имена как localStorage в вебе).
- versionCode **4**.

---

## 2026-06-11 — Приложение v3: mDNS-автопоиск платы + фикс edge-to-edge

**Симптом на телефоне:** `видео: Failed to connect to /192.168.9.17:80` —
дефолтный IP `.17` прилип в prefs, а плата по DHCP на другом адресе.
Плюс поля/кнопки наезжали на статусбар и системную навигацию.

- **mDNS-автопоиск** (порт 6107f1d из `dev`): `BoardDiscovery` (NSD,
  `_http._tcp` → имя с «xiao» → IPv4). Поле пустое / `xiao-cam.local` /
  `auto` → поиск 6 с, фолбэк на последний удачный IP (`last_ip`);
  литеральный IP — прямое подключение. Прилипший `.17` сбрасывается на авто.
  Manifest: +ACCESS_WIFI_STATE, +CHANGE_WIFI_MULTICAST_STATE.
- **Наложения UI**: targetSdk 35 → Android 15 принудительно рисует
  edge-to-edge; добавлен `setOnApplyWindowInsetsListener` на корневой
  layout — отступы = 12 dp + системные бары.
- versionCode **3** (`dist/app-version.txt`); APK собирает CI
  (release `apk-latest`).

---

## 2026-06-11 — Новая XIAO с камерой + VL53L7CX (мультизонный ToF)

Приехало новое железо: XIAO ESP32-S3 **Sense с камерой** и сенсор
**VL53L7CX** (на модуле пины VIN/GND/SCL/SDA/INT/LPn) вместо погибшего
VL53L0X. Прошивка **1.3.0 (build 16)**.

### Прошивка

- `xiao_tof.h` переписан с Pololu VL53L0X на **«STM32duino VL53L7CX»**:
  матрица 4×4 (до 60 Гц) / 8×8 (до 15 Гц), дальность до ~3.5 м, FoV 60°.
  Профили прежние (`fast/bal/acc/long`): fast = 4×4@60, bal = 4×4@30,
  acc = 8×8@15 (используется scan360), long = 4×4@10 + интеграция 80 мс.
- **Контракт не сломан**: `tof_mm` в телеметрии = минимум по центральной
  полосе зон (то, во что въедет корпус; крайние строки видят пол/потолок),
  ключи `tof_*` и `/scan360` как раньше; добавлен `tof_res` (4|8).
- Новый **`GET /tof`** — вся сетка зон в мм (-1 = нет цели), строками
  сверху вниз: для радар-UI и `brain/`.
- Нюанс L7CX: `init_sensor()` грузит в сенсор ~84 КБ прошивки по I2C —
  старт ToF ~2–3 с; **LPn обязан быть HIGH** (на 3.3 V), иначе сенсор
  молчит. В `drive_config.h` добавлены `XIAO_TOF_LPN_PIN` /
  `XIAO_TOF_I2C_RST_PIN` (по умолчанию -1 = не подключены).
- Порт из `dev` (a12c4e7): **стабильный профиль камеры SVGA q12** вместо
  QXGA q2 — на OV3660 q2 давал FB-OVF и нулевые кадры; новая плата с
  камерой получает рабочий поток сразу.

### Инфраструктура

- CI: `arduino-cli lib install "STM32duino VL53L7CX"` вместо Pololu VL53L0X.
- Схема `docs/hardware/wiring-xiao-motor-tof.md` обновлена: VIN→3V3
  (не 5 V — подтяжки уйдут на 5 V, пины ESP32 не 5V-tolerant), SDA→D9
  (GPIO8), SCL→D10 (GPIO9), **LPn→3V3**, INT не подключать.

---

## 2026-06-11 — Большая сессия: плата ожила, джойстики починены, самообновление приложения

### Плата (запасная XIAO, fw 1.2.4)

- Подключена по USB → **COM6**, MAC `1C:DB:D4:76:24:24`. Прошита текущим
  исходником `main` (1.2.4) — до этого на ней стоял старый билд, который
  не печатал JSON-телеметрию в Serial без Wi-Fi.
- Wi-Fi: сначала плата не держала ассоциацию (reasons 3/14/36 — почерк
  инцидента 2026-06-05, роутер), после перезагрузки роутера получила
  `192.168.9.9`. Проверено на железе: `/drive` (вкл. повороты), `/beep`,
  `/telemetry`, ToF живой.
- Примечание: ПК теперь на `192.168.9.18` (IP сменился с .12) —
  `camera_ip.txt` локальный файл, не в репо.

### Дашборд (`tools/xiao_serial_telemetry.py`)

- **КРИТИЧЕСКИЙ ФИКС прокси `/board/*`**: кэш-бастер вырезался срезом
  `split("&r=")` — а `r` это параметр ПРАВОГО колеса `/drive`. Запрос
  обрезался до `l=...`, прошивка дублировала левую команду на оба колеса:
  вперёд/назад «работали» случайно, повороты — нет. Теперь параметры
  парсятся по именам (`parse_qsl`), кэш-бастер переименован `r` → `_ts`.
- Джойстик: диаметр +20 % (168 px), стрелки направлений, живой индикатор
  `L · R`, ход кнопки 48→62 px.
- **Регуляторы как на UNO-стенде**: «Мощность» 40–255 (деф. 180) —
  масштабирует команды джойстика; «Пение (скважность)» 10–100 % (деф. 10) —
  уходит `gain` в `/beep`/`/melody`. Хранятся в localStorage.
- **HTTP-сервер стал многопоточным** (ThreadingMixIn + daemon + timeout 30 с
  на соединение): один зависший хендлер больше не морозит всю панель.
- Новые эндпоинты `/app/version.json` и `/app/apk` — раздача APK телефону.

### Android-приложение (v2)

- **ФИКС «одно нажатие и зависает»**: `onRelease` джойстика вызывал
  `drive.stopSending()` — это cancel() периодического driveJob, который
  запускается один раз в `connectAll()`. После первого касания цикл
  отправки умирал навсегда. Фикс: на отпускании только обнуляем команды,
  живой цикл сам шлёт `stop=1` (и кормит watchdog). Та же правка в кнопке
  «Стоп».
- Убран дублированный импорт CoroutineScope в `MjpegStream.kt`
  (Kotlin 2.0 в CI считает ошибкой).
- **Самообновление по LAN**: кнопка «Обновить» → `AppUpdater` качает
  `/app/version.json` + `/app/apk` с ПК и запускает установщик
  (FileProvider, REQUEST_INSTALL_PACKAGES). Версия = `dist/app-version.txt`
  (единый источник для gradle и дашборда), сейчас versionCode 2.
- **Фиксированный ключ подписи** `android/XiaoRobot/debug.keystore`
  закоммичен: раньше CI подписывал каждый билд случайным ключом и Android
  не ставил обновления поверх. Первая установка v2 — с удалением старого
  приложения (подпись сменилась), дальше — поверх.

### Прошивка

- `/beep` и `/melody` принимают `gain=10..100` → `xiaoAudioSetGain()`.
  Дефолт 10 % уже был в `xiao_motor_audio.h` (как на UNO).
  Скомпилировано (36 % флеша), НА ПЛАТУ ПОКА НЕ ЗАЛИТО — ждёт подключения.

### CI

- Джоба android не работала никогда: (1) `./gradlew` нет в репо (проект
  собирался только на Windows) → запуск wrapper напрямую
  `java -cp gradle/wrapper/gradle-wrapper.jar`; (2) у аккаунта исчерпана
  квота хранилища артефактов → APK публикуется в **rolling-release
  `apk-latest`** (релизы квоту не тратят), артефакт остался запасным
  каналом с continue-on-error.
- Ран #31 зелёный: brain ✓ firmware ✓ android ✓.

### Цикл доставки приложения (теперь)

```
правка кода → push → CI собирает APK → release apk-latest
  → APK скачивается в dist/ на ПК (закоммичен и в репо)
  → дашборд раздаёт /app/apk → телефон: кнопка «Обновить»
```

Файлы: tools/xiao_serial_telemetry.py, android/XiaoRobot/* (updater,
keystore, фиксы), xiao_cam_stream/xiao_cam_stream.ino (gain),
.github/workflows/build.yml, dist/app-version.txt, dist/xiao-robot-debug.apk.

---

## 2026-06-10 — Сведение двух линий разработки (Cursor `main` ← `claude/dev`)

Проект какое-то время развивался ДВУМЯ параллельными линиями от общего
предка `b283eab`:

- **`main` (работа из Cursor)** — плата ЖИВА (на запасной XIAO), прошивка
  доросла до **1.2.4** (build 15): ToF VL53L0X + радар + скан-360°, голос
  через моторы, HTTP-OTA, веб-джойстик для Arduino UNO, инструменты
  восстановления, отдельный сетевой инцидент 2026-06-05 (Wi-Fi ПК/роутер,
  НЕ смерть платы).
- **`claude/dev`** — фазы 1-5, `brain/` (ИИ-мозг), CI, отчёт о петле земли
  + защиты питания, одометрия/рефлекс в `xiao_drive.h`.

**Решение:** `main` — каноническая линия. В неё перенесено ценное из
`claude/dev` (ветка `claude/port-dev-into-main`):
- `brain/` + `docs/brain-api.md`, CI (`.github/workflows/build.yml`,
  firmware-job дополнен установкой VL53L0X), `LICENSE`, `docs/onboarding.md`,
  `.editorconfig`, `docs/security-history-cleanup.md`, этот `docs/dev-log.md`;
- `xiao_drive.h` — слиты одометрия/антидребезг/рефлекс безопасности
  (`claude/dev`) с аудио-хуками motor-audio (`main`);
- доки безопасности питания (этот журнал + раздел README +
  `docs/hardware/build_wiring.py` как референс цепи защиты).

**НЕ перенесено** (и почему): OLED-драйвер по SPI — его пин D10 конфликтует
с ToF SCL (на одном XIAO вместе не живут, ToF приоритетнее); простой
`arduino_motor_test` из `claude/dev` — на `main` расширенный стенд лучше.

**Статус платы:** исходная XIAO мертва (петля земли, см. запись 2026-05-26 —
остаётся как урок по безопасности питания); разработка идёт на ЗАПАСНОЙ
плате. Курс на одном XIAO; гибрид с Raspberry Pi («Путь B», исследование на
ветке `claude/russian-greeting-aN4wi`) — отложен.

Проверка: `brain` 9/9 тестов OK; прошивка `main` компилируется
(`esp32:esp32:XIAO_ESP32S3:PSRAM=opi`, 35% флеша) и до, и после мёрджа
`xiao_drive.h`.

---

## 2026-05-26 — ИНЦИДЕНТ: смерть платы XIAO ESP32-S3 Sense

### Симптомы (что наблюдалось)

После распайки робота по схеме `docs/hardware/build_wiring.py` и первой
подачи питания плата XIAO ESP32-S3 Sense **перестала отвечать**:

- Красный диод (CHG — индикатор зарядки) горит — питание на входе есть.
- **Жёлтый диод (USB activity) не загорается** ни разу — ни при подаче
  питания, ни при нажатии R (RESET), ни при удержании B (BOOT).
- В Windows USB-устройство в статусе `CM_PROB_PHANTOM`
  (`pnputil`: «The device is not connected»). Drivers помнят прошлое COM5,
  но физического подключения нет.
- `arduino-cli upload --port COM5` → `Could not open COM5, the port is
  busy or doesn't exist`.
- Bootloader-режим (B+R) тоже не даёт COM-порт — то есть hardware-bootloader
  не отвечает.
- **WiFi-стек не поднимается** ни от USB-питания, ни от батареи: на сети
  не появляется ни одного устройства с MAC-префиксом Espressif (проверено
  ping-сканом /24 + ARP, до подключения и после, +18 сек ожидания на
  батарее).
- mDNS `xiao-cam.local` молчит.
- Все эндпоинты (`/telemetry`, `/stream`, `/drive`, OTA 3232) — недоступны.

### Контекст (что делали)

- Свежераспаянная сборка: батарея 7.4–8.4 В (2S Li-Ion) → DC-DC Buck → 5 В →
  XIAO 5V pin; TB6612FNG; OLED SSD1306 SPI; 2 мотора.
- В какой-то момент **USB-кабель к ПК и батарея 7.4 В были подключены
  одновременно** через общий минус (это подтверждено пользователем).
- Pin-конфликт в прошивке (D6/D7/D8 у энкодеров vs OLED) был исправлен,
  но новая прошивка **не успела залиться** — на плате осталась прежняя.

### Аудит моей схемы (build_wiring.py)

Топология схемы **корректна**:
- `BAT+` → `TB6612 VM` (питание моторов; TB6612 терпит до 15 В, наша 7.4–8.4 В безопасна).
- `BAT+` → `Buck IN+` (вход понижайки).
- `Buck OUT+` (5 В) → `XIAO 5V` pin (питание логики через VBUS-цепь XIAO).
- `XIAO 3V3` (выход внутреннего LDO) → `TB6612 VCC`, `TB6612 STBY`,
  `OLED VCC`, `OLED RES`.
- Общая земля: `BAT−` + `Buck IN−`/`OUT−` + `TB6612 GND` (3 пина) +
  `XIAO GND` + `OLED GND` — всё в одну шину.
- Моторы: `AO1/AO2`→`Motor L`, `BO1/BO2`→`Motor R`.
- 3.3-вольтовые сигналы: PWMA/AIN1/AIN2/PWMB/BIN1/BIN2 + SCK/MOSI/DC/CS.

**Однако в схеме отсутствовали ключевые защиты:**
1. **Нет предупреждения** о смертельной опасности одновременной подачи
   USB-питания (от ПК) и батарейного питания. Это самая частая причина
   смерти ESP32-плат у любителей, и в схеме это никак не отмечено.
2. **Нет защитного диода** (Schottky или ideal-diode MOSFET) между
   `Buck OUT+` и `XIAO 5V`, который защищал бы XIAO от обратного тока
   при USB-питании, или наоборот — Buck от USB-VBUS.
3. **Нет TVS-диодов** на USB D+/D− линиях для защиты USB-PHY ESP32-S3
   от ESD/перенапряжения через петлю земли.
4. **Нет указания** «измерить выход Buck мультиметром ДО подключения
   к XIAO 5V». Buck-преобразователи на AliExpress часто приходят с
   потенциометром, выкрученным на 12+ В — без проверки можно сжечь
   плату с первой подачи.
5. **Нет предохранителя** (PPTC 1–2 A) на батарейном проводе для защиты
   от КЗ при пайке.

Это конструктивные пробелы моей схемы — записываю как ответственность
автора (меня), не пользователя.

### Гипотезы причины смерти (по убыванию правдоподобия)

#### Гипотеза 1: Петля земли (USB ⇄ батарея одновременно) — вероятность ≈70%

**Механизм.** При одновременном подключении USB к ПК и батареи 7.4 В,
земли USB-хоста и батареи объединяются в точке `XIAO.GND` через провод
общего минуса. Если потенциалы GND отличаются (плохой блок питания ПК
с утечкой на корпус, или ёмкостная разность из-за зарядки/Li-Ion-схемы) —
течёт уравнивающий ток через USB GND. USB D+/D− линии у ESP32-S3
защищены слабыми ESD-диодами; уравнивающий ток >100 мА пробивает их.
Если разряд был сильным — пробивает не только USB-PHY, но и общую
3.3 В шину, через которую запитан весь SoC.

**Соответствие симптомам:**
- ✅ USB-CDC мёртв (USB-PHY повреждён первым).
- ✅ Жёлтый LED (USB activity) не загорается.
- ✅ Bootloader не отвечает (он использует тот же USB-PHY).
- ✅ WiFi не поднимается (SoC мёртв, не только USB-часть).
- ✅ Красный диод горит — он привязан к схеме зарядки на плате XIAO
  (отдельная микросхема, не SoC), и работает пока есть VBUS/батарея.
- ✅ Нет видимых повреждений — типично для электрической смерти через
  ESD-каналы (внутреннее, без дыма).

**Подтверждено в коде:** комментарий в `xiao_cam_stream.ino:13` —
«Красный у зарядки не программируется — смотри только жёлтый у USB».
То есть красный — это charge-IC LED, может гореть на мёртвом чипе.

#### Гипотеза 2: Нахлёст 5 В / 7.4 В — попадание 7.4 В на XIAO 5V pin — вероятность ≈15%

**Механизм.** При пайке провод `BAT+` (7.4–8.4 В) случайно ушёл на
`XIAO 5V` pin (вместо `Buck OUT+`). Внутренний 3.3 В LDO XIAO
(обычно XC6220A331MR) имеет абсолютный максимум на входе ≈6 В,
типовой рабочий — 5.5 В. При подаче 7.4 В:
- LDO моментально перегревается и сгорает.
- 3.3 В шина либо проседает (чип не работает), либо получает 5+ В
  через сгоревший LDO (чип сгорает).

**Соответствие симптомам:**
- ✅ Красный диод горит (charge-IC на плате толерантна до ~15 В).
- ✅ Жёлтый и WiFi не работают (SoC мёртв).
- ⚠️ Однако: на схеме `Buck OUT+` и `BAT+` идут к разным концам платы,
  спутать их физически сложно если паял по схеме внимательно.

**Как проверить теперь:** уже мёртвая плата не даст однозначного ответа.
На будущее — измерить мультиметром: между `XIAO 5V` pad и `GND` с
включённым Buck (без USB), должно быть 5.0 В ± 0.1 В.

#### Гипотеза 3: Buck выдал перенапряжение — вероятность ≈5–10%

**Механизм.** Типичный DC-DC Buck-модуль (MP1584, LM2596) приходит с
потенциометром в случайном положении. Без калибровки может выдавать
12 В или больше. На `XIAO 5V` (max 5.5 В) это смерть, сценарий идентичен
Гипотезе 2.

**Соответствие симптомам:** то же, что и Г.2.

**Профилактика:** **ВСЕГДА** измерять Buck выход мультиметром перед
подключением.

#### Гипотеза 4: Замыкание припоя — вероятность ≈5%

**Механизм.** Капля припоя замкнула: VBUS↔GPIO, или 3V3↔5V, или 5V↔GND.
При подаче питания узел перегрелся и сгорел.

**Как проверить:** визуальный осмотр пайки под лупой — особенно
плотные пины XIAO (шаг 2.54 мм, но дорожки тонкие).

#### Гипотеза 5: Обратная полярность батареи — вероятность ≈3%

**Механизм.** Перепутаны `BAT+` и `BAT−`. Обычно сопровождается
характерным щелчком, запахом, видимым подгоранием корпуса чипа.
Пользователь такого не описывал.

#### Гипотеза 6: ESD при пайке — вероятность ≈2%

**Механизм.** Статический разряд при пайке без браслета. ESD-защита
ESP32-S3 не безгранична.

#### Гипотеза 7: Перенапряжение на GPIO из выходов моторов — вероятность ≈1%

**Механизм.** Если AO1/AO2/BO1/BO2 (выходы H-моста) случайно
закоротились на 3.3-вольтовые GPIO XIAO. Маловероятно при правильной
разводке — выходы моторов идут НА моторы, не на XIAO.

### Окончательный вывод

Наиболее вероятна **Гипотеза 1 (петля земли)** — она объясняет полную
картину симптомов и согласуется с подтверждённым фактом одновременного
подключения USB+батареи.

**Гипотезы 2–3** (перенапряжение на 5 В pin) — вторая по правдоподобию,
но в нашем случае невозможно проверить постфактум на мёртвой плате.
Включаю в правила на будущее.

### Уроки и правила на будущее (PERMANENT)

1. **🛑 НИКОГДА не подключать USB и батарею одновременно.** Перед
   подключением USB к ПК — отсоединить батарею (или хотя бы её плюс).
   Перед подключением батареи — отсоединить USB. Если нужны оба
   источника одновременно (например, для прошивки во время полевых
   испытаний) — ставить **USB-isolator** (ADuM3160 или подобный) либо
   ideal-diode MOSFET-переключатель источников.

2. **📏 ВСЕГДА измерять выход Buck мультиметром ДО первого подключения
   к плате.** Цель: 5.0 В ± 0.1 В без нагрузки. Если выше — крутить
   потенциометр Buck. Если ниже 4.8 В или нестабильно — Buck дефектный
   или перегружен.

3. **🎨 Цветовая маркировка проводов питания, разная для разных
   напряжений:**
   - `BAT+` (7.4 В) — **толстый красный** или **жёлтый**.
   - `Buck OUT+` (5 В) — **тонкий красный** или **оранжевый**.
   - `3V3` — оранжевый (потоньше).
   - `GND` — **чёрный**, всегда и только.
   - Никогда не использовать один цвет для проводов разного напряжения.

4. **🔌 Защитный диод на 5 В входе платы.** Schottky (например, SS14)
   последовательно между `Buck OUT+` и `XIAO 5V`, анод к Buck:
   - Защищает XIAO от обратного тока с USB VBUS.
   - Защищает Buck от обратного тока с USB VBUS.
   - Падение ≈0.3 В — компенсировать настройкой Buck на 5.3 В.

5. **🔒 Предохранитель на батарее.** PPTC 1–2 А или плавкая на
   батарейном `+` проводе. Защищает от КЗ при пайке/коротком провода.

6. **🛡️ TVS-диоды на USB D+/D−** для защиты USB-PHY от ESD/
   перенапряжения через петлю земли. Готовые модули: USBLC6-2SC6,
   PRTR5V0U2X.

7. **👀 Перед первым включением — визуальный осмотр пайки под лупой.**
   Особенно у плотно расположенных пинов и силовых дорожек.

### Решение для проекта

Плата физически мертва, восстановлению не подлежит. Дальнейшие шаги:
- **A.** Заказать новую `Seeed XIAO ESP32-S3 Sense` (≈$10–15
  AliExpress, ≈1 неделя). При получении — собрать с учётом правил
  выше.
- **B.** Временно использовать `AI-Thinker ESP32-CAM` (есть у
  пользователя) с stock-прошивкой `CameraWebServer` для проверки
  «глаза» проекта. Полноценная адаптация нашей прошивки под ESP32-CAM
  не имеет смысла — другой чип, нет микрофона, недостаточно GPIO.

### Изменения в репозитории

- `docs/dev-log.md` — эта запись (полный отчёт о расследовании).
- `docs/hardware/build_wiring.py` — добавлен крупный комментарий-
  предупреждение в шапку файла с правилами 1–3.
- `README.md` — новый раздел «⚠️ Безопасность питания» сразу после
  «Состав».
- Memory: новое правило `feedback_power_safety.md` (USB+батарея
  одновременно = смерть) + регистрация в `MEMORY.md`.

---

## 2026-05-25 — OLED-драйвер в прошивке + фикс конфликта пинов D6/D7/D8

Пользователь собрал железо по схеме, но **OLED не работает и моторы не отвечают**.
Диагностика показала две причины:

**1. OLED-драйвера не было в прошивке вообще.** `grep -i 'oled\|ssd1306\|u8g2'` по
`xiao_cam_stream/` — 0 совпадений. Схема была нарисована корректно, но код
SSD1306 никто не писал. Добавил:
- `#include <U8g2lib.h>`
- Глобал `U8G2_SSD1306_128X64_NONAME_F_4W_SW_SPI gOled(R0, SCK=D8, MOSI=D10, CS=D6, DC=D7, reset=NONE)` —
  Software SPI, чтобы не разруливать ESP32-S3 HW-SPI remap.
- `oledInit()` после `xiaoDriveInit()` в `setup()`.
- `oledTick()` в `loop()` каждые 500 мс: IP/RSSI/channel, cmd_l/cmd_r/WD-флаг,
  счётчики кадров камеры, мкр-уровень в dBFS, temperatureRead°C.

**2. Конфликт пинов D6/D7/D8.** В `drive_config.h` пины энкодеров стояли как
`DRIVE_ENC_L_A=43, _B=44, R_A=7, R_B=8` — а это ровно те же D6/D7/D8, которые
схема отдаёт OLED под CS/DC/SCK. `xiao_drive.cpp` ставил `attachInterrupt` на
D7/D8, и любая SPI-транзакция U8g2 на тех же пинах сразу триггерила ISR
энкодеров → возможные виснущие прерывания, шум, фантомные движения, и
конкретно — OLED никогда не получал чистого clock. ISR-гарды в `xiao_drive.h`
(`#if DRIVE_ENC_L_A > 0`) корректные, поэтому достаточно занулить все четыре:
```
#define DRIVE_ENC_L_A 0
#define DRIVE_ENC_L_B 0
#define DRIVE_ENC_R_A 0
#define DRIVE_ENC_R_B 0
```
Комментарий-предупреждение в шапке зафиксирован: «энкодеры отключены — пины
отданы под OLED». Это решение явное (одна правка в одном месте), не неявное
«забыл подключить».

**Компиляция:** `arduino-cli compile --fqbn esp32:esp32:XIAO_ESP32S3:PSRAM=opi`
прошла, EXIT=0. Скетч 35% флеша (1.19 МБ из 3.34 МБ), глобалы 19% RAM.
Библиотека `U8g2@2.35.30` подтянулась автоматически в `tools/arduino-cli/.../libraries/`.

**Прошивка ОТЛОЖЕНА — USB-проблема:** плата на COM5 в статусе `CM_PROB_PHANTOM`
(`pnputil`: «The device is not connected»). Физическое USB-соединение не
живо — либо кабель power-only, либо плохой контакт Type-C, либо плата
повисла без USB CDC после прошлой прошивки. Решение — действия пользователя:
переподключить кабель / попробовать другой / зажать BOOT при подключении.

Как только USB вернётся — `arduino-cli upload --port COM5` и проверка
на железе (OLED должен показать IP сразу после подключения к WiFi; моторы
должны реагировать на `/drive?l=120&r=120` из Android-приложения).

Файлы: `xiao_cam_stream/xiao_cam_stream.ino`, `xiao_cam_stream/drive_config.h`.

---

## 2026-05-25 — Схема пайки: переход на schemdraw (Python), стиль KiCad

После четырёх итераций с Graphviz (rankdir/splines=ortho/xlabel/rails) —
auto-routing всё равно клал провода через корпуса и метки на пины. Это
**фундаментальное ограничение Graphviz** для wiring-диаграмм, не моя ошибка.

**Решение: `schemdraw`** (`pip install schemdraw matplotlib`) — Python-
библиотека специально для электронных схем (инженерные публикации,
KiCad-style). Ручная XY-разметка, нет auto-routing — полный контроль:
- Каждый компонент `elm.Ic(pins=[elm.IcPin(...)])` с явным side/slot
- Провода `elm.Wire('-|').at(a).to(b)` — L-образные, я выбираю стороны
- Net-теги `elm.Tag().label("3V3", color=...)` — пилюли у пина

**Архитектура схемы (KiCad-style):**
- Прямые провода — **ТОЛЬКО для коротких 2-pin сигналов** (BAT+→VM,
  BUCK 5В→XIAO 5V, AO/BO→моторы)
- Для всех остальных сигналов — **NET-LABELS у каждого пина с обеих
  сторон** (PWMA/AIN1/AIN2/BIN1/BIN2/PWMB/SCK/MOSI/DC/CS/3V3/GND).
  Имена совпадают = сигналы соединены, рисованных проводов нет.
- Цвет провода/тега = функция; легенда внизу.

**Результат:** настоящий принципиальный чертёж — никаких пересечений,
никаких наложений на пины, всё в физическом порядке силкскрина.

Исходник: `docs/hardware/build_wiring.py` (Python ~200 строк, читаемо
и редактируемо). Заменил Graphviz `wiring.gv` на этот скрипт.
Output: PDF/PNG/SVG с одной командой `python build_wiring.py`.

**Memory:** правило `feedback_wiring_diagrams.md` финализировано —
для любых wiring/pinout-диаграмм используем schemdraw, не Graphviz.

---

## 2026-05-25 — Схема пайки: убраны xlabels, цвет = функция (финал)

Подписи `xlabel="D0→AIN1"` и т.п. на сигнальных проводах с
`splines=ortho` Graphviz кладёт поверх пинов соседних компонентов
(в данном случае на пинах XIAO). Это и было то самое «провода
накладываются на пины», что заметил пользователь.

**Решение по конвенции принципиальных схем:** функцию провода несёт
**цвет**, не текст. Пины на обоих концах уже подписаны (D5, PWMA);
текстовая подпись на самом проводе избыточна и в нашем случае только
мешает. Убрал `xlabel` со всех сигнальных рёбер, оставил только `color`.
Добавил **развёрнутую цветовую легенду** в углу схемы:

- Красный = VM / 5 В питание
- Зелёный = PWM
- Синий = IN1/IN2 направление
- Серый = выходы моторов AO/BO
- Фиолетовый = SPI данные (SCK/MOSI)
- Розовый = SPI управление (CS/DC)

**Memory rule расширен:** «На принципиальных схемах функцию сигнала
несёт ЦВЕТ; xlabels на проводах с ortho-routing накладываются на пины —
не использовать. Цветовая легенда обязательна».

Финальный вид — чистый инженерный чертёж: net-теги питания, цветные
безтекстовые сигнальные провода, легенда. Применяется автоматически.

---

## 2026-05-25 — Схема пайки: net-labels (как в KiCad/Altium), без шин

Версия с rail-узлами (3V3/GND как горизонтальные полосы) дала пересечения
и наложения проводов в центре схемы — из-за конвергенции всех отводов
в один узел-шину. Это не соответствует инженерным стандартам.

**Финал — net-labels (стандарт KiCad/Altium/EAGLE):**
- Никаких bus-узлов и длинных шин не рисуем.
- У КАЖДОГО пина-потребителя 3V3 или GND стоит **отдельный маленький
  тег-пилюля** с именем сети (`3V3` оранжевый, `GND` чёрный) сразу
  рядом с пином, через короткий отвод.
- Пины с одинаковой меткой считаются электрически соединёнными
  (читатель домыслит — это стандартная конвенция, явно описана в
  легенде вверху схемы).
- `rank=same` для каждой группы (XIAO+теги, TB6612+теги, OLED+теги
  и т.д.) — теги стоят рядом со своим компонентом, не уплывают.
- Сигнальные провода 2-pin (D5→PWMA, AO→Motor) — остаются прямыми
  подписанными рёбрами.

**Memory:** правило `feedback_wiring_diagrams.md` дополнено: «при 3+
потребителях общей сети — НЕ рисовать bus-узел с отводами; использовать
net-labels у каждого пина (отдельный тег с именем сети, без edges
между ними)».

Результат — компактная схема без пересечений и наложений; визуально
читается как настоящий принципиальный чертёж.

---

## 2026-05-25 — Схема пайки: переход на инженерные стандарты (rails + ortho)

После двух итераций провода всё ещё пересекали корпуса. Применил полные
конвенции принципиальных схем (KiCad / Fritzing / IEEE 315):

1. **Power/GND rails** вместо fan-out: добавлены два узла-«шины» —
   `3V3 — питание логики` (оранжевая полоса) и `GND — общая земля`
   (чёрная полоса). XIAO 3V3 «питает» 3V3-шину, остальные потребители
   (TB6612 VCC/STBY, OLED VCC/RES) короткими отводами от шины. Все 6
   GND-пинов сводятся в GND-шину одиночными отводами. Это убрало 8
   длинных fan-out проводов, которые до этого пересекали полстраницы.
2. **Orthogonal routing** (`splines=ortho`) — все провода под 90°.
3. **`xlabel=` вместо `label=`** для рёбер: ortho в Graphviz не
   поддерживает обычные label на edges (warning при рендере); xlabel
   («external label») с этим режимом работает.
4. **Compass на ВСЕХ концах рёбер** указывает на внешнюю грань ячейки
   (правило сохранено в памяти: `feedback_wiring_diagrams.md`).
5. **Сигнальные провода 2-pin** (D5→PWMA, AO1→Motor L, ...) — остаются
   прямыми подписанными рёбрами; в шины не загоняем.

Результат: провода больше **не проходят сквозь корпуса**, шины
питания/земли видны как горизонтальные рельсы, метки на местах.
Источник `wiring.gv` ~190 строк, PDF ~67 КБ, PNG ~167 КБ.

**Memory:** правило wire-diagram-rules расширено секцией о rails,
ortho, 2-pin direct wires. Применяется автоматически в будущих
задачах wiring/pinout.

---

## 2026-05-25 — Схема пайки: физическая раскладка пинов + DC-DC Buck 5В

По фидбэку:

1. **Пины компонентов теперь в том же порядке, что на плате (силкскрин):**
   - **TB6612** — горизонтальный 8 × 2 ряда (раскладка SparkFun-корпуса):
     верх — `VM | VCC | GND | AO1 | AO2 | BO2 | BO1 | GND` (мотор-сторона),
     низ — `PWMA | AIN2 | AIN1 | STBY | BIN1 | BIN2 | PWMB | GND` (логика).
   - **OLED** — 1 ряд × 7 пинов: `GND | VCC | D0/SCK | D1/MOSI | RES | DC | CS`.
   - XIAO уже совпадал с физикой (2 колонки × 7, USB-C сверху).

2. **Добавлен DC-DC Buck 5В** между батареей и XIAO:
   - Батарея 7.4 В → TB6612 **VM** (питание моторов, прямо).
   - Батарея 7.4 В → Buck **IN+/IN−** → XIAO **5V/GND**
     (логика питается стабилизированными 5 В, не 7-8 В).
   - На схеме помечено `MP1584 / LM2596` — оба распространены и работают.

**Раскладка** — `rankdir=TB` (сверху вниз): верх — батарея/Buck/моторы,
центр — TB6612 горизонтально, ниже — XIAO, в самом низу — OLED.
Моторные провода идут с моторов сверху прямо вниз в AO/BO TB6612 — без
обходов корпуса.

Файлы (`docs/hardware/`): `wiring.gv` (источник), `wiring.png` (превью
для GitHub), `wiring-xiao-tb6612.pdf` (печать; ~372×354 мм, «fit to A4»).

---

## 2026-05-25 — Схема пайки: переход на Graphviz `dot` (HTML-таблицы + порты)

Ручная векторная отрисовка через reportlab.canvas давала наложения проводов
и кривое размещение. Поискал инструменты в сети, попробовал два:

- **WireViz** (`pip install wireviz`) — специализирован под harness-кабели,
  отлично рендерит «бандлы», но в нашем случае каждый кабель выводился
  отдельным боксом с таблицей (от→до), а это **дублирование** информации
  и визуальный шум.
- **Чистый Graphviz `dot`** — выиграл: каждый компонент — HTML-таблица
  с пинами-портами, каждый провод — обычное ребро `node:port → node:port`
  с цветом и подписью. Auto-routing без cable-боксов.

В итоге:
- Исходник `docs/hardware/wiring.gv` (~140 строк, читаемо).
- Рендер `dot -Tpdf wiring.gv -o wiring-xiao-tb6612.pdf` (~62 КБ, 1 страница,
  ~314×338 мм — печатается «fit to A4» нормально, остаётся читаемым).
- PNG-превью `wiring.png` рядом — отрисовывается в GitHub blob.
- Тулчейн: portable Graphviz 15.0.0 в `tools/graphviz/` (gitignored,
  скачка по аналогии с `arduino-cli`).

**Ключевая правка раскладки** (по фидбэку — «моторные провода путались»):
в таблице TB6612 левая колонка — VM/VCC/GND/STBY/PWM/IN (мордой к XIAO и
батарее), правая — AO1/AO2/BO1/BO2 (мордой к моторам). Компас-стороны
`:e/:w` на проводах форсируют выход с нужного бока — dot больше не водит
провода в обход корпуса.

---

## 2026-05-25 — Схема пайки: визуальный вектор вместо ASCII

PDF полностью переделан. Было: таблицы + ASCII-блок-схема. Стало:

- **Стр. 1 (A4 landscape):** настоящая векторная схема — все 6 компонентов
  как боксы с подписанными пинами (TB6612 слева, XIAO в центре, OLED справа,
  батарея + 2 мотора по краям). Каждый провод — отдельная цветная линия
  с подписью на ней (`D5 → PWMA`, `D8 → SCK` и т.д.). Цветовая легенда:
  красный = VM, оранжевый = 3.3 В, чёрный = GND, зелёный = PWM,
  синий = направление, фиолетовый = SPI, сиреневый = CS/DC, тёмно-серый = моторы.
  3V3 и GND нарисованы как горизонтальные «шины» с отводами к компонентам —
  одно решение, никаких звёзд по проводам.
- **Стр. 2 (A4 landscape):** табличный «список проводов» — каждая строка =
  отдельный провод (цвет-чип, откуда, куда, сигнал, GPIO, примечание).
  Всего 22 провода. Плюс 8-пунктный чек-лист перед подачей питания.

Источник пинов — `xiao_cam_stream/drive_config.h` (моторы) и принятое
размещение OLED на D6–D10 (3V3 для VCC и RES). Файл — тот же
`docs/hardware/wiring-xiao-tb6612.pdf` (98 КБ, 2 стр.); ссылка в README
не меняется.

---

## 2026-05-25 — Схема пайки расширена: + OLED SSD1306 (SPI)

К существующей схеме плата→TB6612→моторы добавлен раздел подключения
**OLED 0.96″ SSD1306 7-pin SPI** (вариант с резисторами 4SPI: R3, R4 — на физическом
модуле уже распаян именно так).

**Распиновка (XIAO → OLED):**
- VCC, RES → 3V3 (RES «всегда HIGH» — драйвер SSD1306 сам инициализируется)
- GND → GND (общая земля)
- CS  → D6 (GPIO 43), DC → D7 (GPIO 44)
- SCK → D8 (GPIO 7), MOSI → D10 (GPIO 9)

**Обоснование:** на гребне XIAO свободны только D6–D10 (D0–D5 заняты драйвером моторов).
Аппаратный SPI ESP32-S3 = D8/D10 → берём их. CS и DC — на D6, D7.
**RES сажаем на 3V3**, экономим 1 GPIO (для SSD1306 это штатно).

**Цена:** пины энкодеров (D6–D9) теперь у OLED — но энкодеров на телеге физически нет.
В прошивке надо отключить ISR-ы:
`DRIVE_ENC_L_A 0, DRIVE_ENC_L_B 0, DRIVE_ENC_R_A 0, DRIVE_ENC_R_B 0` в `drive_config.h`.

**Прошивка OLED пока не использует** — нужно подключить `U8g2` (или Adafruit_SSD1306):
`U8G2_SSD1306_128X64_NONAME_F_4W_HW_SPI(rotation, CS=D6, DC=D7, RST=U8X8_PIN_NONE)`.
Это отдельный шаг, по запросу.

Файл `docs/hardware/wiring-xiao-tb6612.pdf` перезаписан (2 страницы, ~125 КБ);
ссылка в README обновлена (теперь «плата → драйвер → моторы → экран»).

---

## 2026-05-20 — PDF-схема пайки (плата → TB6612 → моторы)

Добавлен печатный PDF с распиновкой для пайки. Источник пинов —
`xiao_cam_stream/drive_config.h` (без догадок): левый канал
D5/D0/D1 → PWMA/AIN1/AIN2 (GPIO 6/1/2), правый — D4/D2/D3 →
PWMB/BIN1/BIN2 (GPIO 5/3/4). Силовая часть TB6612: VM на батарею
4.5–13.5 В, VCC на 3V3 XIAO, общая земля обязательно, STBY = 3V3
(DRIVE_STBY_PIN = −1). Энкодеры и HC-SR04 — опционально, с
предостережением про конфликт D8/D9 с SD-картой и обязательным
делителем 5→3.3 В на ECHO. Резервные пины (камера/мик/LED) явно
перечислены.

- Файл: **`docs/hardware/wiring-xiao-tb6612.pdf`** (A4, 2 стр., ~120 КБ).
- Кириллица: Arial/Consolas из Windows подключены через
  `pdfmetrics.registerFont(TTFont(...))` в reportlab 4.5.
- Содержит таблицы XIAO↔TB6612, ASCII-блок-схему подключений, чек-лист
  перед подачей питания. Ссылка добавлена в `README.md`.

---

## 2026-05-19 — Полноэкранный UI + оверлеи + панель телеметрии

Жалоба: поля в приложении перекрывались.

- **Причина:** layout был вертикальной цепочкой ConstraintLayout
  (поля → видео 0dp → статус → джойстик); на устройстве цепочка
  схлопывалась и элементы налезали друг на друга.
- **Перестроено в полноэкранный режим:** видео `ImageView` =
  `match_parent` (фон), элементы — оверлеи поверх:
  верхняя панель (IP/токен/Подключить, скрывается после подключения),
  телеметрия слева, статус справа, джойстик снизу-слева,
  кнопки (звук/стоп) снизу-справа. Immersive: системные бары скрыты
  (свайп — показать), `onWindowFocusChanged` держит режим.
- **Поля больше не перекрываются:** оверлеи привязаны к углам/панели,
  а не в схлопывающейся цепочке; после подключения поля ввода прячутся
  (`showInputs`), видео на весь экран.
- **Телеметрия в приложении:** `TelemetryPoller` теперь отдаёт компактный
  многострочный блок (fw/темп, WiFi/RSSI/ch, IP, heap/мик dBFS,
  cam fail/кадры, привод L/R/enc/v, УЗ/safety/бампер) — оверлей
  слева, обновление каждые 2 с, устойчиво к отсутствующим полям.
- Файлы: `activity_main.xml` (переписан), `TelemetryPoller.kt`
  (переписан, один колбэк), `MainActivity.kt` (immersive, оверлей-
  телеметрия, скрытие полей). APK BUILD SUCCESSFUL, `dist/` обновлён.

---

## 2026-05-18 — APK положен в репо (скачивание на телефон)

Чтобы ставить APK без USB/проводов: собранный отладочный APK добавлен в
репозиторий — **`dist/xiao-robot-debug.apk`** (~7.2 МБ, сборка с mDNS).
Прямая ссылка для телефона добавлена в `README.md` (raw на ветке
`claude/dev`). Файл перезаписывается при пересборке (стабильное имя →
стабильная ссылка). Сборочные `android/**/build/` остаются в `.gitignore`;
в `dist/` кладём осознанно. Секретов в APK нет (`secrets.h` — только прошивка).

---

## 2026-05-18 — mDNS-автопоиск платы в приложении (IP больше не нужен)

По запросу: приложение само находит плату, IP вводить не надо.

- **Прошивка без изменений** — уже рекламирует `MDNS.begin("xiao-cam")` +
  `addService("http","tcp",80)` → сервис `_http._tcp` инстанс `xiao-cam`.
- **`BoardDiscovery.kt`** (новый): Android NSD — `discoverServices
  ("_http._tcp.")`, фильтр имени по «xiao», `resolveService` → текущий
  IPv4 платы. MulticastLock на время поиска; single-resolve guard
  (ограничение NsdManager до API 34); таймаут; всё в main-поток, один раз.
- **`MainActivity`**: поле пустое / `xiao-cam.local` / `auto` → mDNS-поиск
  (6 с); найдено → старт каналов на найденном IP; не найдено → пробуем
  `last_ip`, иначе просим ввести IP вручную. Литеральный IP → прямой путь
  (ручной фолбэк). `disconnect`/`onDestroy` останавливают поиск.
  Дефолт поля → `xiao-cam.local`; устаревший `.17` мигрирует на авто.
- **Manifest**: +`ACCESS_WIFI_STATE`, +`CHANGE_WIFI_MULTICAST_STATE`.
- Файлы: `BoardDiscovery.kt` (new), `MainActivity.kt`,
  `AndroidManifest.xml`, `strings.xml`, `activity_main.xml`.

**Сборка:** PowerShell-инструмент в сессии завис; APK собран
`java -cp gradle/wrapper/gradle-wrapper.jar
org.gradle.wrapper.GradleWrapperMain assembleDebug` → BUILD SUCCESSFUL,
Kotlin/NSD скомпилировались чисто (7.2 МБ). Поведение NSD на самом
телефоне — подтвердить на устройстве.

**Для пользователя:** поставить новый APK → просто «Подключить»
(IP не вводить; поле можно оставить `xiao-cam.local`).

---

## 2026-05-18 — Приложение слало на .17; дефолтный IP исправлен

**Симптом:** на экране статус `видео: Failed to connect to /192.168.9.17:80`;
поле IP не редактировалось (работали только кнопки). Браузер телефона по
`http://192.168.9.18/capture` — фото ОК (сеть и камера исправны).

**Причина:** дефолтный IP в приложении был захардкожен `192.168.9.17`
(и мог «прилипнуть» в SharedPreferences после прошлого Connect), а плата
по DHCP получила `192.168.9.18`. Приложение стучалось не туда. Трудность
с правкой поля усугубляла.

**Фикс (приложение):** дефолт хоста → `192.168.9.18`; авто-миграция
сохранённого устаревшего `.17` → `.18` (`MainActivity.onCreate`);
`activity_main.xml` дефолт-текст → `.18`. APK пересобран.

**Сборочное:** инструмент PowerShell в сессии завис (любые команды exit 1
без вывода), `gradlew.bat` через cmd не отрабатывал. APK собран
shell-агностично: `java -cp gradle/wrapper/gradle-wrapper.jar
org.gradle.wrapper.GradleWrapperMain assembleDebug` → BUILD SUCCESSFUL.

**Durable-рекомендация:** DHCP-резервация на роутере
(MAC `E8:F6:0A:8B:C3:84` → `192.168.9.18`) — тогда IP постоянный и поле
вообще не трогать. Опционально на будущее: Android NSD/mDNS
(`xiao-cam.local`), чтобы IP стал неважен.

**Установка:** удалить старое приложение → поставить новый APK → открыть →
«Подключить» (вводить ничего не нужно).

---

## 2026-05-18 — «Камера не подключается»: OV3660 QXGA→FB-OVF, исправлено

**Симптом:** плата в WiFi, но в приложении нет видео; `/capture` → HTTP 500.

**Диагноз на железе:** сенсор OV3660 (`cam_pid=0x3660`) был сконфигурирован на
**QXGA + jpeg_quality=2** (почти максимум). На непрерывном MJPEG это
переполняет буфер кадров → бесконечный `cam_hal: FB-OVF` →
`esp_camera_fb_get()` стабильно `NULL`. Телеметрия: `cam_fail`растёт,
`cam_frames_stream=0`, `/capture` отдаёт 500 «capture failed» (14 Б).
Т.е. ранняя пометка «FB-OVF безвреден» оказалась неверной под нагрузкой —
это и есть причина отсутствия видео (Фаза 2, всплыло только на железе).

**Фикс** (`xiao_cam_stream/initCamera`): стабильный потоковый профиль —
`config`: `FRAMESIZE_SVGA` + `jpeg_quality=12` (fb_count=2, GRAB_LATEST);
пост-init для OV3660/OV2640: `set_framesize(SVGA)` + `set_quality(12)`
(было QXGA/UXGA @ q2). Разрешение можно поднять позже, если поток стабилен.

**Проверка на железе (после reflash):** `FB-OVF=0`, `cam_fail=0`,
`/capture` → 200, **JPEG ~21 КБ** (3/3); `/stream` → ~1 МБ/4 с,
`cam_frames_stream=48` → **≈12 fps**. Плата `192.168.9.18`,
`Duangdeehouse2  2.4GHz`, RSSI −46. Камера и поток стабильны.

**Для приложения:** IP = `192.168.9.18`, телефон в той же 2.4 ГГц сети.

---

## 2026-05-18 — Видео/аудио в приложении не стартовали → плата выведена в WiFi

**Симптом:** на смартфоне приложение открылось, но видео и звук не идут.

**Диагноз (по serial, не догадки):** приложение ни при чём — **плата не в
WiFi**. Сначала была прошита с плейсхолдер-`secrets.h` (`YOUR_WIFI_PASSWORD`),
затем — с неверным написанием SSID. `wifi_status=disconnected`, `ip=0.0.0.0`.

**Решение:** временным скетчем-сканером считал эфир радио платы →
**точный SSID = `Duangdeehouse2  2.4GHz`** (ДВА пробела перед «2.4GHz»;
RSSI −41, WPA2). Прописал точный SSID + пароль в `xiao_cam_stream/secrets.h`
(gitignored, в репо не идёт; pre-commit хук тоже блокирует), перепрошил.

**Результат:** `wifi_status=connected`, **IP `192.168.9.18`**, RSSI −43.
Сквозная проверка по WiFi с ПК: `GET /telemetry` → 200,
`GET /capture` → 200, **JPEG 370 КБ**. `cam_fail=0` — простойный
`cam_hal: FB-OVF` подтверждённо безвреден (полный кадр отдаётся).

**Для приложения:** ввести IP **`192.168.9.18`** (дефолт в приложении
`192.168.9.17` — мимо на единицу), телефон в сети `Duangdeehouse2  2.4GHz`.
Альтернатива на будущее: mDNS `xiao-cam.local` или DHCP-резервация
(чтобы IP не «плавал»). Креды в git не попали (только этот dev-log).

---

## 2026-05-17 — Прошивка на железе + APK собран

Плата подключена по USB — прошили и собрали APK здесь.

- **Прошивка залита на плату** (COM5, FQBN `esp32:esp32:XIAO_ESP32S3:PSRAM=opi`):
  bootloader/partitions/app записаны, **hash verified**, hard-reset.
- **Boot подтверждён по USB serial**: телеметрия идёт, видны новые поля
  Фаз 2/3 — `cam_fail`, `spd_l`/`spd_r`, `drive_safety` (=0: сенсоры
  инертны/не разведены), микрофон активен (`mic_dbfs≈-27`), `chip_temp≈59°C`.
  Правки Фаз 1–3 работают на реальном железе (компиляция + базовый рантайм).
- **Known-issue:** на idle (без stream-клиента) спам `cam_hal: FB-OVF`
  (переполнение буфера кадров). **Не регрессия** — наш диф не трогал
  `grab_mode`/`fb_count`; типовое поведение esp32-camera без потребителя
  кадров. Проверить, что уходит при активном MJPEG/WiFi; кандидат на
  DMA-стриминг (вывод из веб-анализа esp32-cam-fpv).
- **Android APK собран:** поставлены JDK 17 (Temurin 17.0.19) + Android SDK
  (cmdline-tools, `platform-35`, `build-tools;35.0.0`, `platform-tools`;
  лицензии через hash-файлы; `local.properties` — gitignored).
  `gradlew assembleDebug` → **BUILD SUCCESSFUL**, `app-debug.apk` 6.0 МБ.
  Подтверждает Android-правки Фаз 1–3 (поле токена, reconnect/ошибки,
  индикаторы сенсоров).
- Снимает оговорку «прошивку/APK тут собрать нельзя» из ранних записей.
  Тулчейн (`arduino-cli`/JDK/SDK) и `secrets.h` — вне git (gitignored).

### Дальше (требует пользователя/железа)
Runtime-проверки в WiFi: MJPEG/латентность (и `FB-OVF` под нагрузкой),
cross-core I2S при `mic=0`, рефлекс «стоп», одометрия с моторами;
разводка УЗ/бамперов; user-gated чистка git-истории (пароль).

---

## 2026-05-17 — Верификация прошивки локально (arduino-cli)

На машине нашлись Arduino IDE-ядро и Python — прошивку удалось собрать здесь.

- `arduino-cli` 1.5.0 (portable в `tools/`, gitignored); переиспользовано уже
  установленное ядро `esp32:esp32` **3.3.8** из `Arduino15` через
  `ARDUINO_DIRECTORIES_DATA` — без повторной закачки ядра.
- `arduino-cli compile --fqbn esp32:esp32:XIAO_ESP32S3:PSRAM=opi xiao_cam_stream`
  → **успех, 0 ошибок, 0 предупреждений** в наших источниках.
- Размер: 1 181 569 Б флэш (**35 %**), глобальные 62 476 Б (**19 %**).
- `secrets.h` создан из example (gitignored, не коммитится).

### Что это даёт
Прошивочные правки **Фаз 1–3 подтверждены на уровне компиляции**: токен/
`apiAuthOk`, `initCamera` retry + `cam_fail`, `telemetryMicApplyState`
(I2S-release), антидребезг энкодеров + рефлекс безопасности + `spd_*`/
`drive_safety` в `/telemetry`. Это снимает прежнюю оговорку «в этой среде
собрать нельзя» для прошивки. Runtime/HW (cross-core I2S, рефлекс,
одометрия, реальные FPS) — по-прежнему требует платы.

---

## 2026-05-17 — Фаза 5 (гигиена и релиз) — роадмап завершён

- `LICENSE` — **MIT** (выбор владельца; правообладатель `soulhiler` —
  при необходимости поправить имя).
- CI `.github/workflows/build.yml`: 3 джобы — тесты `brain/`
  (unittest), сборка прошивки (`arduino-cli`, FQBN
  `esp32:esp32:XIAO_ESP32S3:PSRAM=opi`, secrets.h из example),
  сборка APK (`gradlew assembleDebug`, артефакт).
- `.editorconfig` — utf-8, отступы по типам, LF для `.githooks/*` и `*.sh`.
- `docs/onboarding.md` — инструкция новичку «с нуля» (Git/Python/Cursor,
  безопасность, прошивка, APK, мозг, git-workflow). Закрывает запрос из
  ранней Cursor-сессии.
- README: добавлены `brain/`, `onboarding.md`, `dev-log.md`, CI,
  security-runbook в «Состав».

### Статус верификации
`brain/`-тесты зелёные локально (9/9). Джобы прошивки/APK — стандартные
рецепты, реальный прогон — на CI/железе (в этой среде нет ESP32-core/SDK).

### Итог роадмапа
Фазы 1–5 выполнены автономно. Открыто (требует пользователя):
ротация Wi-Fi пароля + рерайт git-истории (`docs/security-history-cleanup.md`),
on-hardware верификация прошивки/APK, разводка УЗ/бамперов.

---

## 2026-05-17 — Фаза 4 (ИИ-«мозг»)

Новый компонент `brain/` (Python, stdlib; Pillow опц.). **Прошивка не
менялась** — переиспользован существующий HTTP-контракт + токен Фазы 1.
Транспортно-нейтрален (ПК-сервер или порт на телефон).

- `robot.py` — клиент платы (`/telemetry`, `/capture`, `/drive`, `?t=`).
- `perception.py` — `Recognizer` + `Dummy` (без зависимостей) + `Brightness`
  (Pillow опц., graceful fallback). Модель добавляется новой реализацией —
  архитектура от модели не зависит.
- `safety.py` — `SafetyGovernor` (чистая функция `decide`): рефлекс прошивки
  приоритетен, УЗ-стоп (`us_cm==0`≠препятствие), таймаут перцепции,
  неуверенность → стоп; темп команд `min(0.25, watchdog/2)` < 450 мс.
- `brain.py` — CLI + цикл perceive→decide→govern→act; аварийный `stop()`
  при потере связи и в `finally`; `--dry-run/--once` для офлайн-проверки.
- `test_safety.py` — 9 юнит-тестов governor.
- `docs/brain-api.md` — контракт и модель безопасности; `brain/README.md`;
  обновлён корневой README.

### Статус верификации
**Проверено здесь:** `python -m unittest discover -s brain` → 9/9 OK;
`brain.py --dry-run --once` проходит весь контур офлайн (корректный tank-mix).
На железе с платой — шаг пользователя.

### Дальше
Фаза 5 — гигиена/релиз: LICENSE, CI (arduino-cli + gradle + brain-тесты),
инструкция для новичка (Cursor/Python/Git), `.editorconfig`, релиз APK.

---

## 2026-05-17 — Фаза 3 (сенсоры и базовая автономность)

Код сделан корректным и устойчивым, **по умолчанию инертен** (УЗ/бамперы
выключены пинами `0`). Физическая разводка, выбор GPIO и проверка на плате —
шаг пользователя (см. `drive_config.h.example`); собрать/протестировать в этой
среде нельзя.

- `drive_config.h(.example)`: добавлены `DRIVE_ENC_DEBOUNCE_US` (антидребезг
  энкодера, по умолч. 150 мкс) и `DRIVE_US_STOP_CM` (порог рефлекса по УЗ);
  в `xiao_drive.h` — защитные `#ifndef` дефолты.
- Энкодеры: антидребезг в ISR по `micros()` (отбрасывает слишком близкие
  фронты); добавлен расчёт скорости `spd_l/spd_r` (тики/с).
- Рефлекс безопасности: единый латч (бампер | близкое УЗ), перекрывает
  команды клиента через гейт в `driveApplyMotors` (рефлекс важнее клиента),
  авто-сброс при пропадании препятствия. `us_cm==0` (нет эха/вне диапазона)
  НЕ считается препятствием — нет ложного стопа.
- УЗ читается до оценки безопасности; `pulseIn` троттлится ~120 мс.
- `/telemetry`: добавлены `spd_l`, `spd_r`, `drive_safety`.
- Android `TelemetryPoller`+`MainActivity`: компактная сводка сенсоров
  (СТОП-рефлекс/бампер/УЗ см/enc/v) в строке статуса.

### Дальше
Фаза 4 — ИИ-«мозг»: компонент `brain/` (Python, транспортно-нейтральный —
сервер или телефон), контракт API (`docs/brain-api.md`), safety-governor
(темп команд ≤ watchdog, аварийный стоп при потере связи), заглушка-распознавание.

---

## 2026-05-17 — Фазы 1–2

### Фаза 1 — Безопасность (автономная часть готова)
- Утёкший Wi-Fi пароль вырезан из архива Cursor
  (`chat-67f50fc7…jsonl`, 8 вхождений → `***REDACTED***`), zip пересобран;
  рабочее дерево и zip чисты.
- `.githooks/pre-commit` — блокировка секретов; раздел «Безопасность» в README.
- Опциональный `XIAO_API_TOKEN`: `apiAuthOk()` на `/drive` и `/control`
  (пустой = выключено, обратная совместимость с прокси/tooling);
  проброшен в Android (поле «Токен», SharedPrefs, `?t=`).
- **User-gated, НЕ выполнено:** ротация пароля роутера + рерайт git-истории +
  force-push (`docs/security-history-cleanup.md`). Пароль остаётся в истории
  коммита `b283eab` до ручной чистки владельцем репозитория.

### Фаза 2 — Надёжность ядра (готово)
- Android `MicPlayer`: bounded connect, авто-reconnect с backoff 0.8→4 с,
  корректный `stop()`, статус отражает реальное состояние.
- Android `MjpegStream`: конечный `readTimeout` 6 с (не виснет, реконнект);
  при переполнении буфера сохраняем хвост от последнего SOI; убран дубль-импорт.
- Android `DriveClient`: ошибки сети/HTTP-код выводятся в статус по смене
  состояния (видно «нет связи» / 403 неверный токен), без спама на 120 мс.
  `TelemetryPoller` намеренно тихий (его сбой виден как устаревший Wi-Fi).
- Поворот экрана: уже покрыт манифестом (`portrait` + `configChanges`) —
  кода не требуется.
- Прошивка: `initCamera()` — 3 попытки + `esp_camera_deinit` + восстановление
  статус-LED на провале; счётчик `cam_fail` в `/telemetry`.
- Прошивка: освобождение I2S при `/control?mic=0` (`telemetryMicApplyState`,
  безопасно к Core 1 `micTcpTask` через гейты `gCtrlMicEnabled`/`gMicOk`).

### Статус верификации
Прошивку (`arduino-cli`) и APK (Android SDK/JDK 17) в текущей среде собрать
нельзя и без платы не протестировать — компиляция/прогон вынесены в шаг
верификации на железе (`tools/xiao_flash_and_telemetry.ps1`;
`gradlew assembleDebug`). Код выверен по месту, по существующим паттернам.

### Дальше
Фаза 3 — сенсоры и базовая автономность: УЗ HC-SR04 + бамперы, debounce
энкодеров + одометрия в `/telemetry`, аппаратный рефлекс «стоп при
препятствии», индикаторы сенсоров в Android.
