soulhiler/Dengojui-Ardu/xiao_cam_stream/drive_config.h

#pragma once
/**
 * TB6612FNG (BOM #2). На корпусе часто: «TB717A3» + «6612FNG» (или TB67… — та же микросхема).
 * Камера Sense: GPIO 10–18, 38–48; мик 41–42; LED 21 — не использовать.
 *
 * TB6612: STBY → 3.3 V (или DRIVE_STBY_PIN). VM — питание моторов, VCC — 3.3 V, общая GND.
 *
 * VL53L7CX: отдельная шина I2C — не камера SCCB (39/40).
 * НЕ использовать GPIO19/20 — это USB D−/D+ (после Wire.begin(20) пропадает COM, Wi‑Fi жив).
 * По умолчанию SDA=GPIO8 (D9), SCL=GPIO9 (D10). Провод SDA с «левого» пина — на D9, не на 20.
 * LPn модуля обязан быть HIGH (на 3.3 V или XIAO_TOF_LPN_PIN), иначе сенсор молчит на I2C.
 */

#define XIAO_DRIVE_ENABLE 1
#define XIAO_DRIVE_DRIVER_TB6612 1

/** -1 = STBY закорочен на 3.3 V на модуле */
#define DRIVE_STBY_PIN -1

/* PWMA/AIN1/AIN2 — левый мотор; PWMB/BIN1/BIN2 — правый */
#define DRIVE_L_PWM 6   /* D5  → PWMA */
#define DRIVE_L_IN1 1   /* D0  → AIN1 */
#define DRIVE_L_IN2 2   /* D1  → AIN2 */
#define DRIVE_R_PWM 5   /* D4  → PWMB */
#define DRIVE_R_IN1 3   /* D2  → BIN1 */
#define DRIVE_R_IN2 4   /* D3  → BIN2 */

#define DRIVE_L_DIR 1
#define DRIVE_R_DIR 3

/** Энкодеры не установлены — все 0 (не вешать pull-up на пустые пины). */
#define DRIVE_ENC_L_A 0
#define DRIVE_ENC_L_B 0
#define DRIVE_ENC_R_A 0
#define DRIVE_ENC_R_B 0

#define DRIVE_US_TRIG 0
#define DRIVE_US_ECHO 0
#define DRIVE_US_ENABLE 0

#define DRIVE_BUMPER_PIN_1 0
#define DRIVE_BUMPER_PIN_2 0

#define DRIVE_PWM_FREQ_HZ 20000
#define DRIVE_PWM_BITS 8
#define DRIVE_WATCHDOG_MS 450

/** VL53L7CX (мультизонный 4×4/8×8). 0 — отключить ToF/радар/scan360 в прошивке. */
#define XIAO_TOF_ENABLE 1
#define XIAO_TOF_SDA 8
#define XIAO_TOF_SCL 9
/** LPn модуля: -1 = перемычка на 3.3 V; иначе номер GPIO (например 7 = D8).
 *  7 = D8 (GPIO7) — управляемый LPn: аппаратный сброс сенсора и recovery
 *  зависшей шины I2C тоглом LOW→HIGH (см. xiao_tof.h). Перемычку LPn–3V3 снять. */
#define XIAO_TOF_LPN_PIN 7
/** I2C_RST (есть не на всех breakout): -1 = не подключён. */
#define XIAO_TOF_I2C_RST_PIN -1
/** Порог шума зоны: range_sigma_mm выше — зона отбрасывается (мм). 0 — выкл
 *  фильтр. Меньше = строже (меньше ложных близких), больше = терпимее к
 *  дальним/тёмным целям. 15 — разумный старт. */
#define XIAO_TOF_SIGMA_MAX_MM 15

/** Звук через обмотки TB6612 (как uno_motor_test). */
#define XIAO_AUDIO_ENABLE 1


/** MPU6050 (GY-521) — 6-осевой IMU для курса. Делит I2C-шину с ToF (адрес 0x68).
 *  0 — выключить. SDA/SCL берутся из XIAO_TOF_SDA/SCL (та же шина). */
#define XIAO_IMU_ENABLE 1
