soulhiler/Dengojui-Ardu/android/XiaoRobot/app/src/main/java/com/denzhogzhuy/xiaorobot/MainActivity.kt

package com.denzhogzhuy.xiaorobot

import android.graphics.Bitmap
import android.graphics.Typeface
import android.os.Bundle
import android.widget.SeekBar
import android.widget.TextView
import android.widget.Toast
import androidx.appcompat.app.AppCompatActivity
import androidx.core.view.ViewCompat
import androidx.core.view.WindowInsetsCompat
import androidx.lifecycle.lifecycleScope
import com.denzhogzhuy.xiaorobot.databinding.ActivityMainBinding
import org.json.JSONObject
import kotlin.math.roundToInt

class MainActivity : AppCompatActivity() {

    private lateinit var binding: ActivityMainBinding
    private val mjpeg = MjpegStream(lifecycleScope, ::showFrame, ::setStatusPart)
    private val mic = MicPlayer(lifecycleScope, ::setStatusPart)
    private val drive = DriveClient(lifecycleScope)
    private val updater = AppUpdater(this, ::setStatusPart)
    private val telemetry = TelemetryPoller(
        lifecycleScope,
        onInfo = { ch, rssi, ssid ->
            wifiInfo = "Wi‑Fi ch$ch · ${rssi} dBm · $ssid"
            updateStatusLine()
        },
        onJson = ::onTelemetryJson,
        busy = { drive.cmdL != 0 || drive.cmdR != 0 },   // едем → не дёргаем тяжёлую /telemetry
    )

    private val discovery by lazy { BoardDiscovery(this, ::setStatusPart) }

    private var connected = false
    private var wifiInfo = ""
    private var tofInfo = ""
    private var driveInfo = ""
    private var micOn = false
    private var host: String = ""
    /** true, пока подключены к SoftAP робота в режиме «только точка» (apmode=1). */
    private var apOnlyActive = false

    /** Мощность джойстика 40..255 и скважность «пения» 10..100 % — как слайдеры в веб-дашборде. */
    private var joyPower = 180
    private var audioGain = 10

    private val prefs by lazy {
        getSharedPreferences("xiao_robot", MODE_PRIVATE)
    }

    override fun onCreate(savedInstanceState: Bundle?) {
        super.onCreate(savedInstanceState)
        binding = ActivityMainBinding.inflate(layoutInflater)
        setContentView(binding.root)

        // targetSdk 35: edge-to-edge принудительный — без отступов контент
        // уезжает под статусбар и системную навигацию (поля/кнопки накладываются).
        val basePad = (12 * resources.displayMetrics.density).toInt()
        ViewCompat.setOnApplyWindowInsetsListener(binding.root) { v, insets ->
            val bars = insets.getInsets(WindowInsetsCompat.Type.systemBars())
            v.setPadding(basePad + bars.left, basePad + bars.top, basePad + bars.right, basePad + bars.bottom)
            insets
        }

        // По умолчанию — авто-поиск по mDNS (xiao-cam.local), IP знать не нужно.
        // Устаревший «прилипший» .17 сбрасываем на авто.
        val savedHost = prefs.getString("host", "xiao-cam.local") ?: "xiao-cam.local"
        binding.editIp.setText(if (savedHost == "192.168.9.17") "xiao-cam.local" else savedHost)

        binding.btnConnect.setOnClickListener {
            if (connected) disconnectAll() else connectAll()
        }
        // Долгое нажатие «Подключить» — задать токен API (для интернета/защиты управления).
        binding.btnConnect.setOnLongClickListener { askApiToken(); true }
        // Прямое подключение к собственной точке робота (SoftAP, 192.168.4.1) — без роутера.
        binding.btnSoftAp.setOnClickListener { connectSoftAp() }
        binding.btnStop.setOnClickListener { sendStop() }
        binding.btnMic.setOnClickListener { toggleMic() }
        // «Обновить» — из GitHub-релиза apk-latest (по сети, без ПК). Долгое нажатие —
        // запасной путь: обновление с ПК-дашборда в LAN (askUpdateHost).
        binding.btnUpdate.setOnClickListener { updater.checkGithubAndInstall(lifecycleScope) }
        binding.btnUpdate.setOnLongClickListener { askUpdateHost(); true }

        bindJoystick(binding.joystick)
        bindJoystick(binding.joystickOverlay)

        setupTabs()
        setupControls()
    }

    private var motorInfo = ""

    /** Один обработчик на оба джойстика (главный экран и оверлей на телеметрии). */
    private fun bindJoystick(j: JoystickView) {
        j.onMove = { nx, ny ->
            val l = tankMix(nx, ny, left = true)
            val r = tankMix(nx, ny, left = false)
            drive.cmdL = l
            drive.cmdR = r
            motorInfo = "L=$l R=$r"
            updateStatusLine()
        }
        j.onRelease = {
            // НЕ останавливаем цикл отправки (drive.stopSending убивал driveJob,
            // и после первого касания джойстик переставал работать). Обнуляем
            // команды — живой цикл сам шлёт /drive?stop=1, пока джойстик отпущен.
            drive.cmdL = 0
            drive.cmdR = 0
            motorInfo = ""
            updateStatusLine()
        }
    }

    // --- Вкладки ---

    private fun setupTabs() {
        binding.bottomNav.setOnItemSelectedListener { item ->
            binding.pageRobot.visibility = if (item.itemId == R.id.tabRobot) android.view.View.VISIBLE else android.view.View.GONE
            binding.pageTelemetry.visibility = if (item.itemId == R.id.tabTelemetry) android.view.View.VISIBLE else android.view.View.GONE
            binding.pageControls.visibility = if (item.itemId == R.id.tabControls) android.view.View.VISIBLE else android.view.View.GONE
            // Джойстик-оверлей на телеметрии: рулить и смотреть drive_cmd_l/r одновременно.
            binding.joystickOverlay.visibility =
                if (item.itemId == R.id.tabTelemetry) android.view.View.VISIBLE else android.view.View.GONE
            if (item.itemId == R.id.tabTelemetry) {
                lastJson?.let { renderTelemetry(it) }
            }
            true
        }
        binding.bottomNav.selectedItemId = R.id.tabRobot
    }

    // --- Вкладка «Управление» ---

    /** true, пока выставляем тогглы из телеметрии — чтобы не слать /control обратно. */
    private var updatingSwitches = false

    private fun setupControls() {
        joyPower = prefs.getInt("joy_max_spd", 180).coerceIn(40, 255)
        audioGain = prefs.getInt("audio_gain", 10).coerceIn(10, 100)
        binding.seekPower.progress = joyPower
        binding.seekGain.progress = audioGain
        refreshSliderLabels()

        binding.seekPower.setOnSeekBarChangeListener(object : SeekBar.OnSeekBarChangeListener {
            override fun onProgressChanged(sb: SeekBar?, value: Int, fromUser: Boolean) {
                joyPower = value.coerceIn(40, 255)
                refreshSliderLabels()
            }
            override fun onStartTrackingTouch(sb: SeekBar?) {}
            override fun onStopTrackingTouch(sb: SeekBar?) {
                prefs.edit().putInt("joy_max_spd", joyPower).apply()
            }
        })
        binding.seekGain.setOnSeekBarChangeListener(object : SeekBar.OnSeekBarChangeListener {
            override fun onProgressChanged(sb: SeekBar?, value: Int, fromUser: Boolean) {
                audioGain = value.coerceIn(10, 100)
                refreshSliderLabels()
            }
            override fun onStartTrackingTouch(sb: SeekBar?) {}
            override fun onStopTrackingTouch(sb: SeekBar?) {
                prefs.edit().putInt("audio_gain", audioGain).apply()
            }
        })

        val switches = mapOf(
            binding.swWifi to "wifi",
            binding.swBle to "ble",
            binding.swCam to "cam",
            binding.swMic to "mic",
            binding.swDrive to "drive",
        )
        switches.forEach { (sw, key) ->
            sw.setOnCheckedChangeListener { _, isChecked ->
                if (updatingSwitches) return@setOnCheckedChangeListener
                if (!requireConnected()) return@setOnCheckedChangeListener
                drive.control(host, key, isChecked)
            }
        }

        binding.btnBeep.setOnClickListener { if (requireConnected()) drive.beep(host, audioGain) }
        binding.btnMelody1.setOnClickListener { if (requireConnected()) drive.melody(host, 1, audioGain) }
        binding.btnSayHi.setOnClickListener { if (requireConnected()) drive.melody(host, 9, audioGain) }
        binding.btnSoundStop.setOnClickListener { if (requireConnected()) drive.melody(host, 0, audioGain) }
    }

    private fun refreshSliderLabels() {
        binding.lblPower.text = "Мощность джойстика: $joyPower/255"
        binding.lblGain.text = "Пение (скважность): $audioGain%"
    }

    private fun requireConnected(): Boolean {
        if (!connected || host.isEmpty()) {
            Toast.makeText(this, "Сначала подключитесь", Toast.LENGTH_SHORT).show()
            return false
        }
        return true
    }

    // --- Вкладка «Телеметрия» (зеркало веб-дашборда) ---

    private var lastJson: JSONObject? = null

    /** Сводка — 10 основных показателей, как CORE_TELEM_MAIN в tools/xiao_serial_telemetry.py. */
    private val coreFields = listOf(
        "uptime_ms" to "Время с перезагрузки",
        "fw_version" to "Версия прошивки",
        "wifi_status" to "Wi‑Fi: статус",
        "wifi_ssid" to "Имя сети (SSID)",
        "wifi_ip" to "IP в сети",
        "wifi_rssi" to "Сигнал Wi‑Fi (RSSI)",
        "heap_free" to "Свободная куча (SRAM)",
        "psram_free_esp" to "Свободная PSRAM",
        "cam_frames_stream" to "Кадров MJPEG всего",
        "mic_dbfs" to "Уровень микрофона (dBFS)",
    )

    private val groupOrder = listOf(
        "Система и MCU", "Память", "Flash и OTA", "Wi-Fi", "Управление",
        "Bluetooth LE", "Точка доступа (AP)", "Камера", "Микрофон", "Датчики",
        "Привод", "Прочее",
    )

    /** Группа ключа — как groupOf() в веб-дашборде (без ПК-шных групп Прокси/USB). */
    private fun groupOf(k: String): String = when {
        k.startsWith("ctrl_") -> "Управление"
        k == "chip_temp_c" -> "Датчики"
        k.startsWith("ble_") -> "Bluetooth LE"
        k.startsWith("mic_") -> "Микрофон"
        k.startsWith("cam_") -> "Камера"
        k.startsWith("ap_") -> "Точка доступа (AP)"
        k.startsWith("tof_") -> "Датчики"
        k.startsWith("drive_") || k == "enc_l" || k == "enc_r" -> "Привод"
        k.startsWith("wifi_") -> "Wi-Fi"
        k.startsWith("part_") || k.startsWith("sketch_") || k.startsWith("flash_") -> "Flash и OTA"
        k.startsWith("heap_") || k.startsWith("psram_") || k == "stack_watermark" || k == "rtos_task_count" -> "Память"
        k.startsWith("uptime") || k.startsWith("micros") || k.startsWith("reset") || k.startsWith("led_") ||
            k.startsWith("fw_") || k.startsWith("chip_") || k.startsWith("cpu_") || k == "sdk" ||
            k.startsWith("core_") || k.startsWith("arduino") || k.startsWith("efuse") -> "Система и MCU"
        else -> "Прочее"
    }

    private fun onTelemetryJson(j: JSONObject) {
        lastJson = j
        // Базовая телеметрия на главном экране: ToF в статус-строку.
        tofInfo = if (j.optInt("tof_ok", 0) == 1) {
            val mm = j.optInt("tof_mm", 0)
            if (j.optInt("tof_valid", 0) == 1 && mm > 0) "ToF $mm мм" else "ToF —"
        } else ""
        // Почему моторы могут молчать — сразу в статус, не копаясь в телеметрии.
        driveInfo = when {
            j.optInt("drive_hw", 0) == 0 -> ""
            j.optInt("drive_enabled", 1) == 0 -> "⚠ привод ВЫКЛ (вкладка Управление)"
            j.optInt("drive_safety", 0) != 0 -> "⚠ рефлекс-стоп (бампер/УЗ)"
            j.optInt("drive_watchdog", 0) == 1 -> "⚠ watchdog: команды не доходят"
            else -> ""
        }
        updateStatusLine()
        syncSwitches(j)
        if (binding.pageTelemetry.visibility == android.view.View.VISIBLE) {
            renderTelemetry(j)
        }
    }

    private fun syncSwitches(j: JSONObject) {
        // Трогаем тумблер только если ключ реально пришёл — иначе optInt-дефолт
        // «сбрасывал» состояние (привод всегда выглядел выключенным).
        updatingSwitches = true
        if (j.has("ctrl_wifi")) binding.swWifi.isChecked = j.optInt("ctrl_wifi", 1) == 1
        if (j.has("ctrl_ble")) binding.swBle.isChecked = j.optInt("ctrl_ble", 0) == 1
        if (j.has("ctrl_cam")) binding.swCam.isChecked = j.optInt("ctrl_cam", 0) == 1
        if (j.has("ctrl_mic")) binding.swMic.isChecked = j.optInt("ctrl_mic", 0) == 1
        // Привод: в /telemetry состояние называется drive_enabled (ctrl_drive — только в ответе /control).
        if (j.has("drive_enabled")) binding.swDrive.isChecked = j.optInt("drive_enabled", 1) == 1
        updatingSwitches = false
    }

    private fun addTelemetryText(text: String, header: Boolean) {
        val tv = TextView(this)
        tv.text = text
        if (header) {
            tv.setTextColor(0xFF58A6FF.toInt())
            tv.textSize = 15f
            tv.setTypeface(null, Typeface.BOLD)
            tv.setPadding(0, dp(14), 0, dp(4))
        } else {
            tv.setTextColor(0xFFC9D1D9.toInt())
            tv.textSize = 12f
            tv.typeface = Typeface.MONOSPACE
            tv.setPadding(0, 0, 0, dp(2))
        }
        binding.telemetryList.addView(tv)
    }

    private fun dp(v: Int): Int = (v * resources.displayMetrics.density).toInt()

    private fun renderTelemetry(j: JSONObject) {
        binding.telemetryList.removeAllViews()

        addTelemetryText("Сводка — 10 основных показателей", header = true)
        coreFields.forEach { (key, label) ->
            if (j.has(key)) {
                addTelemetryText("$label: ${j.opt(key)}", header = false)
            }
        }

        val buckets = LinkedHashMap<String, MutableList<String>>()
        groupOrder.forEach { buckets[it] = mutableListOf() }
        val keys = j.keys().asSequence().toList().sorted()
        keys.forEach { k ->
            val g = groupOf(k)
            buckets.getOrPut(g) { mutableListOf() }.add("$k = ${j.opt(k)}")
        }
        buckets.forEach { (g, rows) ->
            if (rows.isEmpty()) return@forEach
            addTelemetryText(g, header = true)
            rows.forEach { addTelemetryText(it, header = false) }
        }
    }

    // --- Подключение ---

    private fun connectAll() {
        val field = binding.editIp.text?.toString()?.trim()
            ?.removePrefix("http://")?.removeSuffix("/") ?: ""
        prefs.edit().putString("host", if (field.isEmpty()) "xiao-cam.local" else field).apply()
        connected = true
        binding.btnConnect.text = getString(R.string.disconnect_session)
        // Маршрутизировать запросы через Wi-Fi (робот в LAN/без интернета — не через моб. данные).
        WifiBinder.bindToWifi(this)

        val auto = field.isEmpty() ||
            field.equals("xiao-cam.local", ignoreCase = true) ||
            field.equals("auto", ignoreCase = true)
        if (auto) {
            setStatusPart("поиск платы по mDNS…")
            discovery.find(
                timeoutMs = 6000L,
                onFound = { ip, _ ->
                    setStatusPart("плата найдена: $ip")
                    startSessions(ip)
                },
                onFail = {
                    val last = prefs.getString("last_ip", "") ?: ""
                    if (last.isNotEmpty()) {
                        setStatusPart("mDNS не нашёл — пробую $last")
                        startSessions(last)
                    } else {
                        connected = false
                        binding.btnConnect.text = getString(R.string.connect)
                        setStatusPart("плата не найдена. Включи плату или впиши IP")
                    }
                },
            )
        } else {
            startSessions(field)
        }
    }

    /** Прямое подключение к собственной точке робота (SoftAP). Телефон должен быть в сети XIAO-Robot. */
    private fun connectSoftAp() {
        if (connected) disconnectAll()
        // Привязка к Wi-Fi: сеть робота без интернета, иначе Android уведёт запрос в моб. данные.
        val bound = WifiBinder.bindToWifi(this)
        binding.editIp.setText("192.168.4.1")
        prefs.edit().putString("host", "192.168.4.1").apply()
        connected = true
        binding.btnConnect.text = getString(R.string.disconnect_session)
        setStatusPart(
            if (bound) "SoftAP: трафик через Wi-Fi → 192.168.4.1…"
            else "нет Wi-Fi — подключись к сети XIAO-Robot",
        )
        startSessions("192.168.4.1")
    }

    /** Ввод токена API (заголовок X-Auth-Token для эндпоинтов управления; нужен при выходе в интернет). */
    private fun askApiToken() {
        val input = android.widget.EditText(this).apply {
            setText(prefs.getString("api_token", "") ?: "")
            hint = "пусто = без токена"
        }
        androidx.appcompat.app.AlertDialog.Builder(this)
            .setTitle(getString(R.string.api_token_title))
            .setView(input)
            .setPositiveButton(android.R.string.ok) { _, _ ->
                val t = input.text.toString().trim()
                prefs.edit().putString("api_token", t).apply()
                drive.token = t
                setStatusPart(if (t.isEmpty()) "токен очищен" else "токен задан")
            }
            .setNegativeButton(android.R.string.cancel, null)
            .show()
    }

    /** Запуск всех каналов на известном хосте/IP. */
    private fun startSessions(h: String) {
        host = h
        prefs.edit().putString("last_ip", h).apply()
        drive.token = prefs.getString("api_token", "") ?: ""
        drive.enableBoard(h)
        // Прямое к SoftAP (192.168.4.1) → «только точка» (всё радио телефону, меньше лага);
        // обычное подключение → AP+STA (робот на домашнем WiFi).
        apOnlyActive = h == "192.168.4.1"
        drive.control(h, "apmode", apOnlyActive)
        // На прямой точке (узкая полоса) — лёгкий видеопоток QVGA; по дому — SVGA.
        drive.control(h, "vsize", if (apOnlyActive) "qvga" else "svga")
        mjpeg.start(h)
        drive.startSending(h)
        telemetry.start(h)
        setStatusPart("подключено к $h")
        autoCheckUpdate()
    }

    /**
     * Авто-обновление: после подключения тихо ищем дашборд ПК (mDNS «xiao-dash»)
     * и сравниваем версии. Есть новее — качаем и зовём установщик; нет ПК — молчим.
     */
    private fun autoCheckUpdate() {
        // Тихая авто-проверка из GitHub-релиза (если есть интернет). На SoftAP без инета
        // молча не сработает — это нормально.
        binding.root.postDelayed({
            if (!connected) return@postDelayed
            updater.checkGithubAndInstall(lifecycleScope, quiet = true)
        }, 2500L)
    }

    private fun disconnectAll() {
        // Возврат робота в AP+STA (домашний WiFi) — пока ещё на его точке и привязка к Wi-Fi жива.
        if (apOnlyActive && host.isNotEmpty()) {
            drive.control(host, "apmode", false)
            apOnlyActive = false
        }
        discovery.stop()
        WifiBinder.unbind(this)          // вернуть обычную маршрутизацию
        connected = false
        micOn = false
        binding.btnMic.text = getString(R.string.mic_on)
        binding.btnConnect.text = getString(R.string.connect)
        mjpeg.stop()
        mic.stop()
        telemetry.stop()
        wifiInfo = ""
        tofInfo = ""
        motorInfo = ""
        if (host.isNotEmpty()) drive.stopSending(host)
        setStatusPart("отключено")
    }

    private fun toggleMic() {
        if (!connected) {
            Toast.makeText(this, "Сначала подключитесь", Toast.LENGTH_SHORT).show()
            return
        }
        micOn = !micOn
        if (micOn) {
            mic.start(host)
            binding.btnMic.text = getString(R.string.mic_off)
        } else {
            mic.stop()
            binding.btnMic.text = getString(R.string.mic_on)
        }
    }

    /** Обновление приложения с ПК (дашборд раздаёт APK по LAN). */
    private fun askUpdateHost() {
        // ПК обязан быть в той же подсети, что плата/телефон. Прилипший адрес из
        // другой подсети (например 192.168.9.18 после переезда сети на 192.168.1.x)
        // бесполезен — подставляем текущую подсеть платы, пользователь дописывает хвост.
        val lastIp = prefs.getString("last_ip", "") ?: ""
        val subnet = lastIp.substringBeforeLast('.', "").let { if (it.isEmpty()) "" else "$it." }
        var preset = prefs.getString("upd_host", "") ?: ""
        if (preset.isEmpty() || (subnet.isNotEmpty() && !preset.startsWith(subnet))) {
            preset = subnet
        }
        val input = android.widget.EditText(this).apply {
            setText(preset)
            hint = "пусто = найти ПК автоматически"
            setSelection(text.length)
        }
        androidx.appcompat.app.AlertDialog.Builder(this)
            .setTitle(getString(R.string.update_host_title))
            .setMessage("Пусто = автопоиск ПК (mDNS). На ПК запусти дашборд:\npy -3 tools\\xiao_serial_telemetry.py\nСвежий APK кладётся в dist\\. Вручную: IP ПК (порт :8897 сам).")
            .setView(input)
            .setPositiveButton(getString(R.string.app_update)) { _, _ ->
                var h = input.text.toString().trim().removePrefix("http://").removeSuffix("/")
                if (h.isEmpty() || h.endsWith(".")) {
                    // Пусто/только подсеть — ищем ПК сами (дашборд анонсирует «xiao-dash»).
                    setStatusPart("ищу ПК с дашбордом (mDNS xiao-dash)…")
                    discovery.find(
                        timeoutMs = 6000L,
                        onFound = { ip, port ->
                            val hh = "$ip:${if (port > 0) port else 8897}"
                            prefs.edit().putString("upd_host", hh).apply()
                            updater.checkAndInstall(hh, lifecycleScope)
                        },
                        onFail = {
                            setStatusPart("ПК не найден: запусти дашборд (нужен pip install zeroconf) или впиши IP")
                        },
                        nameFilter = "xiao-dash",
                    )
                } else {
                    if (!h.contains(':')) h += ":8897"
                    prefs.edit().putString("upd_host", h).apply()
                    updater.checkAndInstall(h, lifecycleScope)
                }
            }
            .setNegativeButton(android.R.string.cancel, null)
            .show()
    }

    private fun sendStop() {
        // Кнопка «Стоп» обнуляет команды; цикл отправки остаётся жить
        // (шлёт stop=1 каждые 120 мс) — джойстик продолжает работать.
        drive.cmdL = 0
        drive.cmdR = 0
    }

    private fun showFrame(bmp: Bitmap) {
        binding.videoView.setImageBitmap(bmp)
    }

    private var statusLine = ""
    private fun setStatusPart(part: String) {
        statusLine = part
        updateStatusLine()
    }

    private fun updateStatusLine() {
        val parts = listOfNotNull(
            statusLine.takeIf { it.isNotEmpty() },
            wifiInfo.takeIf { it.isNotEmpty() },
            tofInfo.takeIf { it.isNotEmpty() },
            driveInfo.takeIf { it.isNotEmpty() },
            motorInfo.takeIf { it.isNotEmpty() },
        )
        runOnUiThread {
            binding.statusText.text = parts.joinToString(" · ")
        }
    }

    /** Дифференциальный привод: вперёд/назад + поворот; масштаб — слайдер «Мощность». */
    private fun tankMix(nx: Float, ny: Float, left: Boolean): Int {
        val max = joyPower
        val forward = (ny * max).roundToInt()
        val turn = (nx * max).roundToInt()
        val v = if (left) forward + turn else forward - turn
        return v.coerceIn(-255, 255)
    }

    override fun onDestroy() {
        disconnectAll()
        super.onDestroy()
    }
}
