soulhiler/Dengojui-Ardu/(commit log)

2026-05-15 Initial commit: XIAO Деньгожуй (cam stream, tools)
2026-05-16 Add drive stack, Android remote, tooling, and Cursor chat archive.
    Document TB6612/XIAO wiring in firmware; ship JSONL+ZIP transcripts from the It trane exp workspace for reproducibility.
2026-05-27 Add Arduino UNO motor test stack with web joystick panel.
2026-06-01 Add VL53L0X ToF, radar UI, and 360 motor-scan occupancy grid.
2026-06-10 Add XIAO 1.2.4 stack: ToF on GPIO8, OTA tools, wiring and Wi-Fi incident docs.
    Disable encoders in drive_config when not wired; HTTP OTA and recovery scripts read secrets from env/files instead of hardcoded passwords.
2026-06-10 port(dev->main): brain/ + CI + LICENSE + onboarding + safety docs
    Перенос ценного из ветки claude/dev в каноническую линию main (1.2.4).
    Чистые добавления — на main этих файлов не было:
    - brain/ (ИИ-мозг: robot/perception/safety/brain + 9 юнит-тестов) + docs/brain-api.md
    - .github/workflows/build.yml (CI: brain-тесты + сборка прошивки + APK);
    firmware-job дополнен установкой библиотеки VL53L0X (нужна для xiao_tof.h в 1.2.x)
    - LICENSE (MIT), docs/onboarding.md, .editorconfig
    - docs/security-history-cleanup.md (runbook чистки утёкшег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
2026-06-10 port(dev->main): merge xiao_drive.h — одометрия/рефлекс + аудио-хуки
    Слил две дивергентные эволюции одного файла:
    - из claude/dev: spd_l/spd_r (тики/с), антидребезг энкодеров
    (DRIVE_ENC_DEBOUNCE_US), рефлекс безопасности (бампер + УЗ-стоп,
    safety-битмаска перекрывает команды клиента), drive_safety/spd_* в
    телеметрии;
    - из main: аудио-хуки motor-audio (xiaoAudioIsActive() в driveApplyMotors,
    xiaoAudioStop() в xiaoDriveSetLr).
    Добавлены #ifndef-дефолты DRIVE_ENC_DEBOUNCE_US / DRIVE_US_STOP_CM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
2026-06-10 port(dev->main): доки безопасности питания + сведение линий в dev-log
    - README: раздел «Безопасность питания» (правила против петли земли,
    HTTP-OTA когда USB мёртв) + строки про перенесённые brain/, CI, dev-log,
    onboarding, security-history.
    - docs/dev-log.md: верхняя запись 2026-06-10 — сведение двух линий
    (Cursor main ← claude/dev), что перенесено и что нет, статус платы
    (исходная мертва = урок, работа на запасной), курс на одном XIAO.
    - docs/hardware/build_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
2026-06-11 fix(dashboard): джойстик крупнее со стрелками + прокси не режет параметр r
    1) Прокси /board/* вырезал кэш-бастер срезом split("&r=") — что совпадает
    с именем параметра ПРАВОГО колеса /drive?l=&r=. Запрос обрезался до
    l=..., прошивка дублировала команду левого колеса на оба — повороты
    не работали (вперёд/назад работали случайно, т.к. там l=r).
    Теперь параметры парсятся по именам (parse_qsl), вырезаются только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
    [xiao_serial_telemetry.py]
2026-06-11 fix(app): джойстик переставал работать после первого касания
    onRelease вызывал drive.stopSending() — это cancel() периодического
    driveJob, который запускается ОДИН раз в connectAll(). Итог: первое
    касание джойстика работало, после отпускания цикл отправки /drive
    умирал навсегда — «одно нажатие, потом зависает».
    Фикс: при отпускании только обнуляем cmdL/cmdR — живой цикл сам шлёт
    /drive?stop=1 каждые 120 мс (заодно правильно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
    [MainActivity.kt]
2026-06-11 feat(app+dashboard): самообновление приложения по LAN с ПК
    Приложение (Android):
    - Кнопка «Обновить» → диалог с адресом ПК (ip:порт, по умолчанию
    192.168.9.18:8897, хранится в prefs) → AppUpdater качает
    /app/version.json, сравнивает versionCode с установленным,
    скачивает /app/apk в кэш и запускает системный установщик
    (FileProvider + ACTION_VIEW).
    - REQUEST_INSTALL_PACKAGES + FileProvider (res/xml/file_paths.xml).
    - ФИКСИРОВАННАЯ ПОДПИСЬ: debug.keystore закоммичен в репо, debug и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
2026-06-11 ci(android): запуск gradle-wrapper через java -cp (gradlew нет в репо)
    Джоба android падала с exit 127: Unix-скрипт ./gradlew не закоммичен
    (проект всегда собирался на Windows через gradlew.bat). Вместо
    добавления скрипта зовём wrapper напрямую:
    java -cp gradle/wrapper/gradle-wrapper.jar org.gradle.wrapper.GradleWrapperMain
    — jar в репо есть, Gradle 8.9 скачается сам по wrapper.properties.
    Тот же приём использовался для локальной сборки APK в мае.
    if-no-files-found: warn -> error: отсутствие APK в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
2026-06-11 fix(app): убран дублированный импорт CoroutineScope в MjpegStream
    Kotlin 2.0.21 в CI падает с "Conflicting import: imported name
    CoroutineScope is ambiguous" (строки 5 и 10). Старый огрех, который
    никогда не проходил через CI-сборку.
2026-06-11 feat(dashboard+fw): регуляторы мощности и скважности пения + APK через release
    Как на UNO-стенде (uno_motor_web.py):
    - Панель: слайдер «Мощность» 40..255 (по умолчанию 180) — джойстик
    масштабирует команды L/R на это значение вместо жёстких 255;
    слайдер «Пение (скважность)» 10..100% (по умолчанию 10) — уходит
    параметром gain в /beep и /melody. Оба запоминаются в localStorage.
    - Прошивка: handleBeep/handleMelody принимают gain=10..100 и зовут
    xiaoAudioSetGa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
2026-06-11 docs+dist: dev-log за 2026-06-11 + готовый APK v2 в репо
    - docs/dev-log.md: полная запись сессии — оживление платы (COM6,
    Wi-Fi после ребута роутера, прошивка 1.2.4), критический фикс прокси
    /board/* (срез &r= резал параметр правого колеса — повороты не
    работали), фикс зависания джойстика в приложении (stopSending убивал
    driveJob), самообновление APK по LAN, фиксированный keystore,
    починка CI (gradlew → java -cp; квота артефактов → release
    apk-l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
2026-06-11 feat(tof): VL53L7CX вместо VL53L0X + порт фикса камеры SVGA q12 (fw 1.3.0)
    Новое железо: XIAO Sense с камерой + мультизонный VL53L7CX.
    - xiao_tof.h: библиотека ST (STM32duino VL53L7CX), 4x4/8x8, профили
    fast/bal/acc/long сохранены; tof_mm = минимум центральной полосы зон,
    телеметрия и /scan360 совместимы; новый GET /tof — полная сетка.
    - drive_config: XIAO_TOF_LPN_PIN / XIAO_TOF_I2C_RST_PIN (LPn держать HIGH).
    - Камера: SVGA q12 вместо QXGA q2 (порт a12c4e7 из dev — FB-OVF без кадров).
    - CI: lib install "STM32d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
2026-06-11 fix(fw): USB-CDC терял хвосты длинных строк телеметрии (txTimeout 0 -> 20 мс)
    Serial.setTxTimeoutMs(0) молча отбрасывал то, что не влезло в 256-байтный
    буфер CDC: строка телеметрии ~2 КБ приходила хосту рваной (склейки вида
    "fw_vership_cores"), дашборд не мог распарсить НИ ОДНОЙ JSON-строки
    (usb_lines_json=0 при 36 КБ принятых байт). С таймаутом 20 мс запись
    дожидается слива буфера; без подключённого хоста HWCDC по-прежнему
    отбрасывает с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
    [xiao_cam_stream.ino]
2026-06-11 fix(app): mDNS-автопоиск платы вместо прилипшего IP + инсеты edge-to-edge (v3)
    - BoardDiscovery (порт из dev): пусто/xiao-cam.local/auto -> NSD-поиск,
    фолбэк last_ip; видео не зависит от смены DHCP-адреса платы.
    - targetSdk 35 рисует под статусбаром/навигацией: insets-паддинг корня —
    поля и кнопки больше не накладываются.
    - versionCode 3; APK соберёт CI (release apk-latest).
    https://claude.ai/code/session_017ReVU3RfV6NPijQXLjHqVE
    [MainActivity.kt]
2026-06-12 feat(app): вкладки Робот/Телеметрия/Управление — телеметрия и контролы как в веб-дашборде (v4)
    - Телеметрия: сводка из 10 показателей + группы groupOf() из дашборда,
    полный JSON с платы (TelemetryPoller отдаёт весь объект).
    - Управление: тогглы /control (wifi/ble/cam/mic/drive) с синхронизацией
    из телеметрии, слайдеры мощности джойстика (40-255) и скважности
    пения (10-100%), звук Beep/Мелодия 1/Привет/Стоп — URL как в вебе.
    - Базо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
2026-06-12 fix(app): диалог обновления подставляет текущую подсеть вместо прилипшего адреса ПК (v5)
    Сеть переехала 192.168.9.x -> 192.168.1.x: плата находится по mDNS, а
    upd_host в prefs остался старый. Теперь при несовпадении подсети с last_ip
    платы диалог предзаполняется её подсетью, порт :8897 добавляется сам,
    в диалоге подсказка про дашборд и ipconfig.
    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
    [MainActivity.kt]
2026-06-12 build(app): имя APK с версией — xiao-robot-v<N>-debug.apk
    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
2026-06-12 fix(app): тумблер привода читает drive_enabled + диагноз моторов в статус-строке (v6)
    ctrl_drive в /telemetry не существует — optInt-дефолт показывал «выкл»
    всегда. Тумблеры обновляются только по реально пришедшим ключам; в статус
    выводится причина молчания моторов (выкл/рефлекс/watchdog).
    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
    [MainActivity.kt]
2026-06-12 feat(app): джойстик-оверлей поверх вкладки Телеметрия (v7)
    Для диагностики моторов: рулить и смотреть drive_cmd_l/r в группе
    «Привод» одновременно. Общий bindJoystick на оба джойстика.
    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
2026-06-12 feat(update): автообновление телефона — дашборд на 0.0.0.0 + mDNS xiao-dash + автопроверка в приложении (v8)
    Дашборд слушал только 127.0.0.1 — телефон не мог скачать APK вовсе.
    Теперь: бинд 0.0.0.0, mDNS-анонс xiao-dash (pip install zeroconf,
    опционально); приложение после подключения тихо ищет ПК и при новой
    версии в dist/ само предлагает установку; в диалоге пусто = автопоиск.
    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
2026-06-12 docs: хэндофф для Claude Code на ПК — обновления телефона и диагностика моторов
    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
2026-06-12 fix(fw): MJPEG в отдельную задачу на :82 — стрим больше не блокирует /drive (1.3.1)
    Корень «с приложения моторы не работают, в вебе ок»: handleStream гнал
    кадры в бесконечном while ВНУТРИ единственного потока WebServer. Пока
    телефон смотрел видео (приложение открывает /stream при подключении),
    плата не обрабатывала НИ ОДНОГО другого запроса: /drive, /beep, /telemetry
    молчали, watchdog привода не тикал. Веб-дашборд работал, пото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
    [xiao_cam_stream.ino]
2026-06-13 docs: веха 2026-06-13 — весь стек робота живой (камера+ToF+привод+мик+WiFi)
    Первая проверка на железе со всеми зелёными подсистемами: ToF VL53L7CX
    ожил (tof_ok=1, замеры ~776-810мм, сетка 4x4), камера /capture JPEG,
    привод работает во время видео (фикс :82 подтверждён), мик/WiFi OK.
2026-06-13 perf(app+fw): убрать лаги и зависания камеры+джойстика (fw 1.3.2, app v9)
    Симптом: «камера с джойстиком тормозят и зависают». Две причины.
    Приложение (MjpegStream.kt) — главная:
    - acc = acc + buffer.copyOfRange(...) пересоздавал весь буфер на КАЖДОЕ
    чтение (O(n²), GC-шторм) → подвисания. Заменено на компакт буфера
    на месте через System.arraycopy.
    - каждый декодированный кадр постился в Main-поток; при потоке быстрее
    отрисовки оч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
2026-06-13 fix(fw): краш под нагрузкой стрима — мьютекс камеры + стек задачи 16КБ (1.3.3)
    Симптом: при подключении телефона с видео плата «зависала почти сразу» —
    пинговалась (радио живо), но :80/:82 и USB-CDC мертвы (хард-хэнг).
    Причина (две, обе устранены):
    1. esp_camera_fb_get() не реентерабельна: задача стрима :82 и handleCapture
    (/capture) звали её одновременно → краш. Добавлен мьютекс gCamMutex
    (camFbGetLocked/camFbReturnLocked) — доступ к кам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
    [xiao_cam_stream.ino]
2026-06-13 docs+dist: dev-log стабильности видео+привод + APK v9 в репо
    - dev-log: разбор связки камера+джойстик на телефоне (3 части) —
    видео блокировало /drive (вынос в задачу :82 + 302), лаги/зависания
    приложения (переписан MjpegStream, троттл стрима), и краш под
    нагрузкой (мьютекс камеры + стек 16КБ, проверено стрессом на железе:
    175/175 /drive, uptime растёт, утечек нет). Итог: весь стек стабилен.
    - dist: устаревшие APK (v2/v8) заменены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
2026-06-13 docs(hardware): обзор линейки Orange Pi 2026 как Linux-компаньона
    Zero/мейнстрим/флагманы RK3588/спец-платы; вывод под наш робот —
    Zero 2W 4ГБ или Pi Zero 2 W (софт vs RAM).
    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
2026-06-13 docs(tof): глубокое исследование лучших практик VL53L7CX + аудит нашего кода
    5 граней (конфиг/I2C/данные/алгоритмы/драйверы), сверено с ST UM3038,
    исходниками stm32duino и реализациями сообщества. Ключевое для нас:
    target_order=CLOSEST для робота, I2C 1МГц срезает init вдвое, фильтр по
    sigma, геометрический отсев пола. Цитаты приложены.
    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
2026-06-13 docs(tof): раздел реального опыта (EN/CN/JP/KR) + усиление аудита
    Азиатские источники (CSDN/Qiita/корейские) + форумы: таблица времени init,
    фриз I2C на ребуте ESP32-S3 (→ LPn на GPIO как топ-приоритет), мина
    esp32-camera driver_ng, реальная дальность на свету ~30см-1.7м, stm32duino
    vs SparkFun на ESP32. Подтверждения нашему коду (медиана, status-гейт, кэпы частот).
    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
2026-06-13 docs(robot): конечные решения по ориентации и построению пространства
    Ориентация: BNO085 (фьюжн на чипе, без магнитометра) + энкодеры; на дифф-
    приводе доминирует ошибка курса. Пространство: forward-ToF → только
    локальный log-odds grid; для карты комнаты нужен 360° LiDAR (~$70 LD06/LD19)
    + 4ГБ SBC (Pi Zero 2W 512МБ не тянет slam_toolbox). Реальные сборки —
    наш стек уже есть (Ferrolho ESP32+VL53L5CX+BNO085, 3D-скан). Роадмап в 4 шага.
    https://claude.ai/code/ses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
2026-06-13 docs(robot): паттерн linorobot2 (эталон ESP32+SBC) + честный пробел по ToF-картам
    ESP32-S3 = micro-ROS узел (odom/imu/motors/lidar-passthrough), SBC = EKF+
    slam_toolbox+Nav2. Двойник железа — ESP32-S3+Orange Pi 5B. Мультизонный ToF
    для навигационной карты в готовых сборках не доказан — нужен 360° LiDAR
    (вход ~$15 Xiaomi LDS02RR).
    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
2026-06-14 docs(hardware): ландшафт лидаров 2026 — лестница апгрейда над 2D + ToF/FMCW контекст
    Конспект внешнего обзора: ступени над нашим LD06/LD19 (Unitree L2 3D ~$395,
    Livox Mid-360 ~$899 = стандарт робототехники, FAST-LIO из коробки),
    ликбез ToF vs FMCW, расклад индустрии. Связано с orientation-and-mapping.
    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
2026-06-14 feat(dashboard): 3D-вид глубины VL53L7CX вместо лучевого радара
    Радар показывал один tof_mm как луч. Теперь — живая 3D-картина того,
    что видит матрица сенсора: сетка зон (/board/tof) рендерится как
    поверхность глубины в 3D (ручная canvas-проекция, без внешних
    библиотек — офлайн).
    - каждая зона = точка по (азимут, угол места, дистанция) в FoV ~64°/ось;
    - меш-квадраты между зонами + точки, цвет = дистанция (ближе красны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
2026-06-14 fix(tof): LPn на GPIO7 (D8) + аппаратный recovery I2C + target_order CLOSEST (1.3.4)
    По аудиту vl53l7cx-best-practices.md (ветка sbc-research-and-tof):
    - XIAO_TOF_LPN_PIN -1 -> 7 (D8). LPn выведен с перемычки 3.3V на GPIO —
    теперь возможен аппаратный сброс сенсора.
    - xiaoTofInit: пульс LPn LOW->HIGH перед begin() — лечит зависание I2C
    (SDA stuck) при ребуте только MCU без обесточивания сенсора. Это
    главный фикс «связь поломалась» из аудита; питание/прошивка сенсора
    в RAM сохр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
    [drive_config.h, xiao_cam_stream.ino, xiao_tof.h]
2026-06-14 feat(tof): фильтр зон по range_sigma_mm — убирает ложные близкие (1.3.5)
    По аудиту: брали только target_status, теперь добавлен порог шума.
    range_sigma_mm (ULD делит на 128 → мм): высокая sigma = ненадёжный/
    дрожащий замер. Зона с sigma > XIAO_TOF_SIGMA_MAX_MM (дефолт 15 мм)
    отбрасывается (grid=-1, не участвует в tof_mm). Критично, т.к.
    tof_mm = минимум по центру → одиночный шумный выброс вниз давал
    ложный стоп. Порог тюнится в drive_config.h; 0 = фильтр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
2026-06-14 feat(tof): обнаружение пола/обрыва по обучаемому эталону + 3D-подсветка (1.3.6)
    Последний пункт аудита. Калибровка на ровном полу (GET /floorcal) снимает
    эталон дистанций по зонам; дальше зона, потерявшая отражение или ушедшая
    намного дальше эталона = обрыв (cls=1), намного ближе = бугор (cls=2).
    Подход без знания высоты/угла монтажа — практично для несобранного робота:
    зоны, не видевшие пол при калибров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
2026-06-14 docs(dev-log): вехи ToF за 2026-06-14 (3D-вид + исследование + аудит 1.3.4-1.3.6)
    Сведены в журнал: исследование VL53L7CX (4 дока, PR #3), 3D-вид глубины
    вместо радара (PR #4), и весь аудит сенсора — LPn/recovery+CLOSEST (1.3.4,
    PR #5), sigma-фильтр (1.3.5, PR #6), cliff/floor detection (1.3.6, PR #7).
    Плюс состояние железа (LPn на D8, дашборд на чистом Wi-Fi) и что открыто.
2026-06-14 docs(robot): камера+ToF → модель пространства, хранение на сервере, переиспользование (#9)
    Конвейер по уровням: моно-глубина(Depth Anything)+ToF-масштаб(аффинный МНК) →
    цветное облако(Open3D) → RTAB-Map (.db SQLite, localization mode, мульти-сессия)
    на сервере → робот переоткрывает. Профильный paper под наш сетап (VL53L5CX+
    Depth Anything, AbsRel~0.14). TSDF: voxblox(CPU)/nvblox(Jetson). Честно: модель
    = SBC/сервер, XIAO — источник; готового DIY ToF-навиг-робота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
2026-06-14 feat(spatial): MVP-этап 1 — камера+ToF → цветное облако точек (PLY) (#10)
    XIAO = источник (/capture + /tof), сервер = строит модель. 8x8 ToF-зоны →
    3D с покраской пикселем камеры, накопление с воксель-прорежением, запись PLY.
    Живой/офлайн/synth режимы; turntable-поза (yaw-step). Без ML — фундамент под
    этап 2 (моно-глубина Depth Anything + ToF-масштаб) и этап 3 (RTAB-Map .db).
    Проверено synth end-to-end (64 точки/кадр, цвет из камеры, офлайн-пересборка).
    https:/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
2026-06-14 fix(spatial): убрать символ -> из консольного вывода (краш на cp1251 Windows)
    build_model.py падал с UnicodeEncodeError в финальном print и argparse
    description: символ U+2192 (стрелка) не кодируется в cp1251-консоли Windows.
    Облако строилось и PLY писался корректно, но скрипт возвращал exit 1 и
    выглядел сломанным. Заменил стрелку на ASCII "->".
    Проверено: synth-тест (--synth --frames 4) теперь exit=0, PLY 256 точек.
2026-06-14 feat(dashboard): 3D-визуализатор накопленного облака точек (камера+ToF)
    В телеметрию добавлена карточка «Облако точек» — строит и показывает
    3D-модель из кадров камеры+ToF (этап 1, переиспользует модуль spatial/).
    Сервер (xiao_serial_telemetry.py):
    - импорт spatial/ (tof_cloud, build_model.add_frame, xiao_client.fetch_frame),
    накопитель PointCloud (воксель 3см) под локом;
    - эндпоинты /cloud/capture?yaw= (забор /capture+/tof с платы → цветные
    3D-точки → накоплени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
2026-06-14 feat(spatial): автономная персистентная модель пространства (сама строит/копит/хранит)
    По уточнённой задаче: система сама строит, сохраняет и переиспользует модель
    пространства из камеры+ToF+телеметрии. Всё пришедшее копится, уточняется,
    сохраняется и доступно для ориентации.
    Новое:
    - spatial/world_model.py — WorldModel: воксель-карта (занятость log-odds +
    цвет бегущим средним + счётчик), уверенность растё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
2026-06-14 feat(dashboard): доработка представления модели — уверенность, пол, робот, вид сверху
    Модель пространства в телеметрии стала читаемой и пригодной для ориентации:
    - 3D: сетка пола (опорная плоскость) + маркер робота с направлением в начале
    координат — пространство читается как сцена; точки затенены по уверенности
    (log-odds): увереннее = ярче и крупнее, неуверенные — бледные.
    - Новый вид сверху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
2026-06-15 feat(imu): MPU6050 курс для ориентации (fw 1.4.0) (#16)
    * feat(imu): MPU6050 (GY-521) — курс для ориентации (fw 1.4.0)
    xiao_imu.h: чтение MPU6050 прямым Wire (без внешней либы — CI собирает),
    комплементарный фильтр на плате → imu_yaw/pitch/roll + imu_gz/temp в /telemetry;
    авто-калибровка нуля гиро на старте; /control?imuzero=1 сброс курса. Делит I2C
    с ToF (0x68 vs 0x29), 0 новых пинов. PoseEstimator: курс из imu_yaw приоритетно,
    энкодеры — дистанция (и курс-fallback без IMU). Схема по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
2026-06-15 feat(spatial): этап 2 (плотная глубина) + этап 3 (Wi-Fi-якорь) (#17)
    энкодеры — дистанция (и курс-fallback бе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
2026-06-15 docs: метод ориентации/локализации по Wi-Fi (RSSI/FTM/CSI) (#15)
    * docs(wifi): метод ориентации/локализации по Wi-Fi для робота
    Исследование RSSI/FTM/CSI на ESP32-S3. Главное: Wi-Fi даёт позицию, не курс
    (одна антенна → AoA невозможна). Предложен метод без покупок: само-строящийся
    RSSI-отпечаток в координатах world_model → сброс дрейфа одометрии/IMU. Курс —
    IMU+энкодеры. Апгрейд — ESP32-S3 FTM-маяки (~2 м). CSI-AoA — тупик на 1 антенне.
    https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
2026-06-16 docs(hardware): нарисованная схема подключения IMU MPU6050 (GY-521)
    По запросу «дай схему подключения инерционника». На main IMU уже на MPU6050
    (GY-521, PR #16), но схема была только таблицей — добавил нормальный рендер.
    - build_mpu6050_wiring.py (schemdraw, стиль KiCad) + wiring-xiao-mpu6050-gy521.{pdf,png,svg}:
    MPU6050 на ОБЩЕЙ шине I2C с ToF VL53L7CX (SDA=D9/GPIO8, SCL=D10/GPIO9).
    VCC→3V3, GND→GND, AD0→GND (адрес 0x68), XDA/XCL/INT — не подключать.
    Адреса 0x68 (IMU) и 0x29 (ToF) не конфликтуют.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
2026-06-16 feat(spatial): калибровка позиционирования + инструмент проверки конвейера
    Проверил/откалибровал/доработал систему позиционирования и построения карты.
    КАЛИБРОВКА ЗНАКА КУРСА (главное):
    - Замер calibrate_live.py показал: поворот ПО ЧАСОВОЙ даёт imu_gz<0 и убывание
    imu_yaw, а apply_pose (world_az = robot_az + yaw) требует по часовой +yaw.
    Знак был инвертирован — при повороте карта «складывалась» зеркально.
    - Введён IMU_Y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
2026-06-16 docs(dev-log): веха 2026-06-16 — IMU MPU6050 на железе + калибровка позиционирования
    Запись о подключении/калибровке инерционника: прошивка MPU6050 (PR #16),
    развилка BNO085→GY-521 (PR #19 закрыт, схема PR #20), калибровка знака курса
    и доработки позы/карты (PR #21), инструмент spatial/calibrate_live.py.
2026-06-16 feat(spatial): релокализация курса по карте — карта используется для ориентации
    Следующий шаг цели «модель пространства используется для ориентации»: накопленная
    карта теперь де-дрейфит курс гироскопа (MPU6050 6-осевой без магнитометра дрейфует).
    Механизм (relocalize_yaw, world_service.py):
    - Поза робота ~1-DOF (turntable: только курс) -> релокализация = перебор поправки
    курса δ в окне ±25°, максимизирующий совпа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
2026-06-16 docs(dev-log): релокализация курса по карте (PR #23)
    Подраздел в вехе 2026-06-16: карта используется для ориентации — де-дрейф курса
    гироскопа сопоставлением ToF-скана с накопленной картой (relocalize_yaw).
2026-06-16 feat(tools): spin_scan.py — автономный turntable-скан (робот строит панораму)
    Робот сам крутится на месте импульсами (энкодеров нет → только вращение, IMU
    ведёт курс; поступательно не едем — карта бы поехала), копит ToF-панораму и
    релокализует курс по карте. Проверено на железе: 247 вокселей / 45 уверенных,
    релокализация сработала (поправка курса −0.8°). IMU не виснет от моторов.
    - импульсный turntable (повернул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
2026-06-16 feat(spatial): релокализация — likelihood-field + coarse-to-fine (точность 1°→0.03°)
    По исследованию методов scan matching (Olson 2009 correlative scan matching;
    Thrun, Probabilistic Robotics — likelihood field). Старый матч был грубый
    (жёсткий ±1 воксель, шаг 1°) — давал размытый пик на плоских стенах и точность ~1°.
    - WorldModel.likelihood_score: гладкое поле occ_logodds·exp(-d²/2σ²) вместо
    «попал/не попал» — шире бассейн сходимости, суб-вокс. точность, учитывает ВСЕ
    на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
2026-06-16 fw(1.4.1): надёжность IMU (авто-реинит + ZUPT-bias) + ToF 8×8 для карты (sharpener)
    По исследованию оптимизации позиционирования/карты. СКОМПИЛИРОВАНО (arduino-cli,
    39% флэша), но ЕЩЁ НЕ зашито/не проверено на железе (плата на батарее, USB+батарея
    нельзя) — флешить и проверить следующим заходом на USB.
    IMU (xiao_imu.h) — устраняет инцидент прошлой сессии (глитч батарейки подвесил
    MPU6050, imu_ok оставался 1 при мёртвых нулях,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
2026-06-16 docs: глубокий анализ сессии + исследование оптимизации позиционирования/карты
    docs/hardware/positioning-optimization.md — разбор автономного скана (данные двух
    прогонов, узкие места), исследование методов (VL53L7CX 8×8/sharpener; correlative
    scan matching Olson + likelihood field Thrun; MPU6050 ZUPT) с источниками, что
    сделано (PR #25/#26/#27) и следующие рычаги. Веха в dev-log.
2026-06-16 docs: прошивка 1.4.1 зашита и проверена на железе (8×8, честный imu_ok)
    Обновил статус 1.4.1 с «hardware-тест ⏳» на «проверено»: flashed на COM7, imu_ok
    честный (imu_temp живой 31°), 8×8 через /control?tofprofile=accurate работает
    (res=8, 64 зоны, ~2.5× валидных точек против 4×4).
2026-06-16 chore(gitignore): игнорировать временные дампы карты spatial/_*.json
    _map_dump.json и подобные временные выгрузки модели (для виджетов/отладки) —
    регенерируются, в репо не нужны.
2026-06-16 chore: дефолтная модель сессий — Opus 4.8 (#18)
    Закрепляет модель для сессий Claude Code на вебе через .claude/settings.json
    (читается на старте сессии). Раньше дефолт был Fable 5; при его недоступности
    приходилось вручную переключать модель каждое сообщение — выбор в пикере не
    держался на resume. Теперь новые сессии стартуют на Opus 4.8.
    .gitignore: разрешён общий .claude/settings.json, личный settings.local.json
    по-прежнему игнорируетс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
2026-06-16 docs(hardware): ревизия раздела анализа железа из PR #1 (#31)
    Перенос исследований раздела «Анализ железа» в main с приведением к актуальному
    состоянию проекта (а не дословным мёрджем устаревшего PR #1):
    - pinout-wiring-2026.md ПЕРЕПИСАН под реальную раскладку: I²C на D9/D10 (не
    дефолтные D4/D5 — у ESP32-S3 GPIO-матрица), ToF (0x29) + MPU6050 (0x68) на
    общей шине, LPn на D8, энкодеры не установлены (D6/D7 свободны). Прежний вывод
    «свобо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
2026-06-16 feat(positioning): уверенность зон ToF (sigma) → взвешенное накопление карты (fw 1.4.2) (#32)
    Рычаг из docs/hardware/positioning-optimization.md: per-zone sigma больше не
    выбрасывается на плате, а доходит до сервера и взвешивает накопление карты.
    Прошивка (fw 1.4.2, build 25):
    - GET /tof отдаёт массив sigma — per-zone range_sigma_mm валидной зоны (мм,
    -1 = нет/неизв.). Прошивка уже фильтровала зоны по target_status (5/9) и
    sigma-порогу (15 мм); теперь сама величина sigma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
2026-06-17 feat(scan): серверный ZUPT + дашборд --world-paused; 8x8 на батарее (732 вокс)
    Проверка 8x8-скана с ездой на батарее. Результат vs 4x4: 247->732 вокселей,
    45->248 уверенных, релокализаций 1->9 (сошлась). Курс чистый, полный оборот.
    Вскрылись и закрыты две проблемы:
    - ДРЕЙФ нуля гиро ~8 deg/s после авто-реинита (глитч USB/батарея дёргает MPU6050;
    1.4.1 поднимает сенсор, но не пере-калибрует bias, ZUPT-трекер окном 0.8 слишком
    узкий). Ф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
2026-06-17 feat(spatial): Этап A — плотная геометрия из ВИДЕО (моно-глубина x ToF)
    Видео начинает нести ГЕОМЕТРИЮ, а не только цвет: каждый кадр -> тысячи цветных
    метрических МИРОВЫХ точек вместо 64 ToF-зон.
    - depth_fusion.py: intrinsics_from_fov (камера из FoV, OV2640 ~65) +
    frame_to_dense_world (RGB+ToF+поза -> плотные (x,y,z,rgb,w) в мире): моно-сеть
    даёт относит. глубину, 64 ToF-зоны задают метрику (fit_scale_shift), цвет из
    кадра, поза переносит в мир; вес w<1 (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
2026-06-17 fix(spatial): реальная Depth Anything V2 заработала (transformers 5.x)
    Запустил настоящую моно-глубину на живых кадрах: sparse ~41 -> dense ~8000
    точек/кадр (x190), форма глубины настоящая (передний план ближе, мебель дальше).
    - DepthAnythingBackend: use_fast=False (у модели нет fast image-processor в
    transformers 5.x -> иначе OSError на preprocessor) + HF_HUB_DISABLE_XET=1
    (xet-загрузка ломала fetch конфигов).
    - README: заметка про HF_HUB_OFFLINE=1 при флапающей сети (прогреть кэш -> грузи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
2026-06-17 feat(scan): --dense — плотная панорама из видео (Depth Anything на каждом шаге)
    spin_scan.py --dense: на каждом шаге turntable вместо 64 ToF-точек вливаем
    ~8000 плотных (Depth Anything V2 x ToF-масштаб). Курс/ZUPT/релокализация — как есть.
    Проверено на железе (49 шагов, 150с): вокселей 732 -> 16552 (x22), уверенных
    248 -> 8621 (x35), карта ~5x5 м комнаты с реальными цветами. CPU-инференс
    ~2-3с/шаг (робот стоит во время счёта). Без флага — обычный разрежённы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
2026-06-19 feat(spatial): Этап B.1 — RGB-D визуальная одометрия (ядро относительной позы)
    Поза кадр->кадр для будущего движения по комнате. У нас уже есть метрическая
    глубина (Depth Anything x ToF), поэтому делаем RGB-D одометрию без моно-масштабной
    неоднозначности.
    spatial/vo.py:
    - umeyama + umeyama_ransac: жёсткое 3D-3D выравнивание (Кабш/SVD) с RANSAC.
    - estimate_translation_ransac + R_yaw: ТРАНСЛЯЦИЯ при известном повороте R.
    Ключевой приём для нашей си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
2026-06-19 feat(B.2): карта мира НА ХОДУ — VO + IMU + плотная глубина при движении
    Робот едет вперёд короткими шагами; на каждом кадре VO даёт СДВИГ (поворот из
    IMU), поза 6-DOF растёт, плотная глубина вливается в мир. Карта строится при
    ДВИЖЕНИИ, а не только поворотом на месте.
    tools/vo_drive.py: drive-loop. На шаге: метрическая глубина (Depth Anything x ToF)
    -> VO относительная поза (relative_pose_rgbd, R из IMU) -> поза@=T_rel -> вливание
    плотных то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
2026-06-19 docs(dev-log): веха 2026-06-17 — видео несёт геометрию (Этапы A и B)
    Плотная глубина из видео (Depth Anything x ToF, x200 точек) + плотная панорама
    (16552 вокс) + движение (VO+IMU, робот едет и картирует на ходу). PR #35-#39.
2026-06-19 fix(B.2): едем В СТОРОНУ сенсоров (камера/ToF смотрят против моторного «+»)
    Нюанс железа: drive(+,+) едет НАЗАД относительно камеры/ToF — робот ехал в
    несенсируемую сторону (ToF-стоп защищал не то направление, картировали назад).
    VO сам по себе верен (кадр камеры), сломана была только связка команда<->физ.
    направление.
    - DRIVE_FWD_SIGN=-1: едем туда, куда смотрят сенсоры -> ToF защищает путь,
    картируем впереди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
    [vo_drive.py]
2026-06-20 feat(tools): heading-hold — управляемая езда по курсу IMU (P-регулятор)
    Робота уводит вбок (дисбаланс моторов). heading_drive.py: ошибка курса (IMU) ->
    дифференциал моторов, знак авто-калибруется (мягко на месте). Едет вперёд = в
    сторону сенсоров (DRIVE_FWD_SIGN), с ToF-стопом. Режим --turn: поворот на месте.
    Компенсация мёртвой зоны (MIN_MOVE) — на малой ошибке диф падает ниже стикшна;
    допуск TOL_DEG против чаттера. Калибровка В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
2026-06-20 feat(heading): импульсный контроль курса (читаем на стоянке) + cal=+1
    Под мотором плата не отвечает (просадка питания/WiFi) — поэтому контур ИМПУЛЬСНЫЙ:
    курс читаем НА СТОЯНКЕ между импульсами, затем короткий импульс привода. Как
    turntable-скан. Знак руления cal=+1 известен из прошлых калибровок -> спин-
    калибровку (она садила плату) пропускаем (--autocal чтобы перемерить, --cal N
    задать). Длительность импульс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
2026-06-20 feat(spatial): B.3 ядро — замыкание петель (2D pose-graph SLAM, SE(2))
    Длинные проезды копят дрейф (VO+IMU). Когда робот возвращается в виденное место
    (детект совпадения), ребро-замыкание + оптимизация РАСПРЕДЕЛЯЕТ ошибку по всей
    траектории -> глобально согласованная карта.
    spatial/pose_graph.py: SE(2) граф поз + Gauss-Newton (Grisetti tutorial), чистый
    numpy без g2o/gtsam. Узлы=позы кадров, рёбра=относительные (одометрия из VO +
    замыкания пе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
2026-06-22 feat(B.3): живой loop-SLAM — проезд-петля + детект замыкания + согласованная карта
    tools/loop_slam.py: робот едет ТУДА-ОБРАТНО (вперёд N + назад N -> возврат в старт);
    на каждом кадре плотная глубина (Depth Anything x ToF) + VO-поза. Офлайн после:
    граф поз (одометрия) -> ДЕТЕКТ ПЕТЛИ (последние кадры матчатся с первыми, ORB+VO)
    -> pose_graph оптимизация -> пере-вливание плотной карты в исправленных позах.
    Проверено на железе (rssi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
    [loop_slam.py]
2026-06-22 tune(B.3): мельче импульс проезда (0.32->0.16с) для надёжности VO
    VO срывался на длинном проезде (10 инлайеров) — импульс 0.32с давал большой
    поворот/смаз между кадрами (дисбаланс моторов) -> мало перекрытия -> мало
    совпадений ORB. Мельче шаг (0.16с) = больше перекрытие = надёжнее VO. Пороги
    терпимее: MIN_INLIERS 25->16, LOOP_MIN_INLIERS 40->30.
    Для длинного проезда нужен длинный свободный коридор по курсу камеры (робот
    упи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
2026-06-22 docs(hardware): схема развязки питания — звезда по земле + bulk/декаплинг конденсаторы
    Снимает главный блокер живых проездов: броски тока моторов роняют WiFi/IMU/MCU
    (петля земли + просадка питания). Документ-схема: звезда по земле (все GND в одну
    точку у батареи, моторная земля отдельным толстым проводом), bulk 1000мкФ на VM
    TB6612, 470мкФ+0.1мкФ на рейле логики, 10мкФ+0.1мкФ у MPU6050, декаплинг на VCC
    драйвера и клем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
2026-06-22 docs(dev-log): развязка питания проверена на железе — блокер закрыт
    Под нагрузкой моторов телеметрия 14/14, imu_ok=1 без сбоев, wifi_rssi -50..-61
    без обвала (до развязки под мотором 0-1 чтение, WiFi/IMU отваливались).
2026-06-22 fix(loop_slam): utf-8 stdout (Windows cp1251 падал на '→') + живые тесты B.3
    После развязки питания прогнаны живые тесты без выпадений платы:
    поворот на месте (ошибка ~2°), проезд с удержанием курса (~3°, ToF-стоп),
    loop-SLAM туда-обратно (7 кадров, замыкание 300+ инлайеров, карта сохранена).
    Фикс: loop_slam.py принудительно пишет stdout в utf-8 — иначе финальный отчёт
    с '→' падал на Windows-консоли уже ПОСЛЕ оптимизации (карта не сох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
    [loop_slam.py]
2026-06-22 feat(loop_slam): heading-hold на плечах проезда — петля замыкается физически
    Оба плеча (туда/обратно) держат стартовый курс по IMU (P-регулятор, дифпривод;
    ω∝−2s ⇒ один знак CAL для обоих ходов). Робот едет прямо и ровно реверсит, возвращаясь
    к старту. Прогон --fwd 5: возврат в старт 0.28→0.02 м, курс ±12° вместо ухода на −22°,
    замыкание 0↔10: 372 инлайера, карта 4537 вокселей/1491 уверенный.
    Вердикт замыкания сдела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
2026-06-22 feat(loop_slam): контурный проезд (квадрат) — наглядный сброс дрейфа петлёй
    Режим --sides K: едем сторону (heading-hold) -> поворот на месте 360/K° -> ...
    После K сторон робот у старта курсом в исходную сторону (сильное замыкание); по
    периметру копится VO-дрейф, который оптимизация распределяет. На повороте VO не
    гоняем (сдвига нет -> относительная поза = чистый поворот из IMU, t=0; иначе ORB не
    сматчит 90°-скачок). --sid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
2026-06-22 feat(world_model): карвинг свободного пространства + miss-счётчик + денойз
    Фундамент для различения статика/динамика и чистого контура (мебель в комнате):
    - integrate_ray(origin, point): луч камеры decrement-ит свободные ячейки (miss++,
    logodds-=L_MISS) и усиливает попадание -> уехавший объект 'забывается' (сквозь его
    место виден дальний фон), стена/мебель выживают (видны занятыми чаще, L_MISS<L_HIT).
    - воксель расширен полем miss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
2026-06-22 feat(scene_analysis): Этап 1 — контур помещения из воксельной карты
    Новый модуль разбора сцены на слои (контур / объекты-мебель / динамика):
    - clean(): гейт выбросов глубины + денойз спекла (старые карты — постфактум).
    - floor_cells(): проекция на пол XZ с агрегацией logodds/hits/miss/цвет/высота
    (задел под объекты и динамику).
    - room_contour(): силуэт радиальным обходом (дальняя занятая ячейка в секторе =
    стена; мебель-ок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
2026-06-22 feat(scene_analysis): Этап 2 — сегментация объектов/мебели внутри контура
    - contour_radii(): радиальный профиль вынесен отдельно (переиспользуется контуром
    и классификацией стена/нутро).
    - object_clusters(): внутренние ячейки (r < contour - margin, т.е. не у стены) →
    связные компоненты (8-соседство) → объекты со статистикой: центр, габарит, площадь
    следа, высота (ymin..ymax), цвет, hits/miss (dyn_ratio для Этапа 3), класс
    (мебель/кр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
2026-06-22 feat(scene_analysis): Этап 3 — статика vs динамика (дифф проходов)
    - diff_maps(A,B): дифф двух релокализованных проходов — занято в A/пусто в B = объект
    УШЁЛ; пусто в A/занято в B = ПРИШЁЛ; занято в обоих = статика (стены/мебель). Кластеры
    изменившихся ячеек = движущиеся объекты. Надёжно, не зависит от карвинга.
    - label_dynamics(): одно-карточная разметка по miss-подписи (dyn_ratio) — для новых
    проездов с карвингом луча.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
2026-06-22 feat(pipeline): вживить карвинг луча в живые драйверы (Этап 3 онлайн)
    Точки теперь льются через integrate_frame_rays(origin, pts), origin = позиция камеры
    из позы (pose.tx/ty/tz). Свободное пространство чистится, накапливается miss-подпись →
    одно-карточная динамика (scene_analysis.label_dynamics) и чистка стен на ходу.
    Затронуты: loop_slam (+ флаг --nocarve), vo_drive, dense_fuse, spin_scan.
    Проверено драйвер-паттерном: частично выкарвленный объект dyn_ratio=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
2026-06-22 feat(loop_slam): счисление по IMU при потере VO — большой обход не рвётся
    VO теряется на бедных текстурой стенах и обрывал длинный проезд. Теперь при потере VO
    (на плече) шаг СЧИСЛЯЕТСЯ: поворот из IMU + средний шаг est_step (бегущая оценка из
    успешных VO-шагов) в направлении движения. Рёбра-счисления в графе поз идут с пониженным
    весом (info x0.3) -> замыкание петли их выправляет. dr_sign=±1 для вперёд/назад.
    Та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
2026-06-22 feat(scene_analysis): робастный поиск стен (перцентиль) + спрямление RDP
    Робот почти не доезжает до стен — границы снимаются по дальней глубине, где бывают
    одиночные выбросы. Оптимизация поиска стен:
    - contour_radii: радиус стены = перцентиль(88%) радиусов в секторе, а не абсолютный
    максимум. Отбрасывает дальние выбросы глубины, но СОХРАНЯЕТ разреженные дальние стены
    (плотный density-фильтр их убивал: п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
2026-06-24 feat(fw): токен-авторизация API + прямая SoftAP + онбординг Wi-Fi (fw 1.5.0)
    Связь, шаг 1 + цель 1 (новый xiao_net.h):
    - Токен-авторизация на /drive /control /scan360 /beep /melody (XIAO_API_TOKEN из
    secrets.h; ?token= или X-Auth-Token; пусто=выкл для LAN). Сравнение почти-пост. времени.
    - SoftAP: режим WIFI_AP_STA, своя точка XIAO-Robot @ 192.168.4.1 (прямая связь
    робот<->телефон без роутера) + одновременно домашний Wi-Fi. HTTP-сервер поднимается
    ВСЕГДА (раньше при отсутств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
2026-06-24 docs(dev-log): связь fw 1.5.0 проверена на железе (SoftAP/онбординг/управление)
    Прошито по USB (батарея отключена): STA работает (192.168.1.112), wifi_mode=apsta
    (SoftAP активен), /wifi отдаёт форму онбординга, /drive отвечает (токен пуст=auth off).
2026-06-24 feat(app): прямое подключение к SoftAP + токен API из приложения
    Подключение к роботу из приложения (цель 1):
    - Кнопка 'AP' в строке подключения -> прямой коннект к 192.168.4.1 (телефон в сети
    XIAO-Robot), без ввода IP и без браузера.
    - Долгое нажатие 'Подключить' -> диалог токена API (prefs).
    - DriveClient шлёт токен заголовком X-Auth-Token на /drive /control /beep /melody
    (пусто = не шлёт). Готово к включению авторизации (цель 2).
    Сборка APK зд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
2026-06-24 docs(dev-log): APK собирается в GitHub Actions (job android, JDK17) -> apk-latest
    Поправка: APK не нужно собирать локально/в Android Studio — CI (build.yml) собирает
    его на JDK 17 и публикует в rolling-release apk-latest. Прогон на merge PR #61: android ok.
2026-06-24 fix(app): привязка к Wi-Fi (bindProcessToNetwork) — SoftAP работает с моб. данными
    При 'Wi-Fi без интернета' (SoftAP робота) Android уводил запросы приложения в мобильные
    данные -> 192.168.4.1 недостижим (failed to connect from /10.x.x.x). WifiBinder при
    подключении привязывает трафик процесса к Wi-Fi (bindToWifi в connectSoftAp/connectAll,
    unbind в disconnectAll) -> все сокеты (HTTP, MJPEG :82, mic :81) идут по Wi-Fi.
    Проверено: с выключенными моб. данными SoftAP уже работал (видео/тел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
    [MainActivity.kt]
2026-06-24 fix(fw): звук моторов знакопеременным током — поют, а не крутятся (fw 1.5.1)
    Моторы на /beep /melody вращались вместо пения даже на минимуме: однонаправленный
    PWM-тон (IN1=H,IN2=L + скважность в одну сторону) давал постоянную составляющую ->
    крутящий момент. Теперь 4-квадрантный драйв: за период тона вперёд-драйв -> тормоз ->
    назад-драйв -> тормоз (симметрично, драйв = gAudioPct% полупериода). Среднее тока ~0 ->
    мот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
    [xiao_cam_stream.ino, xiao_motor_audio.h]
2026-06-24 fix(fw): звук моторов через аппаратный LEDC (тон, а не вращение) — fw 1.5.2
    Корень: тон делался программным бит-бэнгом PWM-пина в loop(). На XIAO цикл медленный
    (камера/WiFi/ToF) — не успевает на звуковых частотах -> чистого тона нет, только
    постоянная составляющая -> мотор крутится. Двунаправленная правка (PR #64) не помогла
    (тот же бит-бэнг) + pinMode/digitalWrite по PWM-пину отрывал LEDC -> пропадал звук на
    джойстике (регр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
    [xiao_cam_stream.ino, xiao_motor_audio.h]
2026-06-24 docs(dev-log): звук моторов (LEDC) проверен на железе — поёт на месте
2026-06-26 feat: режим «только точка» (AP-only) — быстрее прямое подключение к SoftAP (fw 1.5.3)
    Прямой коннект к SoftAP лагал: ESP32 одно радио, в AP+STA делит эфир между точкой и
    домашним WiFi. /control?apmode=1 отпускает STA (WiFi.disconnect, точку не выключаем ->
    телефон не отваливается), gApOnly не даёт wifiMaintainSta тащить STA назад -> всё радио
    SoftAP. apmode=0 возвращает AP+STA. Поле ap_only в ответе /control.
    Приложение: кнопка AP шлёт apmode=1 (прямое=быстро), обы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
2026-06-26 chore(app): versionCode 9->10 (AP/токен/wifi-bind/apmode + LEDC-звук)
    Накопились правки приложения (кнопка AP, токен, привязка к Wi-Fi, авто apmode) без бампа
    версии — APK оставался v9, кнопка «Обновить» не видела новее. Поднимаю до v10.
2026-06-26 feat(app): самообновление по сети из GitHub-релиза apk-latest (v11)
    Раньше «Обновить» тянул APK только с ПК-дашборда (вручную класть в dist/). Репо публичный,
    CI кладёт APK в релиз apk-latest (скачивается без токена). AppUpdater.checkGithubAndInstall:
    GitHub API -> версия из имени ассета (v\d+) -> сравнение с versionCode -> скачивание ->
    системный установщик (FileProvider, UA + редиректы). Кнопка «Обновить» = GitHub (по сети,
    без ПК); долгое нажатие = запасн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
2026-06-26 feat(ota): прошивка по Wi-Fi (HTTP-OTA) — одна команда; проверено 1.5.3->1.5.4 по воздуху
    OTA уже был включён в secrets.h (XIAO_OTA_ENABLE=1) — прошивка умеет POST /update + ArduinoOTA.
    Демонстрация: робот обновлён 1.5.3->1.5.4 полностью по WiFi (без USB). arduino-cli --upload-field
    в нашей версии не работает -> рабочий путь HTTP-OTA. tools/xiao_http_ota.py доведён до одной
    команды: авто-сборка + авто-поиск IP + пароль из secrets.h + проверка версии после рестарта.
    fw 1.5.4 (м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
2026-06-26 fix(app): при отключении от «AP» вернуть робота в AP+STA (apmode=0) — v12
    После прямого подключения (кнопка AP -> apmode=1, AP-only) робот оставался без домашнего
    WiFi до перезагрузки (недоступен для OTA/дашборда). Теперь disconnectAll шлёт apmode=0,
    пока ещё на точке робота (до WifiBinder.unbind) -> робот сам возвращается в AP+STA.
    Флаг apOnlyActive отслеживает режим. versionCode->12.
    [MainActivity.kt]
2026-06-27 perf(app): убрать лаг управления — keep-alive /drive + не опрашивать телеметрию при езде (v13)
    Замеры: /drive 18/37/134 мс (новый TCP каждый раз, скачки), keep-alive 21/31/36; /telemetry
    ~150 мс (ответ 6 КБ). Сервер платы однопоточный -> телеметрия блокирует /drive -> рывки.
    - DriveClient: keep-alive (дочитываем тело, не disconnect на успехе) -> ровные ~31 мс.
    - TelemetryPoller: busy-колбэк, не опрашиваем во время езды (джойстик активен) -> /telemetry
    не блокирует /drive.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
2026-06-27 feat: лёгкий видеопоток для прямого режима (vsize) — fw 1.5.5 / app v14
    Видео — оставшаяся тяжёлая полоса на AP. /control?vsize=qvga|vga|svga|hd (+vq=8..30) меняет
    разрешение/качество камеры на лету (set_framesize/set_quality под мьютексом камеры).
    Приложение: на «AP» запрашивает qvga (лёгкий кадр), по дому svga -> меньше полосы -> плавнее.
    Прошито по WiFi (OTA, tools/xiao_http_ota.py). Маппинг enum сенсора смещён (отчёт 6/11), но
    направление верное (qvga зам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
2026-06-27 feat(fw 1.5.6): авто-лёгкое видео (QVGA) когда робот только на своей точке
    Симптом: в прямом режиме тормозит и приложение, и веб-страница робота -> узкое место видео по
    SoftAP, а веб отдаёт камеру в дефолте (~HD). xiaoCamApplyProfile(lite) + авто-переключение в
    streamTcpTask: gApOnly || STA не подключён -> QVGA q15; дома -> SVGA q12. Лечит и веб, и приложение.
    Скомпилировано (EXIT=0); на железе НЕ проверено — робот был на своей точке, OTA недо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
2026-06-27 docs(dev-log): fw 1.5.6 проверена на железе — замеры видео (QVGA vs HD)
    Залито по USB COM7. Замеры :82: QVGA ~8КБ/кадр 70КБ/с (13 fps) против HD/SVGA ~32КБ 283КБ/с
    (3.7-9 fps). Узкая точка не тянет большие кадры -> авто-QVGA лечит. WiFi исправен (-51 dBm),
    поломка была от батареи/роуминга. /drive 27 мс.
2026-06-27 fix(fw 1.5.7): лёгкое видео по адресу клиента стрима, не по STA
    Баг 1.5.6: lite включался по gApOnly||STA-down. Но робот на батарее в зоне дома = apsta
    (STA up), телефон на точке -> условие ложно -> тяжёлый SVGA по узкой точке -> видео не
    грузится и лагает. Фикс: в streamTcpTask по c.remoteIP() в подсети softAPIP /24 -> QVGA,
    иначе SVGA. Телефон на точке всегда получает лёгкий кадр. Скомпилировано, ждёт заливки.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
    [xiao_cam_stream.ino]
